TickingClocks/64-Bit/README.md

# 64-Bit
Nixie Tube Clock driven by an STM32F446. Drives 6 IN-12 Nixie Tubes
