TickingClocks/64-Bit/Electrical/PCB Outputs/BOM and Cost.xlsx

Item Number | PCB/Area | Qty | Part Number | Description | Designator | price /each | price total | purchase link | note
1 | Main Board | 13 | GCJ188R71H104KA12D | 0.1uF, 0603 |  | 0.1 | 1.3 | mouser (https://www.mouser.com/ProductDetail/Murata-Electronics/GCJ188R71H104KA12D?qs=zThidflJDvYKuGhiQaflUg%3D%3D)
2 | Main Board | 4 | GRM319R61E106MA12D | 10 uF, 1210 |  | 0.24 | 0.96 | mouser (https://www.mouser.com/ProductDetail/Murata-Electronics/GRM319R61E106MA12D?qs=eeBpzGFlv%252B85QLY8OZY4LA%3D%3D)
3 | Main Board | 4 | CL31A226KAHNNNE | 22 uF, 1210 |  | 0.11 | 0.44 | mouser (https://www.mouser.com/ProductDetail/Samsung-Electro-Mechanics/CL31A226KAHNNNE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)
4 | Main Board | 3 | GRM188R61C105KA12J | 1 uF, 0603 |  | 0.11 | 0.33 | mouser (https://www.mouser.com/ProductDetail/Murata-Electronics/GRM188R61C105KA12J?qs=giATsht9l5zorjRVstolWw%3D%3D)
5 | Main Board | 2 | GRM188R61E475KE11D | 4.7 uF, 0603 |  | 0.1 | 0.2 | mouser (https://www.mouser.com/ProductDetail/Murata-Electronics/GRM188R61E475KE11D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)
6 | Main Board | 2 | GCM1885C2A220JA16D | 22 pF, 0603 |  | 0.1 | 0.2 | mouser (https://www.mouser.com/ProductDetail/Murata-Electronics/GCM1885C2A220JA16D?qs=2YjXvJr3xviMVh6wGaZW%252Bw%3D%3D)
7 | Main Board | 2 | -- | DNP C0603 |  | 0 | 0
8 | Main Board | 2 | GCM188R72A103KA37D | 0.01 uF, 0603 |  | 0.1 | 0.2 | mouser (https://www.mouser.com/ProductDetail/Murata-Electronics/GCM188R72A103KA37D?qs=aEuGZpxfbxXMjTExujWHsg%3D%3D)
9 | Main board | 2 | 860010578017 | 1000uF, radial capacitor, TH |  | 0.9 | 1.8 | mouser (https://www.mouser.com/ProductDetail/Wurth-Elektronik/860010578017?qs=0KOYDY2FL2%252BZYPntKa7lMw%3D%3D)
10 | Main Board | 15 | CRCW060310K0FKECC | 10 kohm, 0603 |  | 0.02 | 0.3 | mouser (https://www.mouser.com/ProductDetail/Vishay/CRCW060310K0FKECC?qs=wd5RIQLrsJjYJGKL%252BLOtbQ%3D%3D)
11 | Main Board | 14 | CRCW0603300RFKEAC | 300 ohm, 0603 |  | 0.02 | 0.28 | mouser (https://www.mouser.com/ProductDetail/Vishay/CRCW0603300RFKEAC?qs=E3Y5ESvWgWMwvWEs%2FXNQHg%3D%3D)
12 | Main Board | 13 | CRCW06031K00FKEAC | 1 kohm, 0603 |  | 0.02 | 0.26 | mouser (https://www.mouser.com/ProductDetail/Vishay/CRCW06031K00FKEAC?qs=E3Y5ESvWgWOQ7ePIWbGVFg%3D%3D)
13 | Main board | 8 | CRCW060322R0FKEAC | 22 ohm, 0603 |  | 0.1 | 0.8 | mouser (https://www.mouser.com/ProductDetail/Vishay/CRCW060322R0FKEAC?qs=E3Y5ESvWgWOyct8zbXvrzA%3D%3D)
14 | Main Board | 6 | CRCW06034K70FKEAC | 4.7 kohm, 0603 |  | 0.1 | 0.6 | mouser (https://www.mouser.com/ProductDetail/Vishay/CRCW06034K70FKEAC?qs=E3Y5ESvWgWMdaA4%252BnoVN0A%3D%3D)
15 | Main Board | 5 | CRCW060336K0FKEA | 36 kohm, 0603 |  | 0.1 | 0.5 | mouser (https://www.mouser.com/ProductDetail/Vishay/CRCW060336K0FKEA?qs=0Yv%252B5xUGNSmcsWBuyiV%2FYQ%3D%3D)
16 | Main Board | 4 | CRCW0603240KFKEA | 240 kohm, 0603 |  | 0.1 | 0.4 | mouser (https://www.mouser.com/ProductDetail/Vishay/CRCW0603240KFKEA?qs=nz%2FDziUe1SwAG9wIRcPL7Q%3D%3D)
17 | Main Board | 4 | -- | NA, 0 ohm, 0603, NA |  | 0 | 0
18 | Main Board | 2 | CRCW2010470RJNEF | 470 ohm, 2010 |  | 0.23 | 0.46 | mouser (https://www.mouser.com/ProductDetail/Vishay/CRCW2010470RJNEF?qs=UHJ2bL150zjnG4YlOSrZlQ%3D%3D)
19 | Main Board | 2 | CRCW251230K0JNEG | 30 kohm, 2512 |  | 0.26 | 0.52 | mouser (https://www.mouser.com/ProductDetail/Vishay/CRCW251230K0JNEG?qs=ushTUU0Ny6kGXVH8pXxR0g%3D%3D)
20 | Main board | 2 | CRCW060315K0FKEA | 15 kohm, 0603 |  | 0.1 | 0.2 | mouser (https://www.mouser.com/ProductDetail/Vishay/CRCW060315K0FKEA?qs=HpYJtD%2F%252BJmIvXVn2C2zFXQ%3D%3D)
21 | Main Board | 2 | CRCW06035K10FKEA | 5.1 kohm, 0603 |  | 0.1 | 0.2 | mouser (https://www.mouser.com/ProductDetail/Vishay/CRCW06035K10FKEA?qs=pfqtYUWm1IVbeSxo5oKU9A%3D%3D)
22 | Main Board | 2 | -- | 0 ohm, 0603 |  | 0.1 | 0.2
23 | Main Board | 1 | CRCW0603200KFKEBC | 200 kohm, 0603 |  | 0.1 | 0.1 | mouser (https://www.mouser.com/ProductDetail/Vishay/CRCW0603200KFKEBC?qs=wd5RIQLrsJiakUnx5aO8PQ%3D%3D)
24 | Main Board | 1 | -- | TH, photoresistor |  | 0.5 | 0.5 | amazon (https://www.amazon.com/eBoot-Photoresistor-Sensitive-Resistor-Dependent/dp/B01N7V536K)
25 | Main Board | 40 | CG0603MLC-05LE | 0603, Bidirectional TVS Diode |  | 0.14 | 5.6 | mouser (https://www.mouser.com/ProductDetail/Bourns/CG0603MLC-05LE?qs=m8myXnDJXpVyWtNNhuqisQ%3D%3D)
26 | Main Board | 2 | SK54BLF-R1_00001 | diode |  | 0.69 | 1.38 | mouser (https://www.mouser.com/ProductDetail/Panjit/SK54BLF_R1_00001?qs=sPbYRqrBIVk6ny5Uu6rUPg%3D%3D)
27 | Main Board | 1 | APG1608SURKC/T | Red LED, 0603 |  | 0.23 | 0.23 | mouser (https://www.mouser.com/ProductDetail/Kingbright/APG1608SURKC-T?qs=uxmOeTEqoPxGH1cbvEL84g%3D%3D)
28 | Main Board | 1 | APG1608CGKC/T | Green LED, 0603 |  | 0.23 | 0.23 | mouser (https://www.mouser.com/ProductDetail/Kingbright/APG1608CGKC-T?qs=uxmOeTEqoPwOMdoDiWi4nA%3D%3D)
29 | Main Board | 1 | APG1608QBC/D | Blue LED, 0603 |  | 0.45 | 0.45 | mouser (https://www.mouser.com/ProductDetail/Kingbright/APG1608QBC-D?qs=uxmOeTEqoPzUQ%252B6SHl8a5A%3D%3D)
30 | Main Board | 3 | 74HC3G34DC,125 | Signal level shifter, 3 channel |  | 1.24 | 3.72 | mouser (https://www.mouser.com/ProductDetail/Nexperia/74HC3G34DC125?qs=P62ublwmbi%252B8B4VZQ89Dzw%3D%3D)
31 | Main board | 1 | STM32F446RETx | Main STM32 Microcontroller |  | 7.55 | 7.55 | mouser (https://www.mouser.com/ProductDetail/STMicroelectronics/STM32F446RET6?qs=Ok1pvOkw6%2FqpQsWf8F4wtQ%3D%3D)
32 | Main board | 1 | PCA9306DCUR | I2C Level Shifter |  | 0.67 | 0.67 | mouser (https://www.mouser.com/ProductDetail/Texas-Instruments/PCA9306DCUR?qs=wgAEGBTxy7nQr5PRxNBUNA%3D%3D)
33 | Main Board | 1 | DS1307 | I2C RTC |  | 4.65 | 4.65 | mouser (https://www.mouser.com/ProductDetail/Analog-Devices-Maxim-Integrated/DS1307Z%2bTR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)
34 | Main Board | 1 | EN12-VS20AF20 | Encoder w button, RA |  | 1.3 | 1.3 | mouser (https://www.mouser.com/ProductDetail/BI-Technologies-TT-Electronics/EN12-VS20AF20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)
35 | Main Board | 1 | 24LC64F-I/SN | I2C EEPROM |  | 0.5 | 0.5 | mouser (https://www.mouser.com/ProductDetail/Microchip-Technology/24LC64F-I-SN?qs=WqWCsLCZBkrFG%252B0OmVeJ8Q%3D%3D)
36 | Main Board | 1 | ESP32-C6-LCD-1.47 | ESP32-C6 1.47" LCD dev board |  | 20 | 20 | amazon (https://www.amazon.com/Waveshare-Development-Frequency-Single-Core-Processor/dp/B0DHTMYTCY)
37 | Main Board | 2 | -- | female headers for ESP board |  | 0 | 0 |  | use what I have at home
38 | Main Board | 1 | VEML7700-TR | I2C, high resolution ambient light sensor |  | 0.83 | 0.83 | mouser (https://www.mouser.com/ProductDetail/Vishay-Semiconductors/VEML7700-TR?qs=BcfjnG7NVaWcZHs8m27pyQ%3D%3D)
39 | Main Board | 2 | CM8V-T1A-32.768kHz-12.5pF-20PPM-TA-QC | 32.768kHz crystals |  | 0.38 | 0.76 | mouser (https://www.mouser.com/ProductDetail/Micro-Crystal/CM8V-T1A-32.768kHz-12.5pF-20PPM-TA-QC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)
40 | Main Board | 1 | ECS-160-20-33-TR3 | 16 mHz crystal |  | 0.37 | 0.37 | mouser (https://www.mouser.com/ProductDetail/ECS/ECS-160-20-33-TR3?qs=e8oIoAS2J1R7I5xgTslvVQ%3D%3D)
41 | Main Board | 1 | L102011MS02Q | Power source switch, TH |  | 3.54 | 3.54 | mouser (https://www.mouser.com/ProductDetail/CK/L102011MS02Q?qs=m%252BSHaab3AgrintD9BMqbYQ%3D%3D)
42 | Main Board | 8 | 1985195 | spring wire connector |  | 0.37 | 2.96 | mouser (https://www.mouser.com/ProductDetail/Phoenix-Contact/1985195?qs=nq%2FEIFkB2fEpUV%252BqAaKYzQ%3D%3D)
43 | Main Board | 7 | 2N7002 | 2N7002 |  | 0.52 | 3.64 | mouser (https://www.mouser.com/ProductDetail/onsemi-Fairchild/2N7002?qs=0dwsXDNhqlz66WJJhrTFjQ%3D%3D)
44 | Main Board | 4 | XP231P0201TR-G | P Channel Mosfet |  | 0.26 | 1.04 | mouser (https://www.mouser.com/ProductDetail/Torex-Semiconductor/XP231P0201TR-G?qs=BJlw7L4Cy798pkoM8NVD2Q%3D%3D)
45 | Main Board | 3 | JS-12N-K | high voltage relays |  | 2.93 | 8.79 | mouser (https://www.mouser.com/ProductDetail/FCL-Components/JS-12N-K?qs=%2FFYF3x1u%252Buf98G1in7NiWA%3D%3D)
46 | Main Board | 2 | AZ1117CH2-5.0TRG1 | 5V LDO |  | 0.22 | 0.44 | mouser (https://www.mouser.com/ProductDetail/Diodes-Incorporated/AZ1117CH2-5.0TRG1?qs=5V6w%252Be2aIqb578qtLdqPjw%3D%3D)
47 | Main Board | 2 | AZ1117CH2-3.3TRG1 | 3.3V LDO |  | 0.22 | 0.44 | mouser (https://www.mouser.com/ProductDetail/Diodes-Incorporated/AZ1117CH2-3.3TRG1?qs=lQAVKuKFhkLc7jCxso2G3w%3D%3D)
48 | Main Board | 1 | BAT-HLD-001 | CR2032 Battery Holder |  | 0.38 | 0.38 | mouser (https://www.mouser.com/ProductDetail/TE-Connectivity-Linx-Technologies/BAT-HLD-001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)
49 | Main Board | 2 | -- | pin header jumper |  | 0 | 0 |  | use what I already have
50 | Main Board | 1 | PR30-5V-450-1A-E | relay, 5V coil |  | 1.11 | 1.11 | mouser (https://www.mouser.com/ProductDetail/Same-Sky/PR30-5V-450-1A-E?qs=ZcfC38r4Potim%2FTJWnEvrQ%3D%3D)
51 | Main Board | 1 | PR30-12V-450-1A-E | relay, 12V coil |  | 1.37 | 1.37 | mouser (https://www.mouser.com/ProductDetail/Same-Sky/PR30-12V-450-1A-E?qs=ZcfC38r4Pot83EsX0vii6w%3D%3D)
52 | Main Board | 1 | XL6009 Module | boost converter module |  | 2 | 2 | amazon (https://www.amazon.com/dp/B0C81RQ4CN?ref_=ppx_hzsearch_conn_dt_b_fed_asin_title_2)
53 | Main Board | 1 | -- | high voltage power supply module |  | 11 | 11 | amazon (https://www.amazon.com/dp/B09D93QNYK?ref_=ppx_hzsearch_conn_dt_b_fed_asin_title_1&th=1)
54 | Main Board | 10 | M20-7920242R | female, SMT, 4 pin dupont connector |  | 0.81 | 8.1 | mouser (https://www.mouser.com/ProductDetail/Harwin/M20-7920242R?qs=k41KVqW3ymqXpU6ZyqY%252B2g%3D%3D)
55 | Main Board | 3 | 61301021821 | female board to board connectors |  | 1.58 | 4.74 | mouser (https://www.mouser.com/ProductDetail/Wurth-Elektronik/61301021021?qs=ZtY9WdtwX56X%2F8LrwHRgHg%3D%3D)
56 | Main Board | 1 | USB4216-03-A | USB C Connector |  | 0.62 | 0.62 | mouser (https://www.mouser.com/ProductDetail/GCT/USB4216-03-A?qs=Tc%252BHE9vUsnv1G2UWLFIexA%3D%3D)
57 | Main Board | 1 | PJ-102A | Power Connector |  | 0.58 | 0.58 | mouser (https://www.mouser.com/ProductDetail/Same-Sky/PJ-102A?qs=WyjlAZoYn50UKjtnxOz%252Bqg%3D%3D)
58 | Main Board | 1 | 97384645 | Coin cell |  | 0.34 | 0.34 | mouser (https://www.mouser.com/Tools/Project/Details?projectGUID=67f004be-61d0-41fa-bba2-e4882123ddfc)
59 | Display Board | 8 | GCJ188R71H104KA12D | 0.1 uF, 0603 |  | 0.1 | 0.8 | mouser (https://www.mouser.com/ProductDetail/Murata-Electronics/GCJ188R71H104KA12D?qs=zThidflJDvYKuGhiQaflUg%3D%3D)
60 | Display Board | 6 | CRCW1210249KFKEA | 249 kohm, 1210 |  | 0.19 | 1.14 | mouser (https://www.mouser.com/ProductDetail/Vishay/CRCW1210249KFKEA?qs=u0pLYIWDdLeW%252BEKXIu9Hbg%3D%3D)
61 | Display Board | 6 | CRCW121015K0FKEA | 15 kohm, 1210 |  | 0.12 | 0.72 | mouser (https://www.mouser.com/ProductDetail/Vishay/CRCW121015K0FKEA?qs=bw5uWrxixdSFp1cY0NcfxA%3D%3D)
62 | Display board | 6 | CG0603MLC-05LE | 0603, bidirectional TVS Diodes |  | 0.14 | 0.84 | mouser (https://www.mouser.com/ProductDetail/Bourns/CG0603MLC-05LE?qs=m8myXnDJXpVyWtNNhuqisQ%3D%3D)
63 | Display Board | 8 | TPIC6B595 | HV shift registers |  | 1.47 | 11.76 | mouser (https://www.mouser.com/ProductDetail/Texas-Instruments/TPIC6B595DWR?qs=w32V8uFkMxk11fsXFu3cTA%3D%3D)
64 | Display Board | 6 | IN-12A | Nixie Tubes |  |  | 50 | ebay (https://www.ebay.com/itm/141833775275?_skw=in12+nixie&itmmeta=01KBBYV0734VEJCEHVSZM2ANAR)
65 | Display Board | 72 | -- | 1mm nixie tube pin socket |  |  | 10 | amazon (https://www.amazon.com/dp/B09D2VQR3Q?ref_=ppx_hzsearch_conn_dt_b_fed_asin_title_7&th=1)
66 | Display Board | 6 | INS-1 | Neon Bulb |  |  | 20 | ebay (https://www.ebay.com/itm/227032759689?_skw=ins-1&itmmeta=01KBBYYDXXQJ9ZTY8F34NHPWKH)
67 | Display Board | 6 | 3D print | INS-1 3D Printed bases |  | 0 | 0 |  | negligible price in plastic
68 | Display Board | 3 | -- | 3 pin, pin socket connector |  | 0 | 0 |  | use what I already have
69 | Display Board | 3 | 610110249121 | smt board to board connectors |  | 2.16 | 6.48 | mouser (https://www.mouser.com/ProductDetail/Wurth-Elektronik/610110249121?qs=a9WhcLg8qCzIr%252B0m4JFDmA%3D%3D)
70 | LED Board | 6 | GCJ188R71H104KA12D | 0.1 uF, 0603 |  | 0.1 | 0.6 | mouser (https://www.mouser.com/ProductDetail/Murata-Electronics/GCJ188R71H104KA12D?qs=zThidflJDvYKuGhiQaflUg%3D%3D)
71 | LED Board | 1 | CRCW0603300RFKEAC | 300 ohm, 0603 |  | 0.1 | 0.1 | mouser (https://www.mouser.com/ProductDetail/Vishay/CRCW0603300RFKEAC?qs=E3Y5ESvWgWMwvWEs%2FXNQHg%3D%3D)
72 | LED Board | 6 | WS2812B | Addressable RGB LEDs |  | 0 | 0 |  | use what I already have
73 | LED Board | 2 |  | 3 pin, pin header connector |  | 0 | 0 |  | use what I already have
74 | Case/Frame | 1 |  | 3D printed base |  |  | 3 |  | assuming plastic cost here
75 | Case/Frame |  |  | Picture pane glass |  |  | 19 | amazon (https://www.amazon.com/dp/B0BWDWKTB6?ref_=ppx_hzsearch_conn_dt_b_fed_asin_title_1&th=1)
76 | Case/Frame |  |  | brass m3 standoffs |  |  | 15 | amazon (http://amazon.com/Csdtylh-Male-Female-Standoff-Stainless-Assortment/dp/B06Y5TJXY1)
77 | Case/Frame |  |  | brass m3 acorn nuts
78 | Case/Frame |  |  | copper conductive tape |  |  | 6 | amazon (https://www.amazon.com/dp/B09WGYP2VR?ref_=ppx_hzsearch_conn_dt_b_fed_asin_title_3)
79 | Case/Frame |  |  | spring pogo pins |  |  | 7 | amazon (https://www.amazon.com/dp/B0F48W46WZ?ref_=ppx_hzsearch_conn_dt_b_fed_asin_title_6)
80 | Case/Frame |  |  | wires |  |  | 0 |  | use what I already have
81 | Case/Frame |  |  | Connectors |  |  | 0
82 | Case/Frame |  |  | capacitive buttons |  |  | 6 | amazon (https://www.amazon.com/dp/B0BFZXP1D8?ref_=ppx_hzsearch_conn_dt_b_fed_asin_title_2)
83 | Case/Frame |  |  | lead weights |  |  | 21 | amazon (https://www.amazon.com/dp/B06XDG1JJH?ref_=ppx_hzsearch_conn_dt_b_fed_asin_title_1&th=1)
84 | Case/Frame |  |  | usbA male -> usbC female adapter |  |  | 5.5 | amazon (http://amazon.com/Adapter-Transfer-Connector-Bi-Directional-Extension/dp/B0DT4FMHF2?nsdOptOutParam=true)
85 | Case/Frame |  |  | stm32 programmer |  |  | 6 | amazon (https://www.amazon.com/AITRIP-Emulator-Downloader-Programmer-STM32F103C8T6/dp/B0D22S8WVX)
86 | Case/Frame |  |  | m3 screws |  |  | 0 |  | use what I already have
87 | PCB | 5 | Main Board PCB | Main Board PCB, black solder mask, ENIG |  | 0 | 75.53 |  | min x5 order required
88 | PCB | 5 | Display Board PCB | Display Board PCB, black solder mask, ENIG |  | 0 | 72.63 |  | min x5 order required
89 | PCB | 5 | LED Board PCB | LED Board PCB, black solder mask, ENIG |  | 0 | 22.2 |  | min x5 order required
90 | Stencil | 2 | solder stencils for Main board | solder stencils for SMT assembly |  | 7 | 14
91 | Stencil | 2 | solder stencils for display board | solder stencils for SMT assembly |  | 7 | 14
92 | Stencil | 1 | LED Board Solder Stencil | Solder stencils for SMT assembly |  | 7 | 7
93 | Shipping | 1 | PCB and stencils shipping | shipping for the PCBs |  | 0 | 140
94 | shipping | 1 | shipping for Mouser parts | Mouser shipping |  | 8.99 | 8.99
95 | Tariff | 1 | Mouser Parts estimated tariff |  |  | 0 | 0
96 | Tariff | 1 | JLC PCB Parts estimated tariff |  |  | 0 | 160
 |  |  | total (pcbs and customs) | total (parts not pcbs) | Total (min to build 1)
 |  |  | 514.35 | 301.02 | 815.37
 |  |  | Cost of 1 clock assuming 2 are made | Cost of 1 clock assuming 3 are made
 |  |  | 558.195 | 472.47
