TickingClocks/64-Bit/Electrical/PCB Outputs/64 Bit - Display Board/3D prints/ins-1 standoff/INS-1 standdoff.SLDPRT

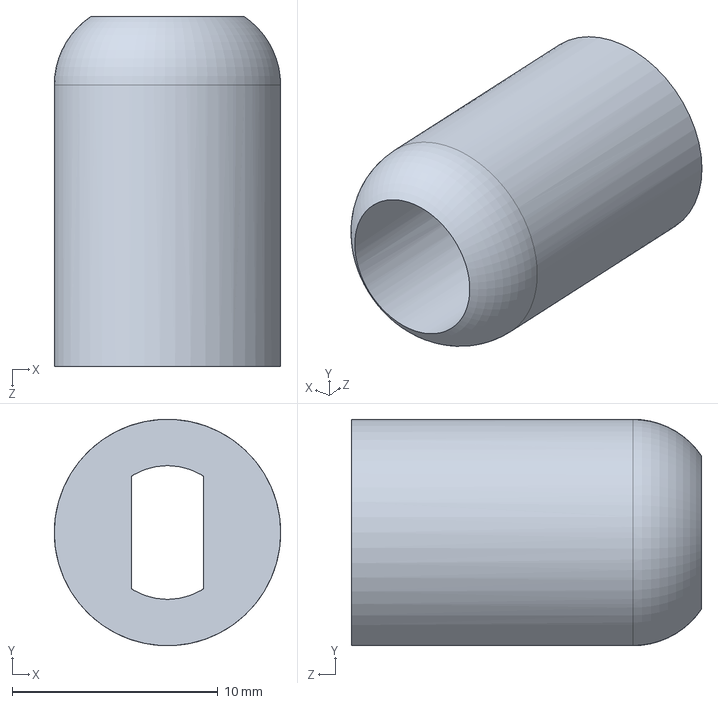
[picture p1: CAD file, 2025-12-22]
Electrical/PCB Outputs/64 Bit - Display Board/3D prints/ins-1 standoff/INS-1 standdoff.SLDPRT
11.0 x 11.0 x 17.0 mm
