TickingClocks/64-Bit/(list of files, cad)

Other CAD files:
Electrical/PCB Outputs/64 Bit - Display Board/3D prints/Paste and Assembly Jig/64Bit - Display Board - Paste and assembly jig_V1.STEP
Electrical/PCB Outputs/64 Bit - Main Board/3D Prints/Paste and assembly jig/64Bit - Main Board - Paste and assembly jig_V1.STEP
Electrical/PCB Outputs/64 Bit - Main Board/step/64 Bit - main board V1 (basic)_barePCB.step
Electrical/PCB Outputs/64 Bit - Main Board/step/64 Bit - main board V1_barePCB.step
Electrical/PCB Outputs/64 Bit - Display Board/step/64 Bit Display Board.step
Electrical/PCB Outputs/64 Bit - LED Board/step/64 Bit LED Board_V1.step
Electrical/PCB Outputs/64 Bit - Display Board/step/64 Bit Display Board_BlankPCB.step
Electrical/PCB Outputs/64 Bit - Display Board/3D prints/ins-1 standoff/INS-1 standdoff_v4.STEP
Electrical/PCB Outputs/64 Bit - Display Board/3D prints/ins-1 standoff/INS-1 standdoff_v2.STEP
Electrical/PCB Outputs/64 Bit - Display Board/3D prints/ins-1 standoff/INS-1 standdoff_v3.STEP
Electrical/PCB Outputs/64 Bit - Display Board/3D prints/Paste and Assembly Jig/64Bit - Display Board - Paste and assembly jig_V1.SLDPRT
Electrical/PCB Outputs/64 Bit - Main Board/3D Prints/Paste and assembly jig/64Bit - Main Board - Paste and assembly jig_V1.SLDPRT
