TickingClocks/64-Bit/Electrical/PCB Outputs/64 Bit - Main Board/Schematics/64 Bit - Main Board.pdf

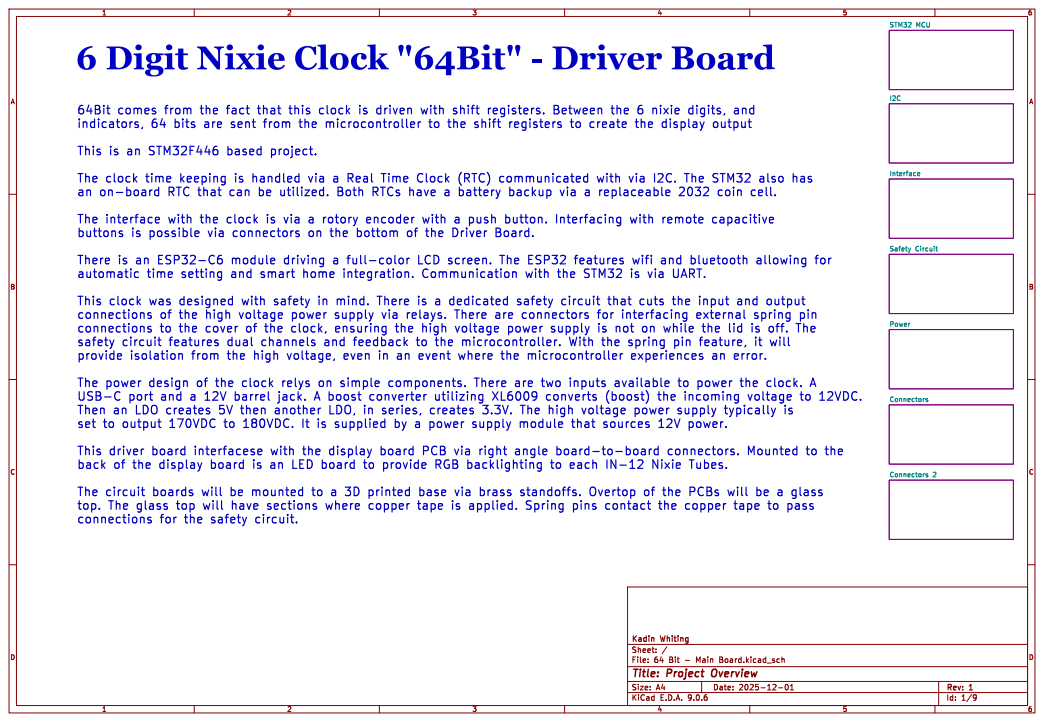
[picture p2: page 1]

6 Digit Nixie Clock "64Bit" - Driver Board

Id: 1/9 Title: Project Overview

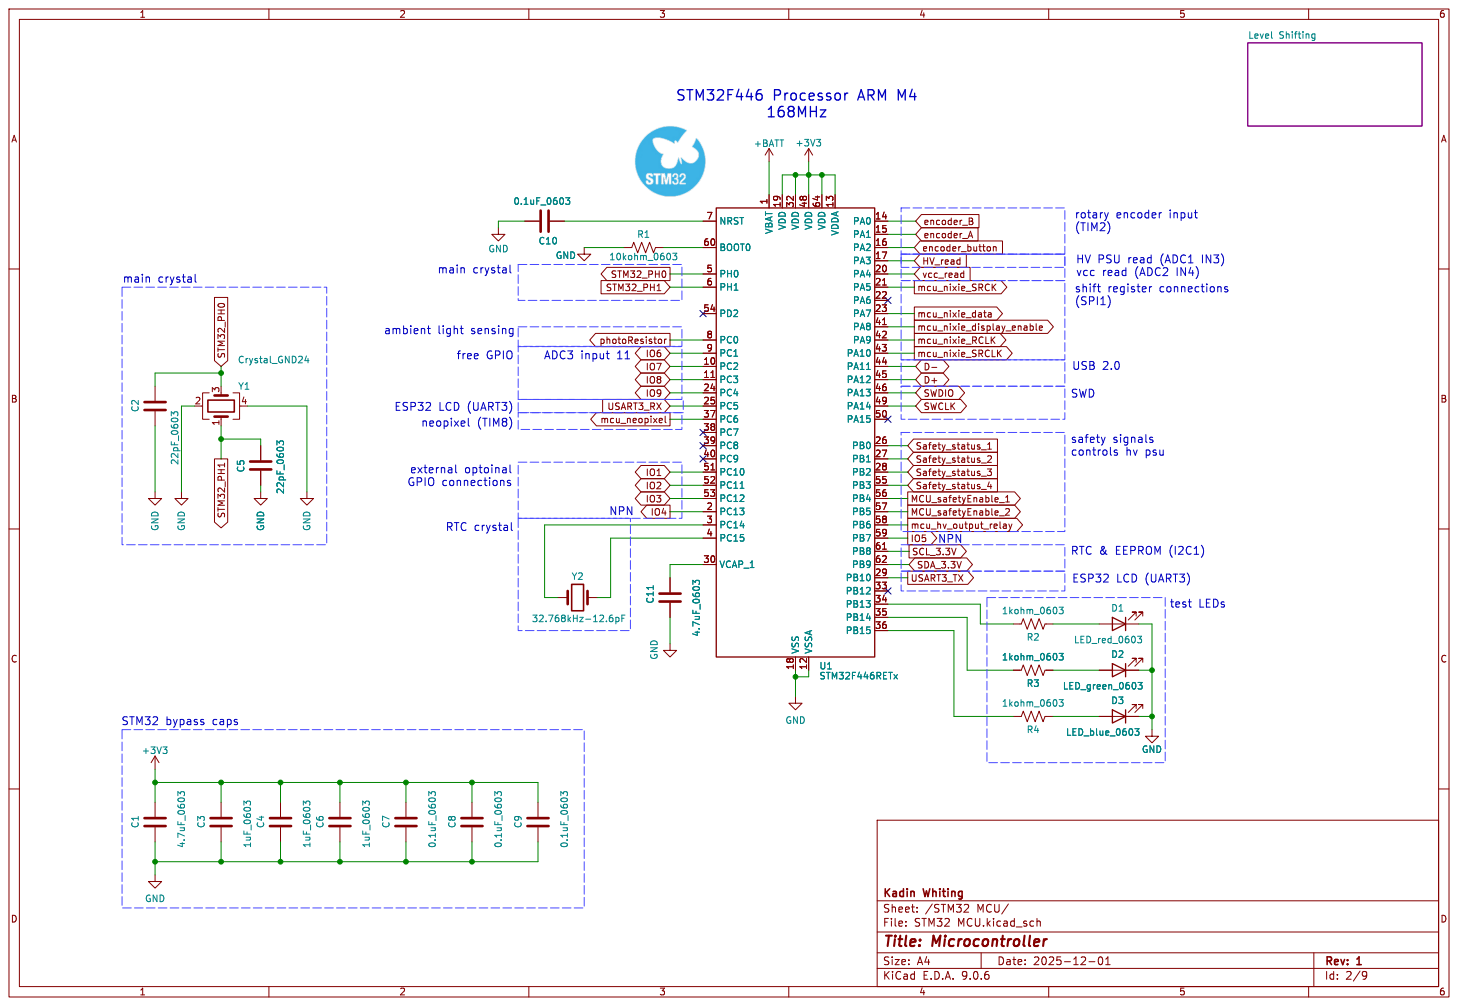
[picture p3: page 2]

1 VDD 19 VDD 32 VSS 18 VDD 48 VSSA 12 VDD 64 VDDA 13 PA0 14 PA1 15 PA2 16 PA3 17 PA4 20 PA5 21 PA6 22 PA7 23 PA8 41 PA9 42 PA10 43 PA11 44 PA12 45 PA13 46 PA14 49 PA15 50 PB0 26 PB1 27 PB2 28 PB3 55 PB4 56 PB5 57 PB6 58 PB7 59 PB8 61 PB9 62 PB10 29 PB12 33 PB13 34 PB14 35 PB15 36 U1STM32F446RETx 1

1 VDD 19 VDD 32 VSS 18 VDD 48 VSSA 12 VDD 64 VDDA 13 PA0 14 PA1 15 PA2 16 PA3 17 PA4 20 PA5 21 PA6 22 PA7 23 PA8 41 PA9 42 PA10 43 PA11 44 PA12 45 PA13 46 PA14 49 PA15 50 PB0 26 PB1 27 PB2 28 PB3 55 PB4 56 PB5 57 PB6 58 PB7 59 PB8 61 PB9 62 PB10 29 PB12 33 PB13 34 PB14 35 PB15 36 GND

HV PSU read (ADC1 IN3) vcc read (ADC2 IN4)

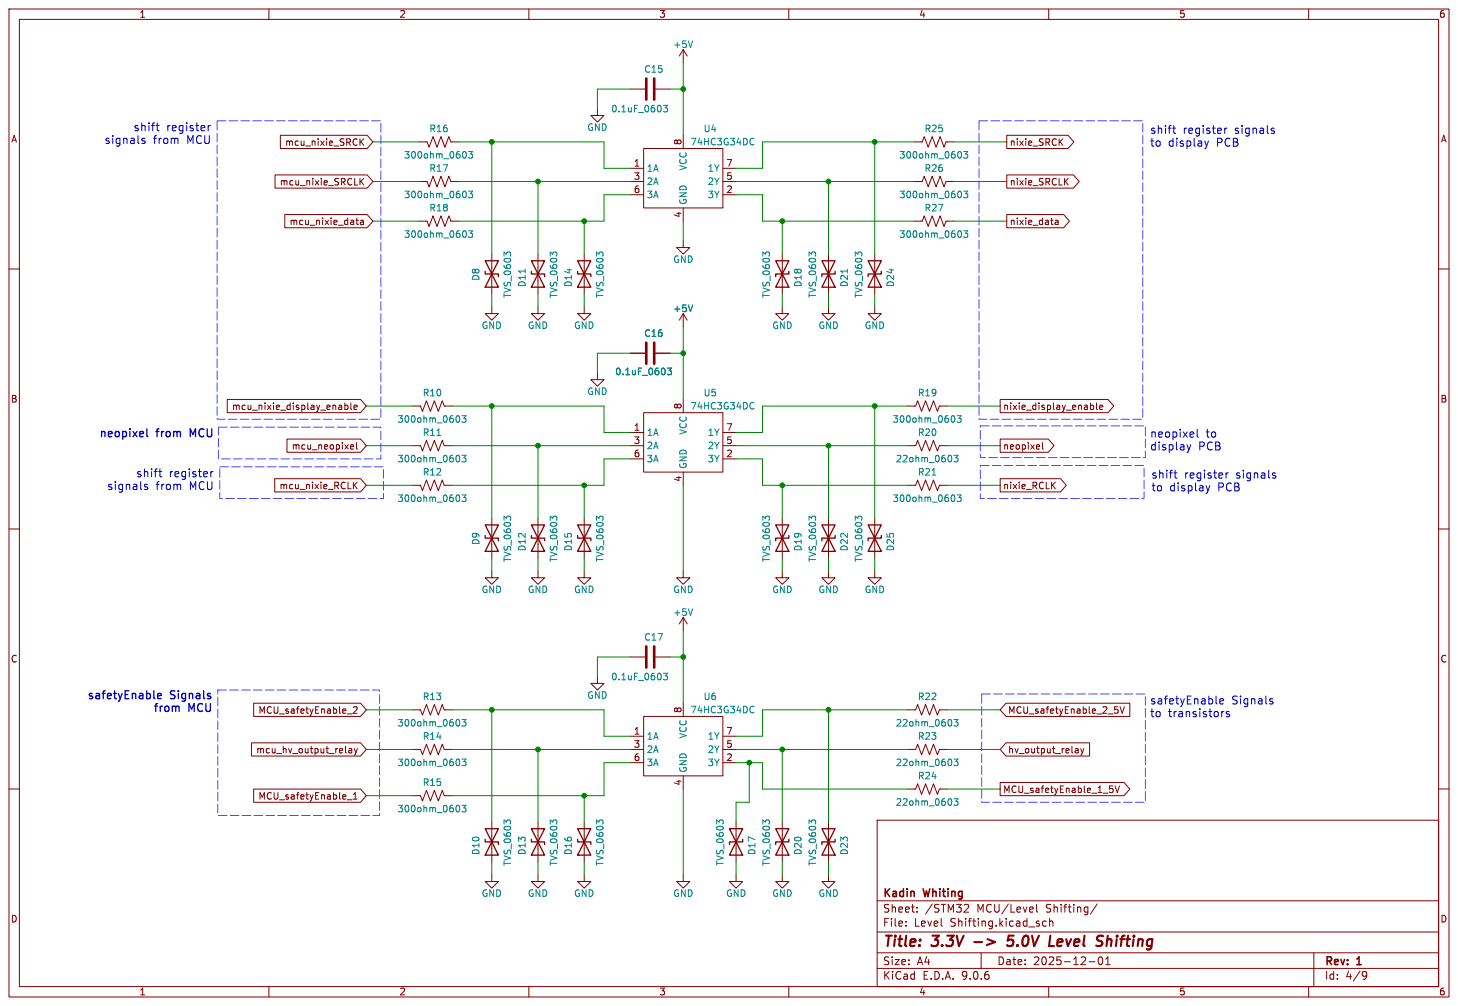
[picture p4: page 3]

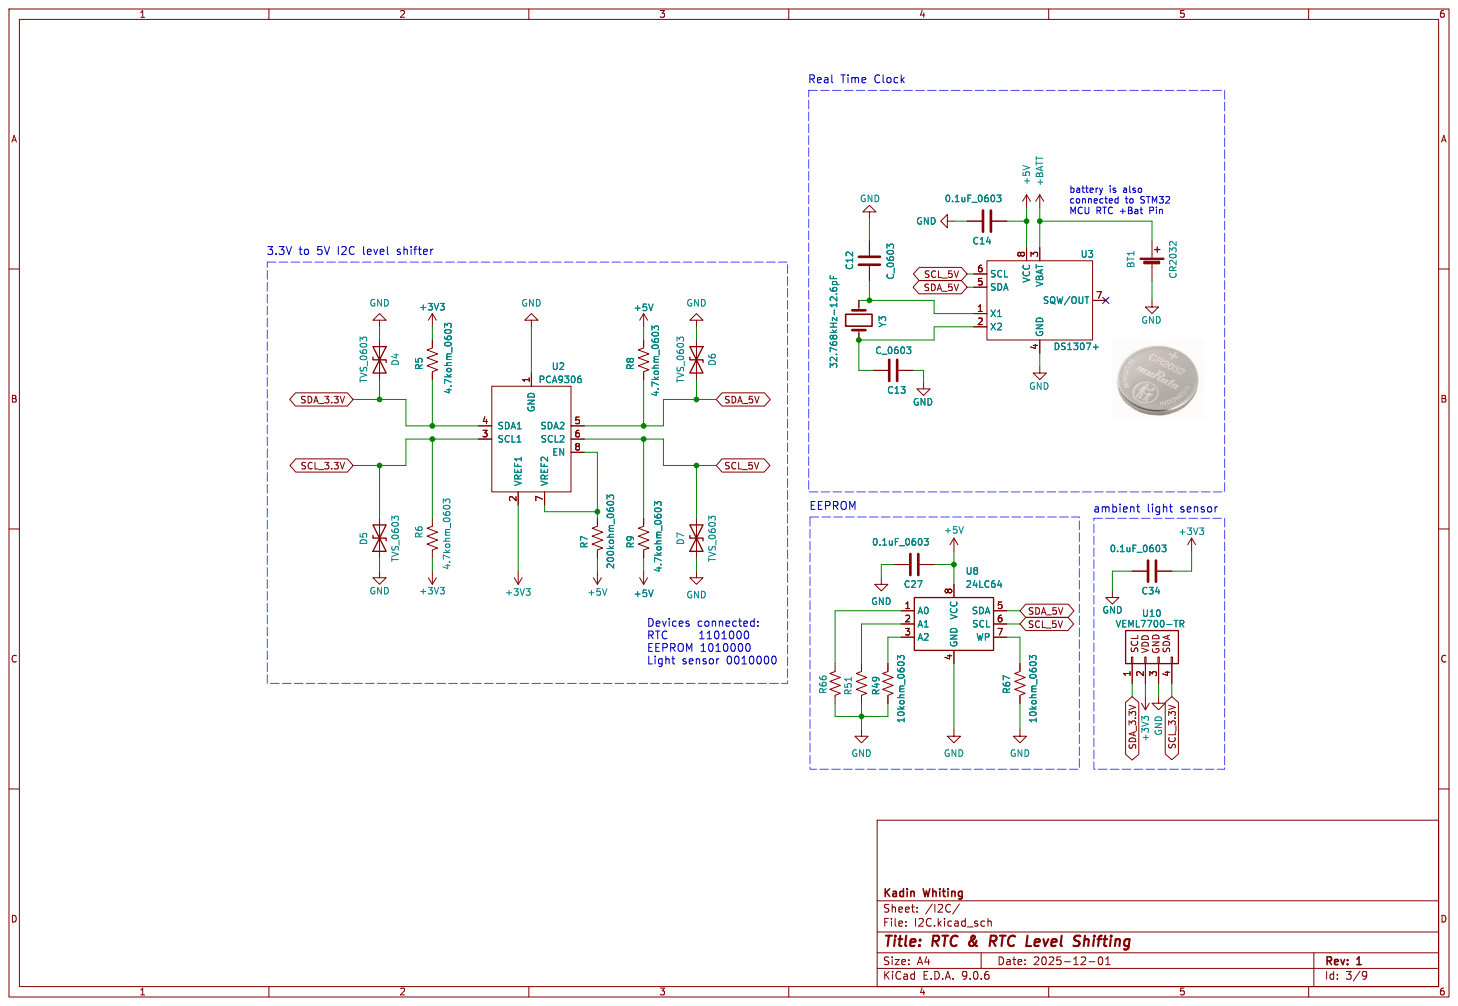
[picture p5: page 4]

File: I2C.kicad_sch Sheet: /I2C/ Kadin Whiting

Id: 3/9 Title: RTC & RTC Level Shifting

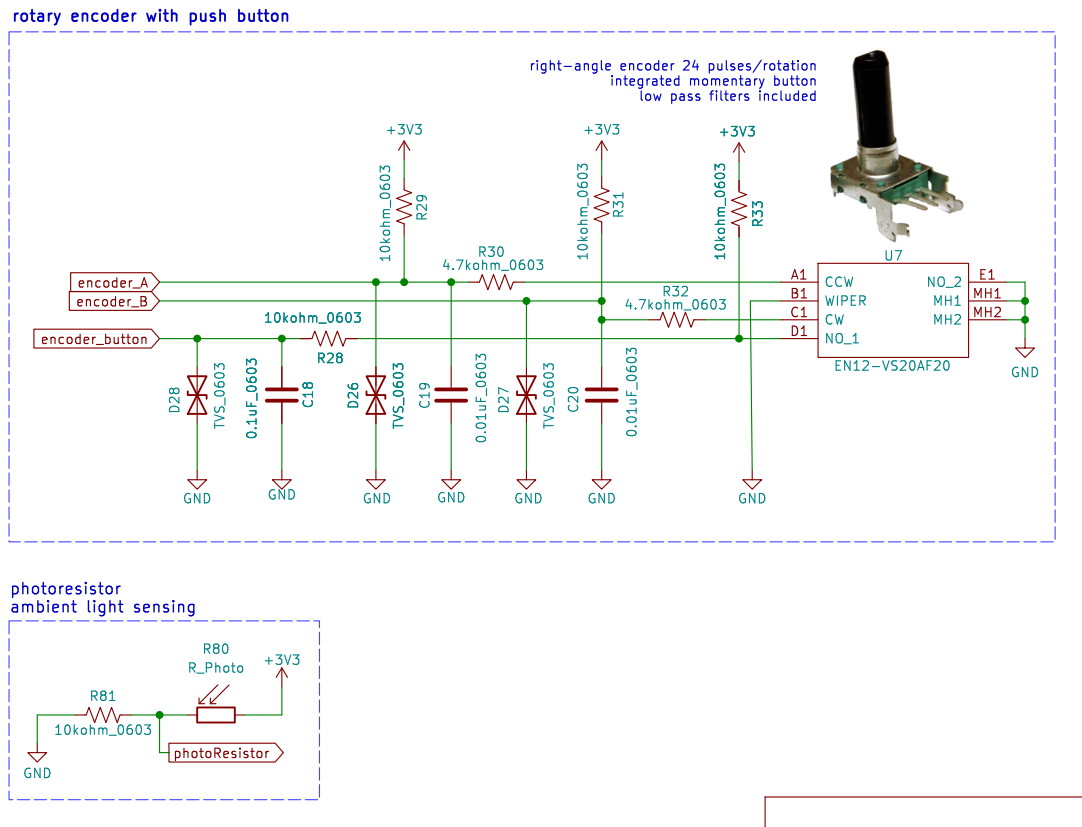
[picture p6: page 5]

encoder_B photoresistor ambient light sensing

Id: 5/9 Title: Interface - Rotary Encoder File: Interface.kicad_sch Sheet: /Interface/ Kadin Whiting R81

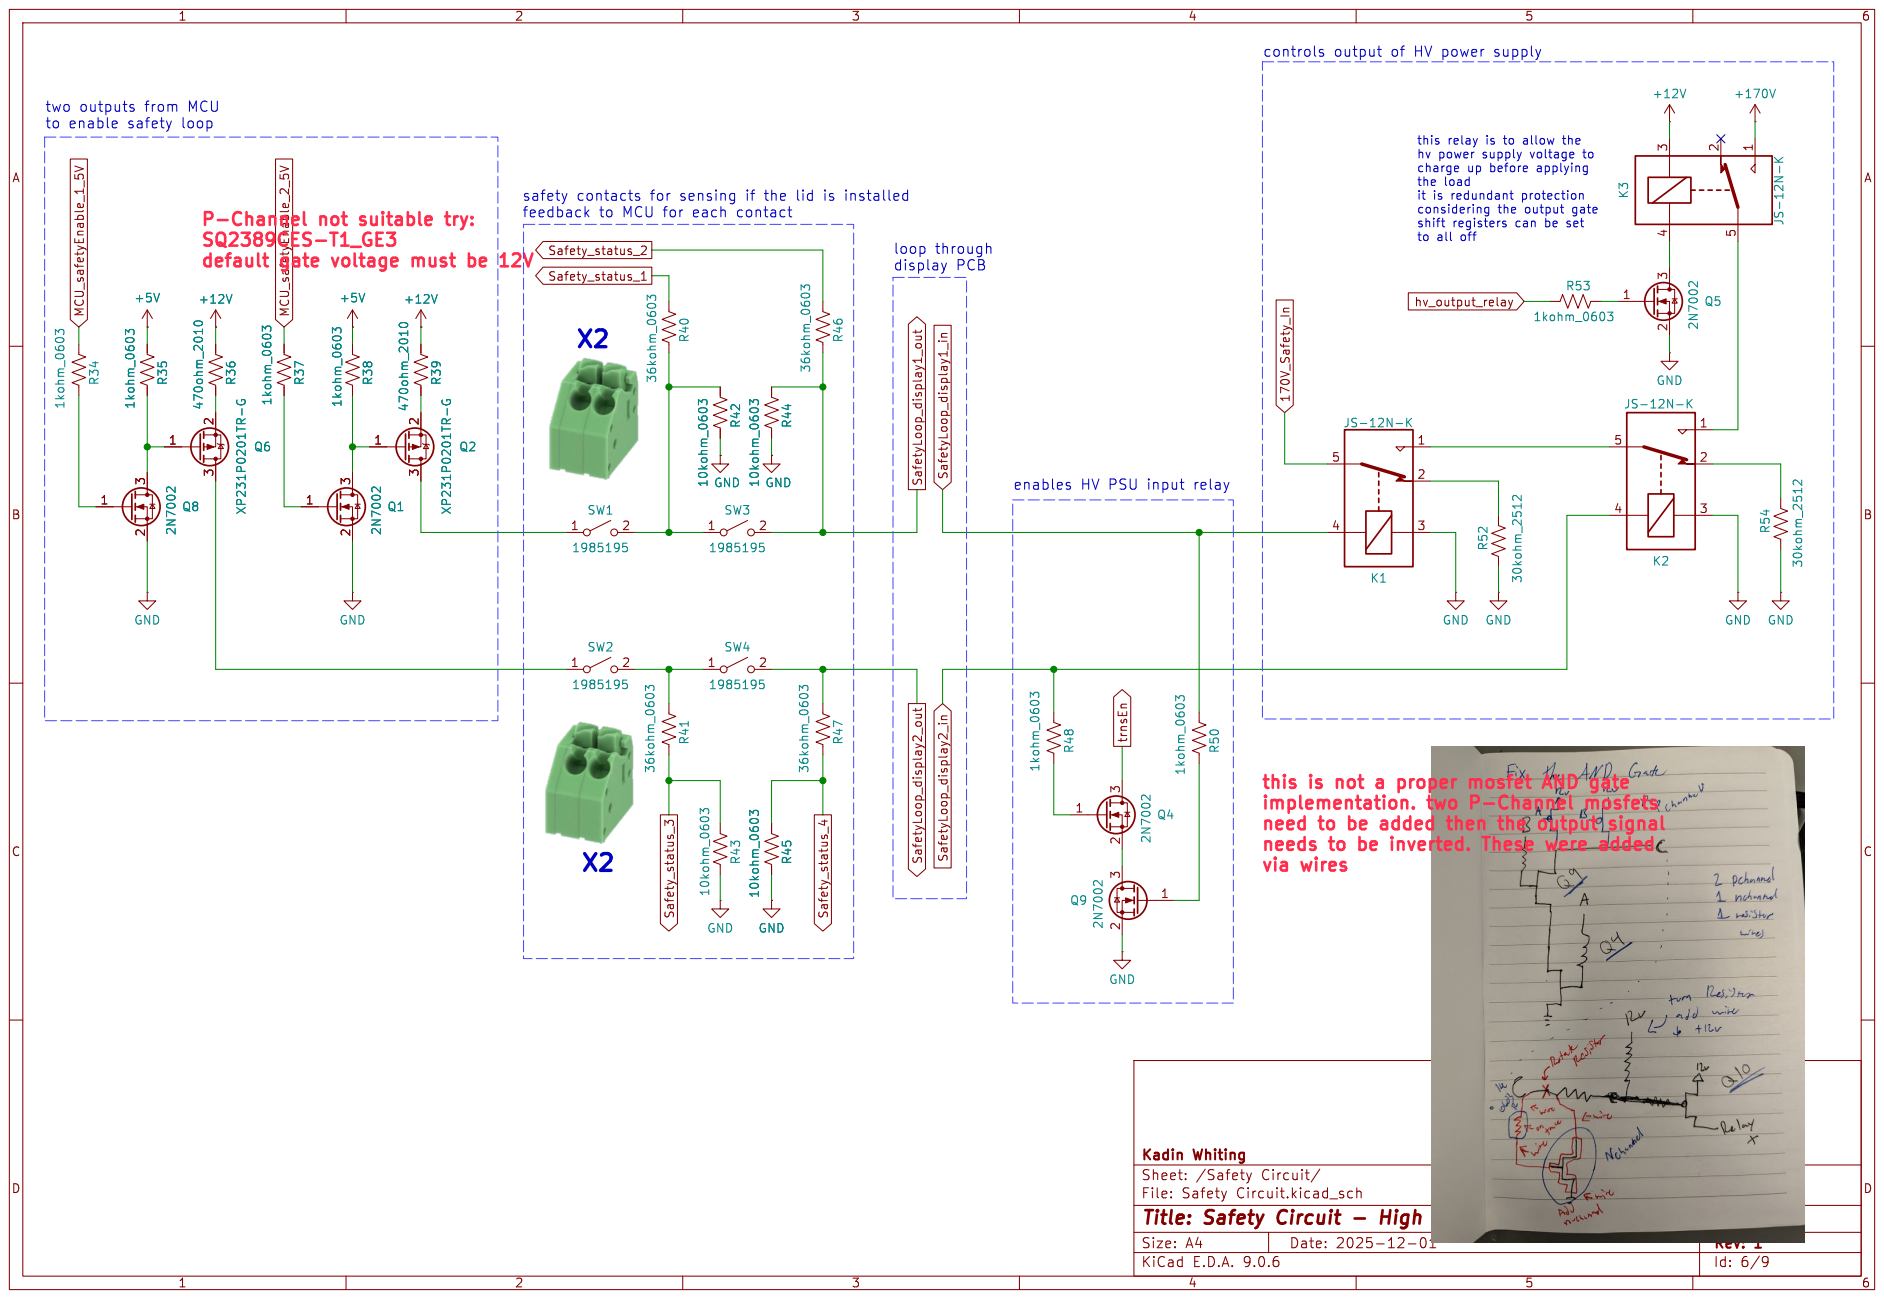
[picture p7: page 6]

+170V R34 1kohm_0603
two outputs from MCU
to enable safety loop

this relay is to allow the
hv power supply voltage to
charge up before applying
the load

SQ2389CES-T1_GE3
default gate voltage must be 12V

this is not a proper mosfet AND gate
need to be added then the output signal
needs to be inverted. These were added
via wires

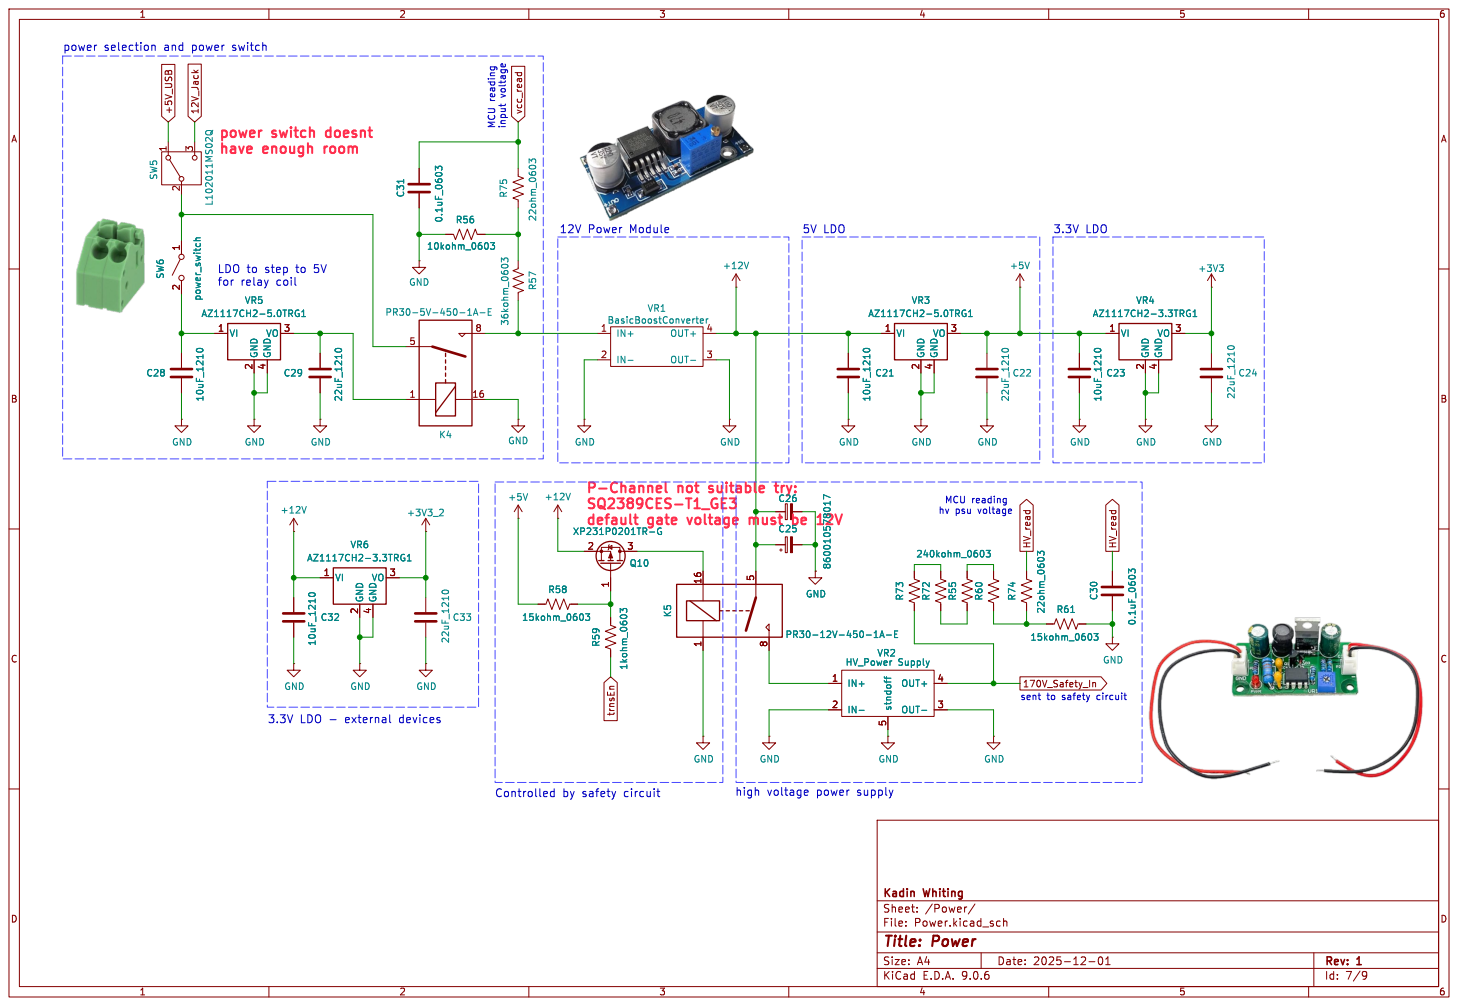
[picture p8: page 7]

high voltage power supply MCU reading input voltage

sent to safety circuit power switch doesnt
have enough room

LDO to step to 5V

SQ2389CES-T1_GE3
default gate voltage must be 12V

Id: 7/9 Title: Power File: Power.kicad_sch Sheet: /Power/ Kadin Whiting

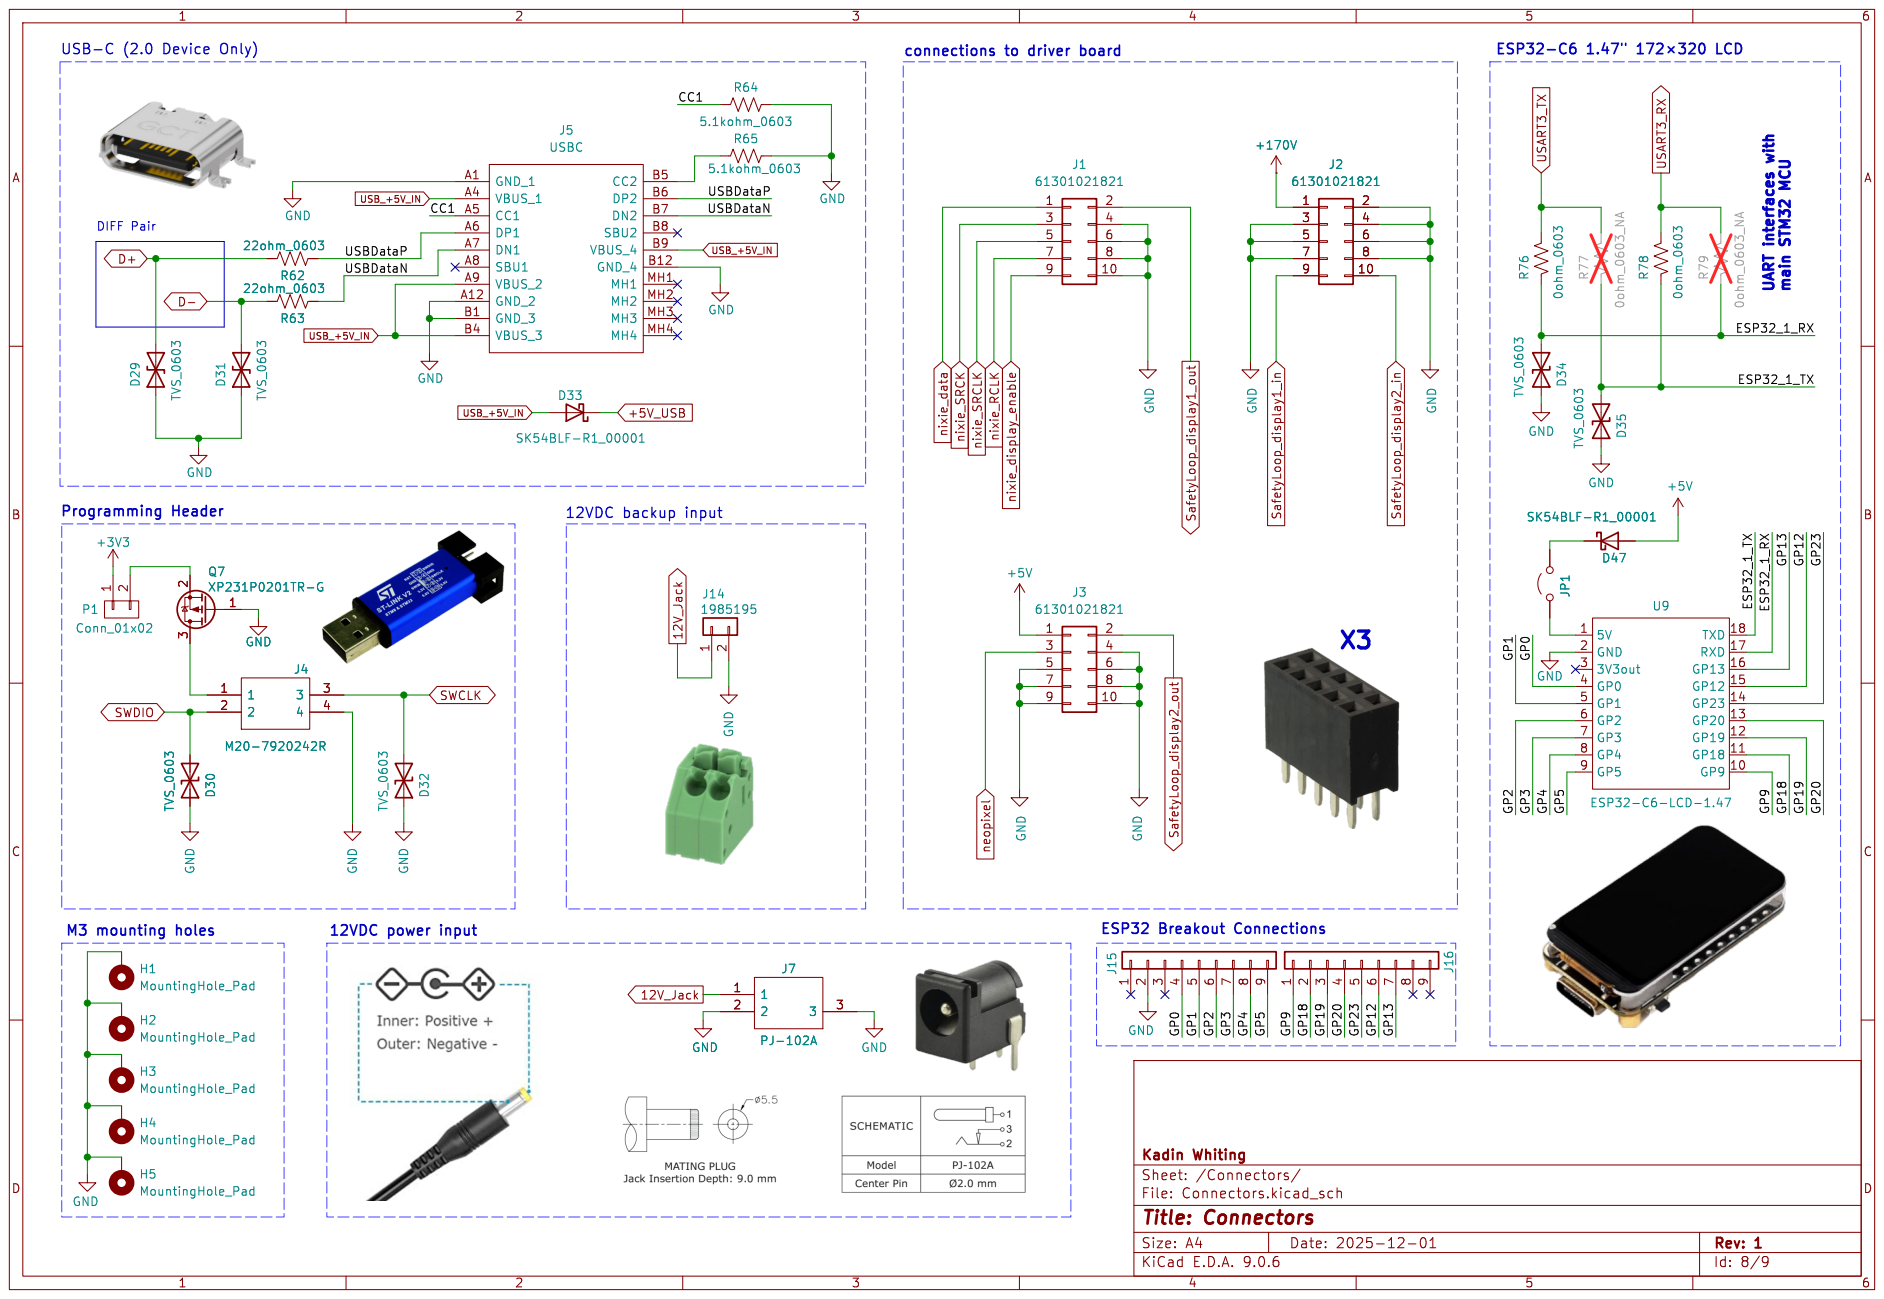
[picture p9: page 8]

9 J15 GND GND D29 TVS_0603 D31 GND TVS_0603 GND GND GND
USB_+5V_IN D- D+

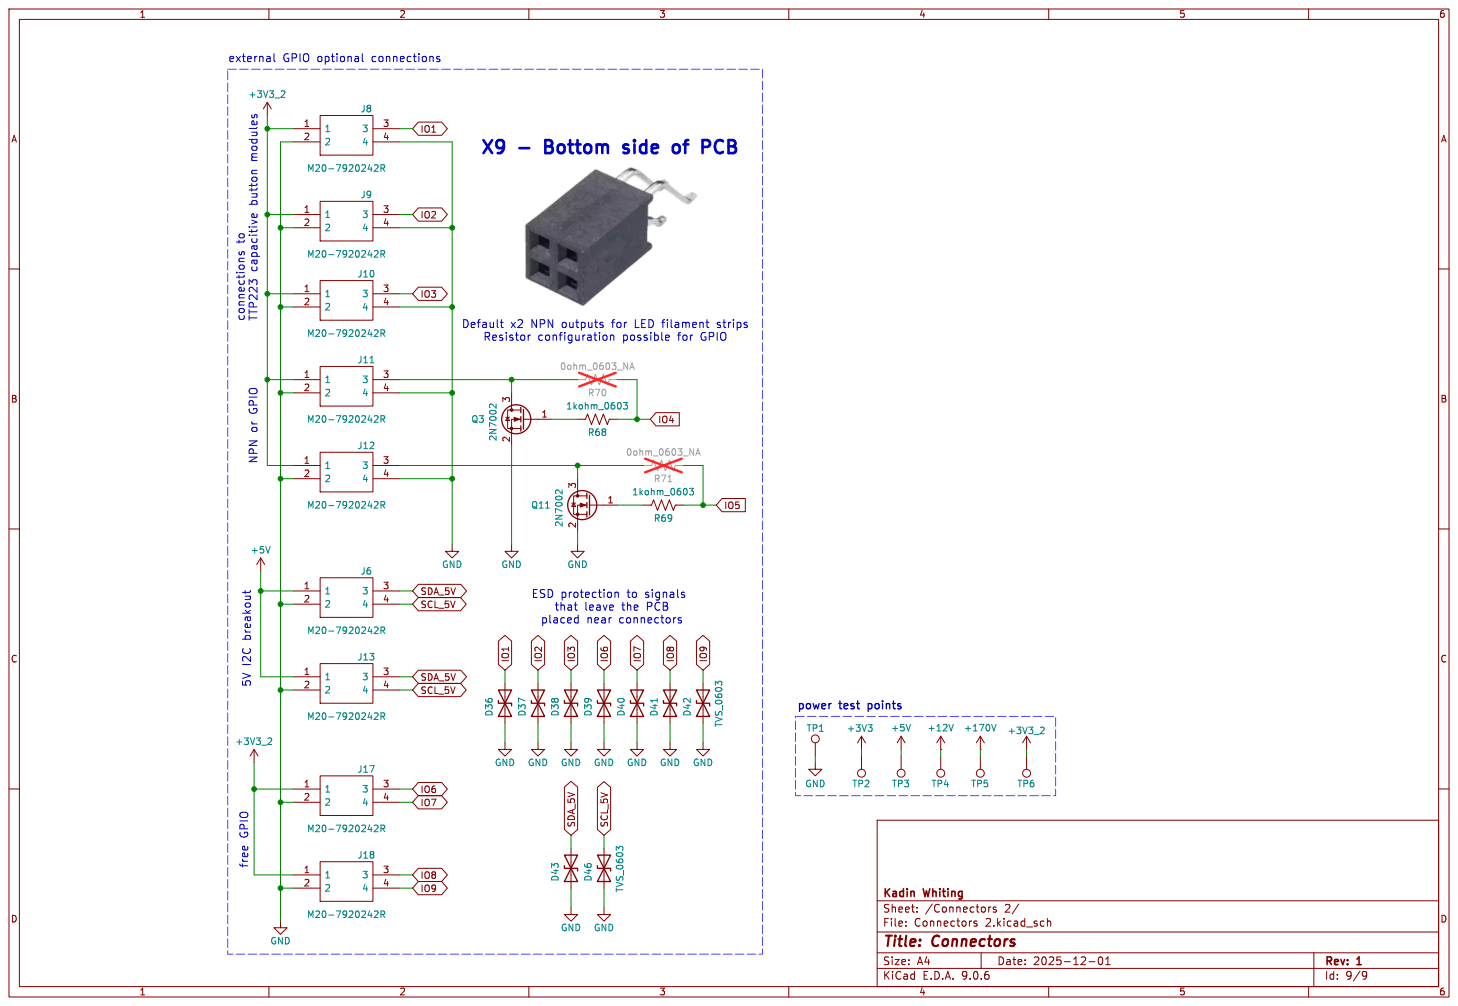
[picture p10: page 9]

X9 - Bottom side of PCB

that leave the PCB
