TickingClocks/64-Bit/Electrical/PCB Outputs/64 Bit - Display Board/Schematics/64 Bit - Display Board.pdf

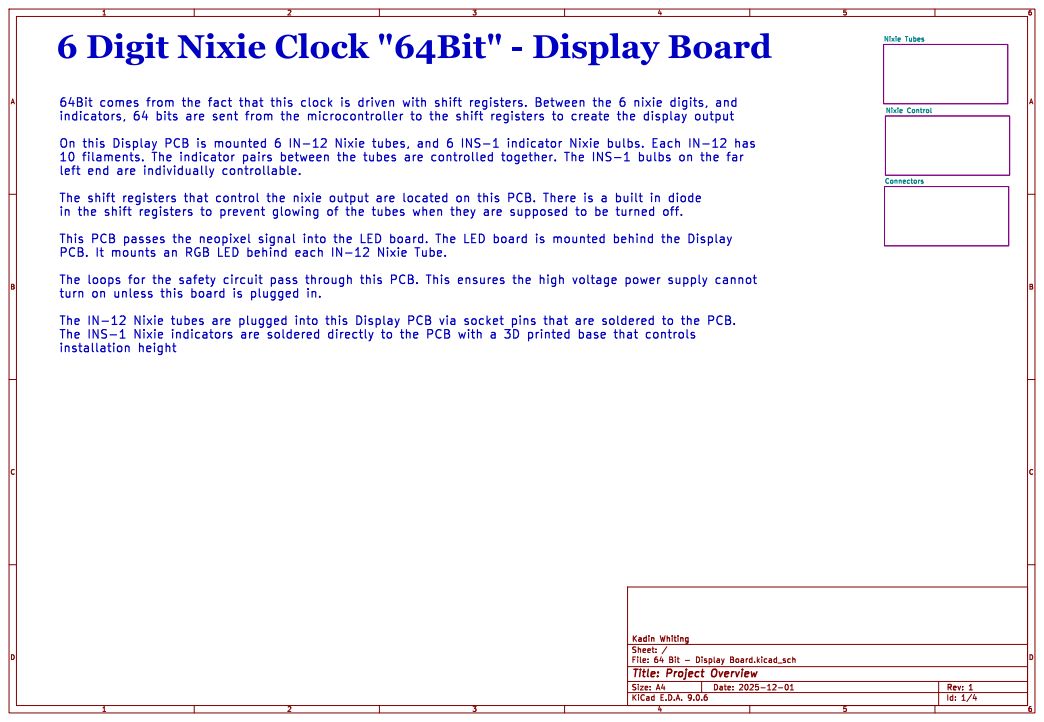
[picture p11: page 1]

6 Digit Nixie Clock "64Bit" - Display Board

turn on unless this board is plugged in.

Id: 1/4 Title: Project Overview

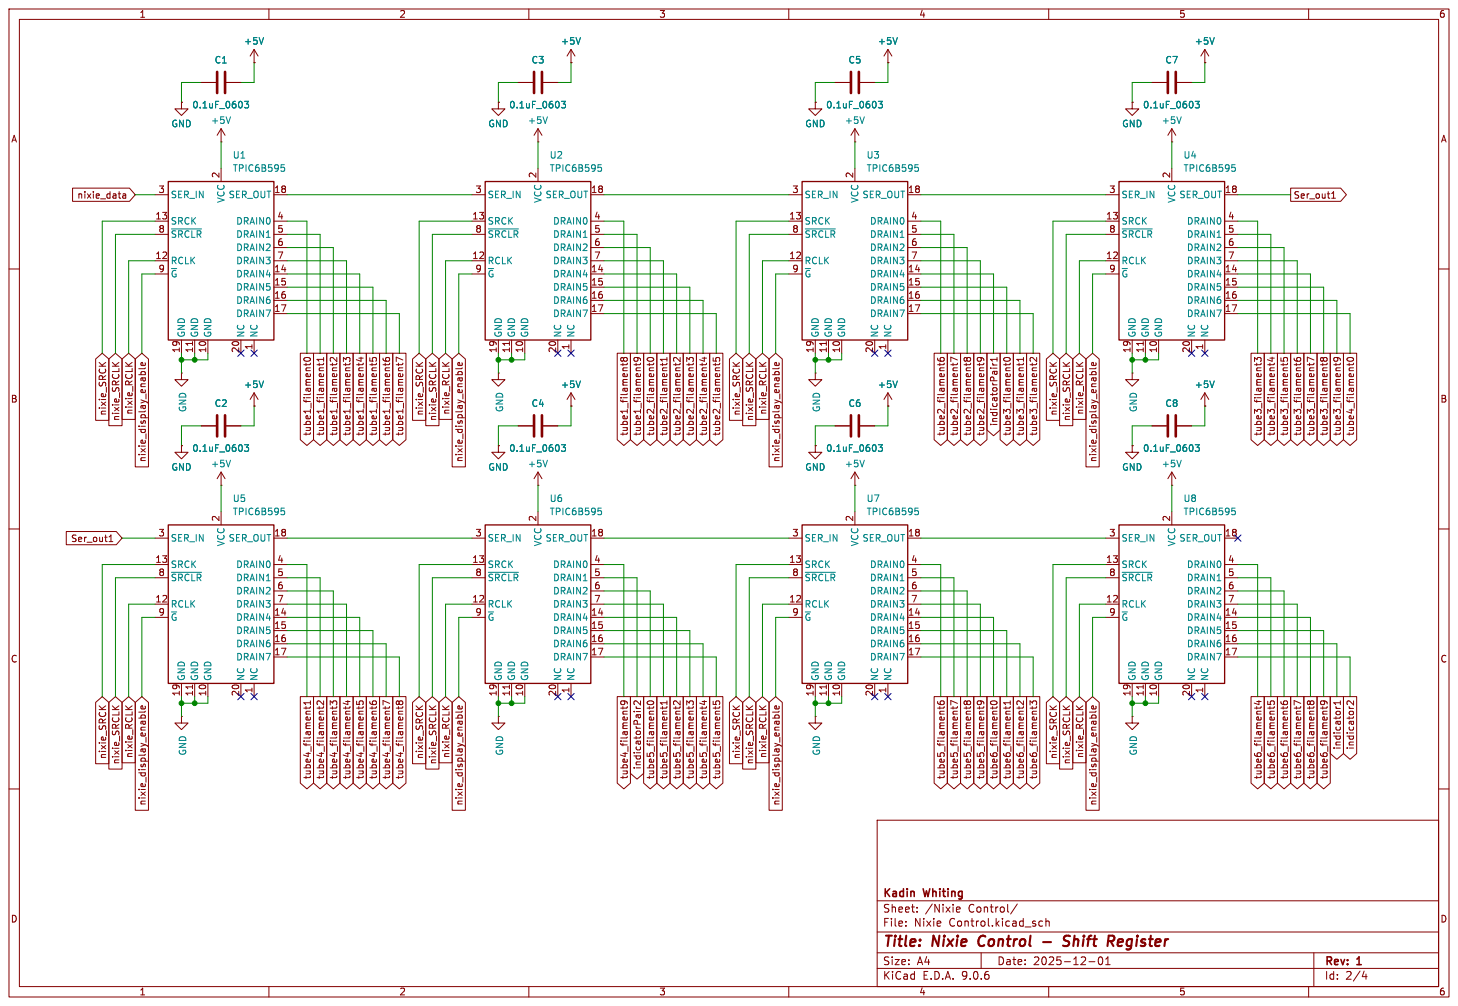
[picture p12: page 2]

1 SER_OUT 18 DRAIN0 4 DRAIN1 5 DRAIN2 6 DRAIN3 7 DRAIN4 14 DRAIN5 15 DRAIN6 16 DRAIN7 17 U1 TPIC6B595 SER_IN 3 SRCK 13 ~{SRCLR} 8 RCLK 12 ~{G} 9 GND 19 GND 11 GND 10 VCC

1 SER_OUT 18 DRAIN0 4 DRAIN1 5 DRAIN2 6 DRAIN3 7 DRAIN4 14 DRAIN5 15 DRAIN6 16 DRAIN7 17 U3 TPIC6B595 SER_IN 3 SRCK 13 ~{SRCLR} 8 RCLK 12 ~{G} 9 GND 19 GND 11 GND 10 VCC

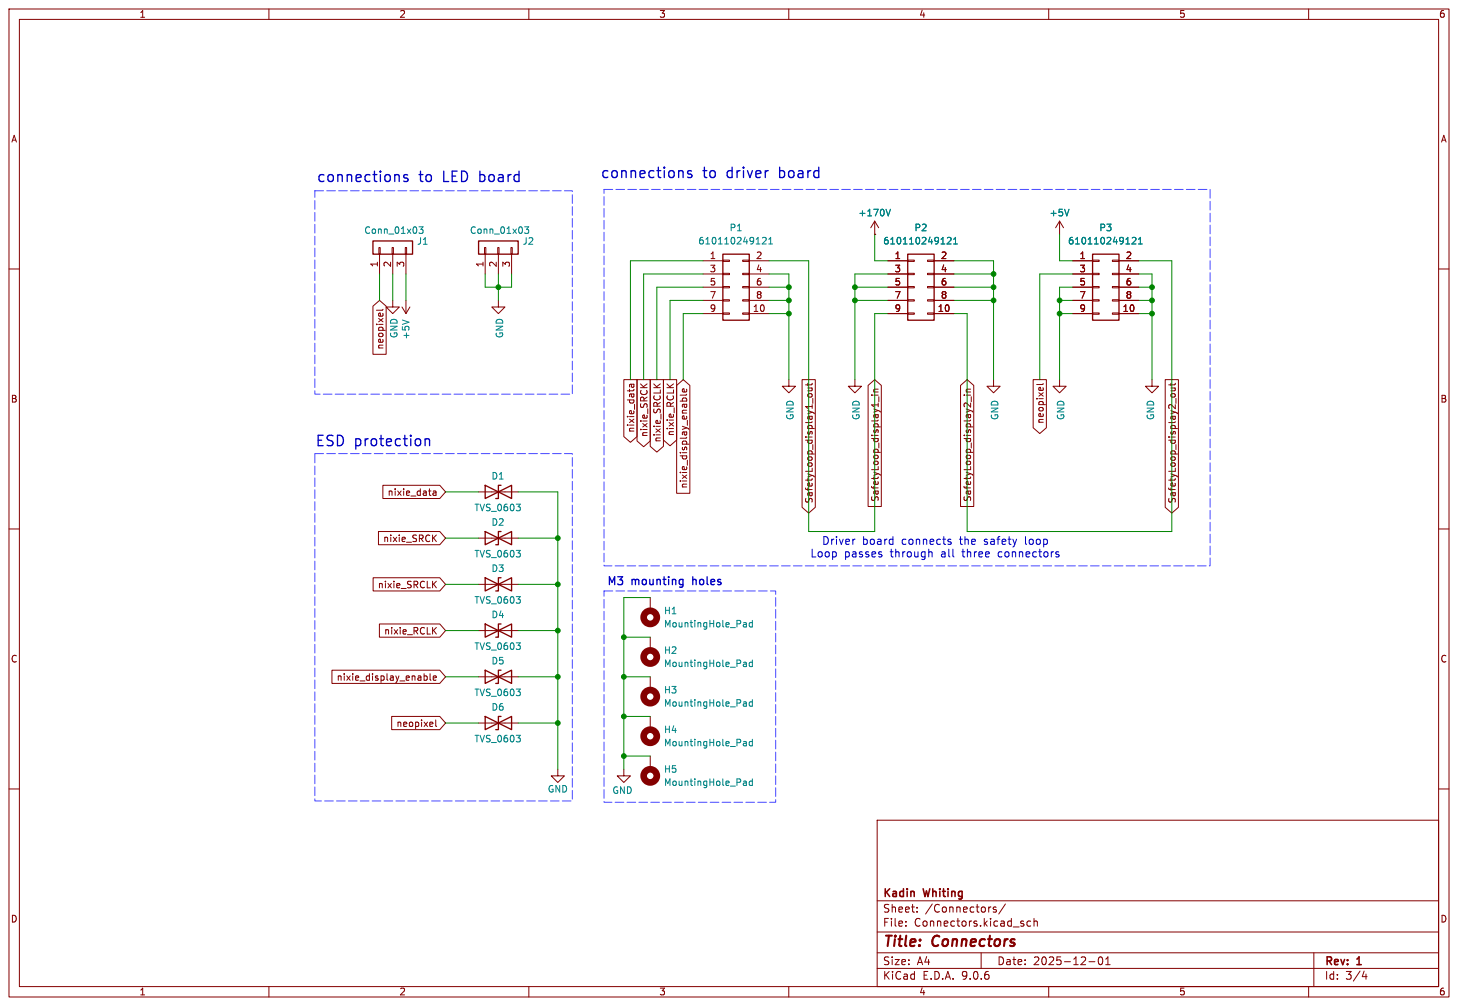
[picture p13: page 3]

Loop passes through all three connectors ESD protection

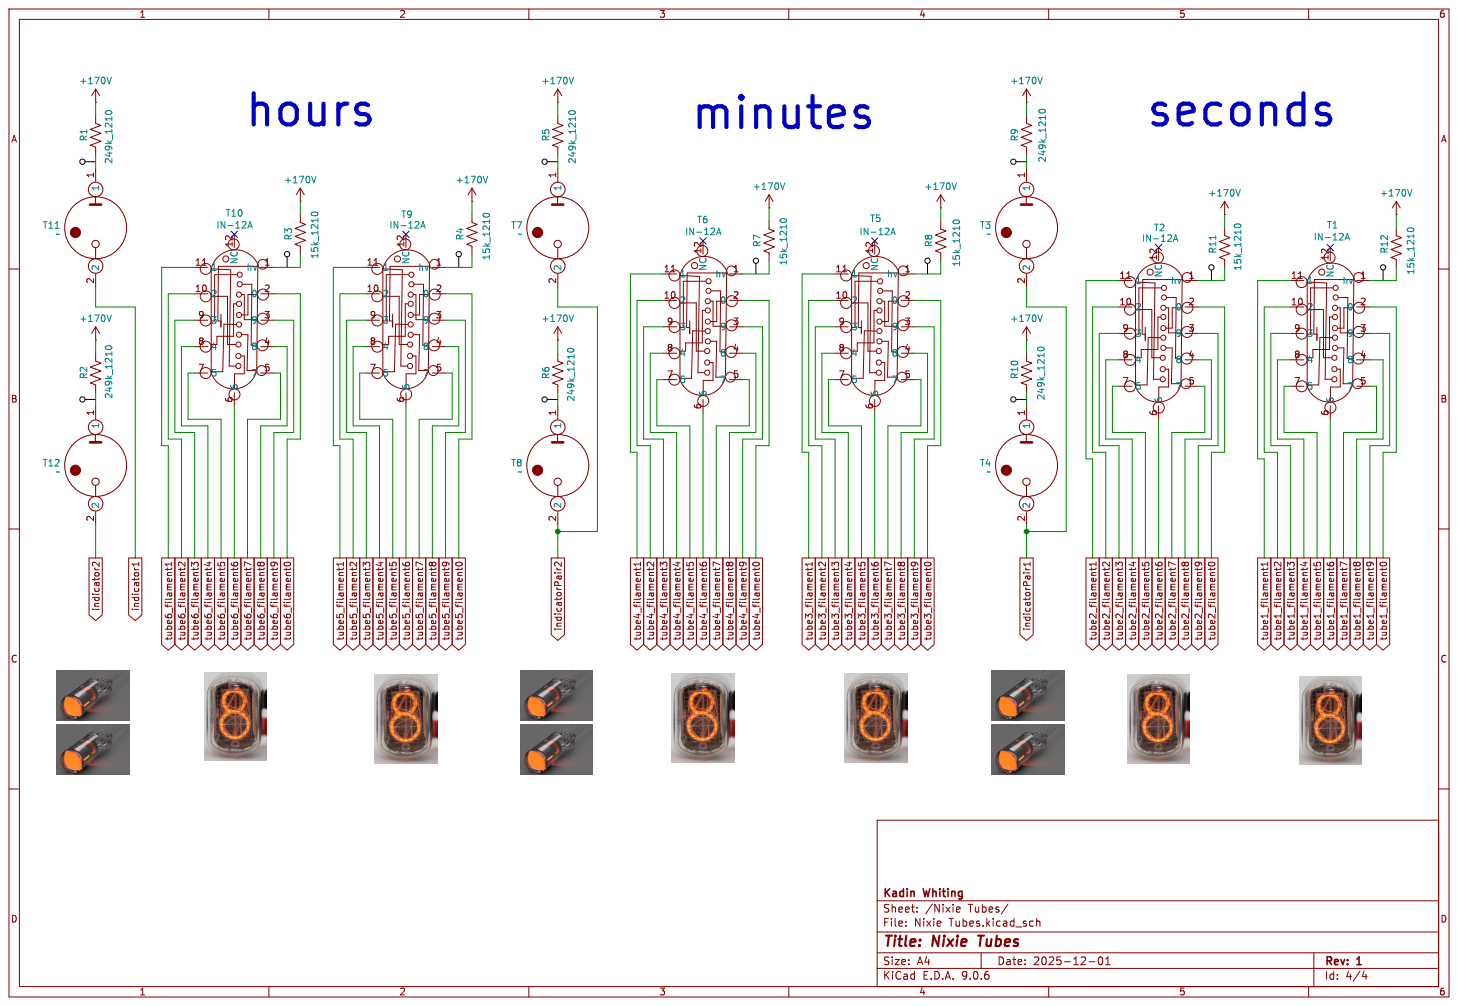
[picture p14: page 4]

Id: 4/4 Title: Nixie Tubes
