TickingClocks/64-Bit/Electrical/PCB Outputs/64 Bit - LED Board/Schematics/64 Bit - LED Board.pdf

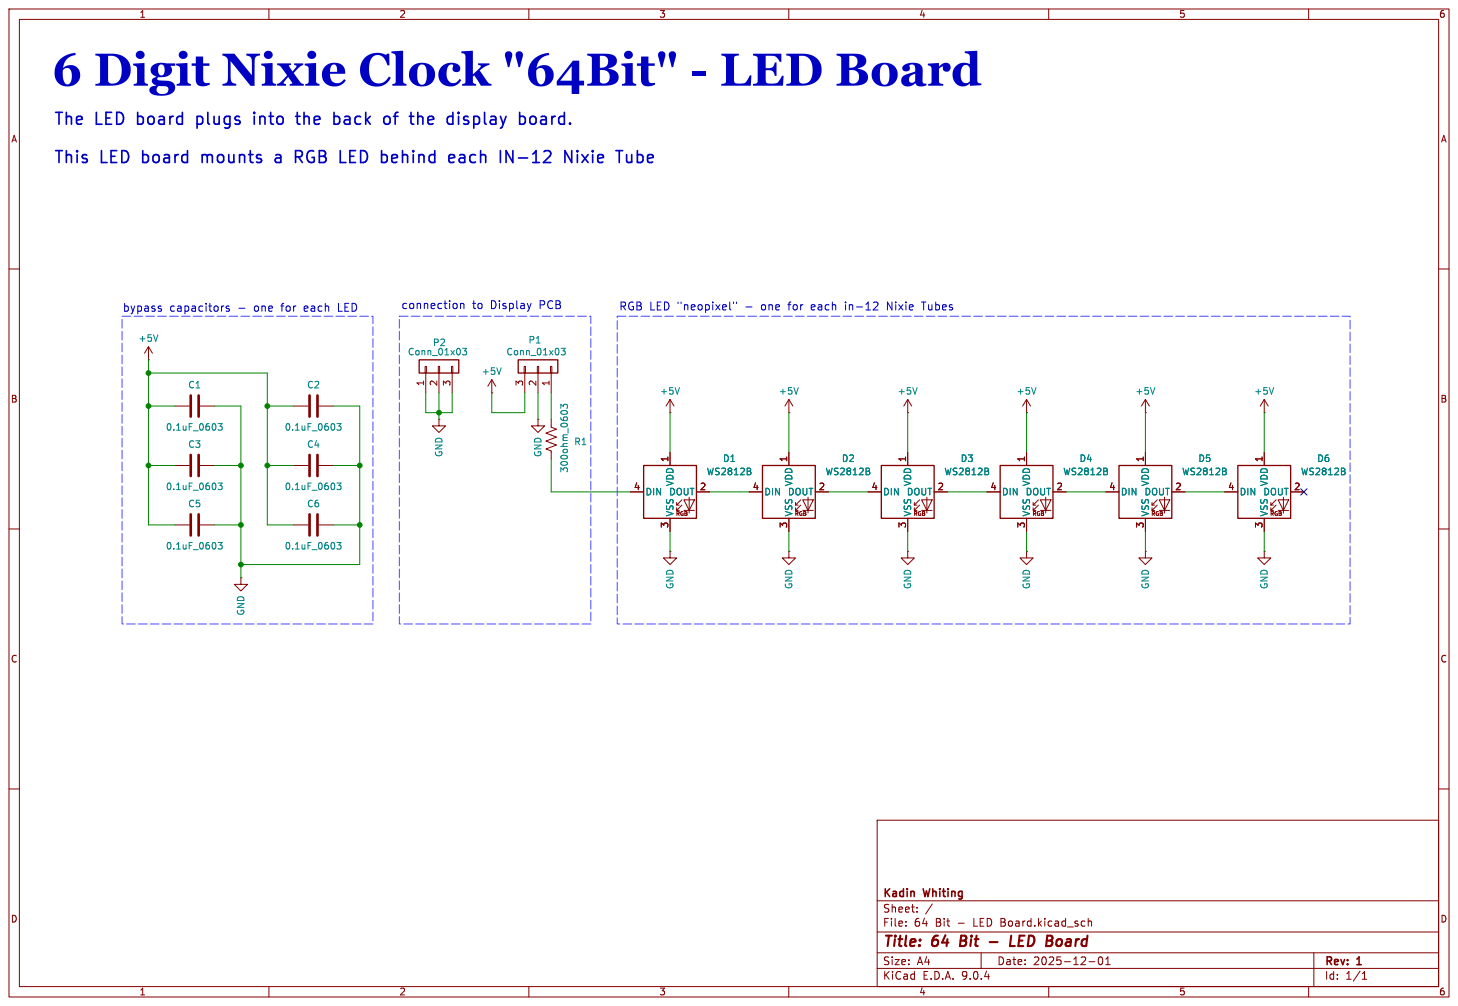
[picture p15: page 1]

3 DOUT 2 D2 WS2812B GND RGB DIN 4 VDD

Id: 1/1 Title: 64 Bit - LED Board
