TickingClocks/64-Bit/(list of files, drawings)

Other design files:
Electrical/PCB Projects/64 Bit - Display Board/freerouting.dsn
