TickingClocks/64-Bit/Electrical/PCB Projects/64 Bit - LED Board/64 Bit - LED Board.kicad_pcb

## KiCad design Electrical/PCB Projects/64 Bit - LED Board/64 Bit - LED Board.kicad_pcb (2025-12-22)

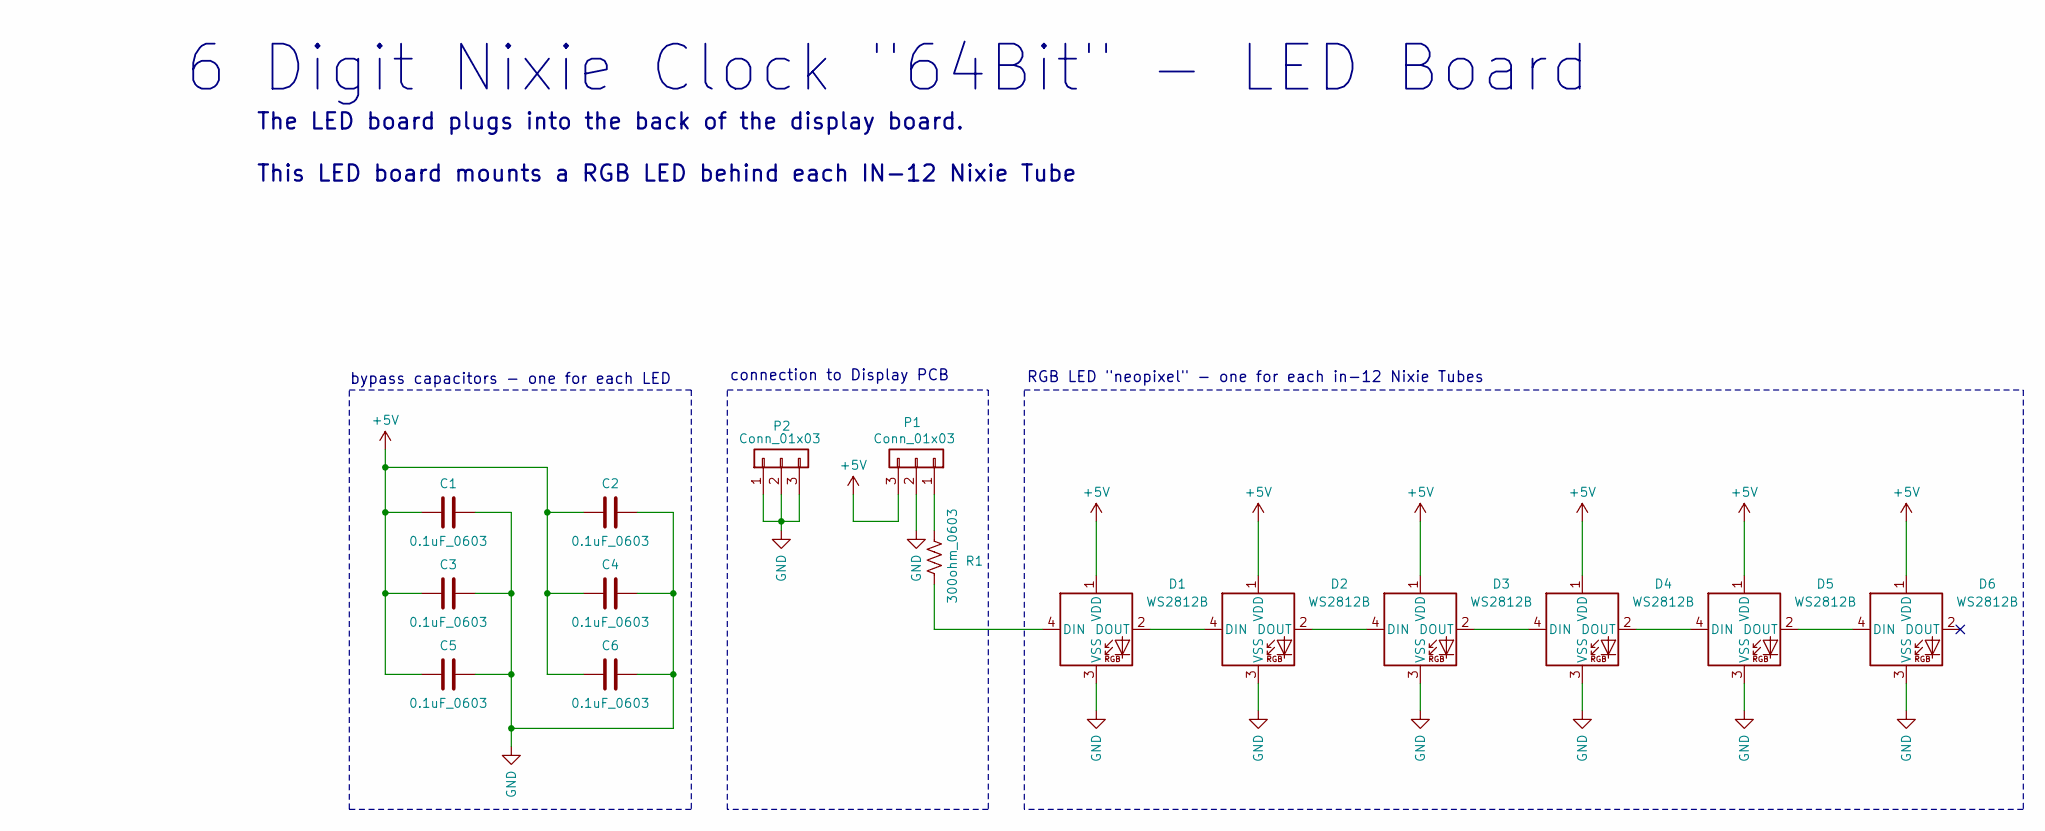
[picture p16: schematic 64 Bit - LED Board.kicad_sch]

Parts:
C1, C2, C3, C4, C5, C6: 0.1uF_0603; C_0603_1608Metric
D1, D2, D3, D4, D5, D6: WS2812B; LED_WS2812B_PLCC4_5.0x5.0mm_P3.2mm
P1, P2: Conn_01x03; PinHeader_1x03_P2.54mm_Vertical
R1: 300ohm_0603; R_0603_1608Metric

Connections:
+5V: C1.2, C2.2, C3.2, C4.2, C5.2, C6.2, D1.1 (VDD), D2.1 (VDD), D3.1 (VDD), D4.1 (VDD), D5.1 (VDD), D6.1 (VDD), P1.3
GND: C1.1, C2.1, C3.1, C4.1, C5.1, C6.1, D1.3 (VSS), D2.3 (VSS), D3.3 (VSS), D4.3 (VSS), D5.3 (VSS), D6.3 (VSS), P1.2, P2.1, P2.2, P2.3
unnamed: D1.4 (DIN), R1.2
unnamed: D1.2 (DOUT), D2.4 (DIN)
unnamed: D2.2 (DOUT), D3.4 (DIN)
unnamed: D3.2 (DOUT), D4.4 (DIN)
unnamed: D4.2 (DOUT), D5.4 (DIN)
unnamed: D5.2 (DOUT), D6.4 (DIN)
unnamed: P1.1, R1.1

Notes on the sheet:
connection to Display PCB
bypass capacitors - one for each LED
The LED board plugs into the back of the display board. This LED board mounts a RGB LED behind each IN-12 Nixie Tube
RGB LED "neopixel" - one for each in-12 Nixie Tubes
6 Digit Nixie Clock "64Bit" - LED Board

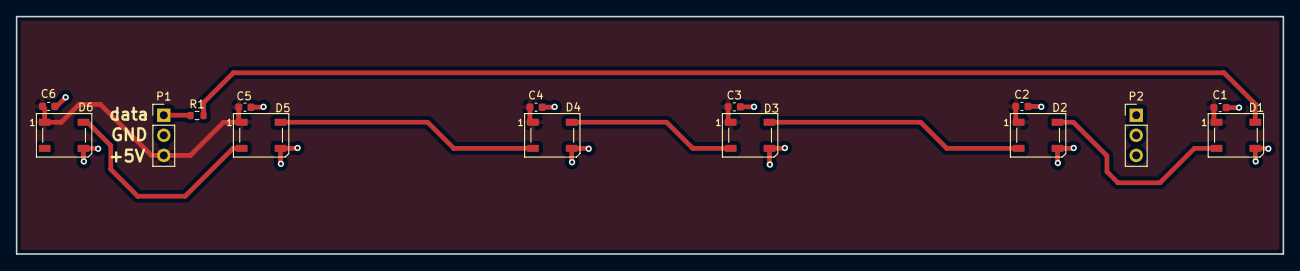
[picture p17: board 64 Bit - LED Board.kicad_pcb from above]

Board: 2 copper layers, 160.1 x 30.0 mm, 15 parts (0 on the bottom side), 9 nets.
