TickingClocks/64-Bit/Electrical/PCB Projects/64 Bit - Main Board/64 Bit - Main Board.kicad_pcb

## KiCad design Electrical/PCB Projects/64 Bit - Main Board/64 Bit - Main Board.kicad_pcb (2025-12-15)

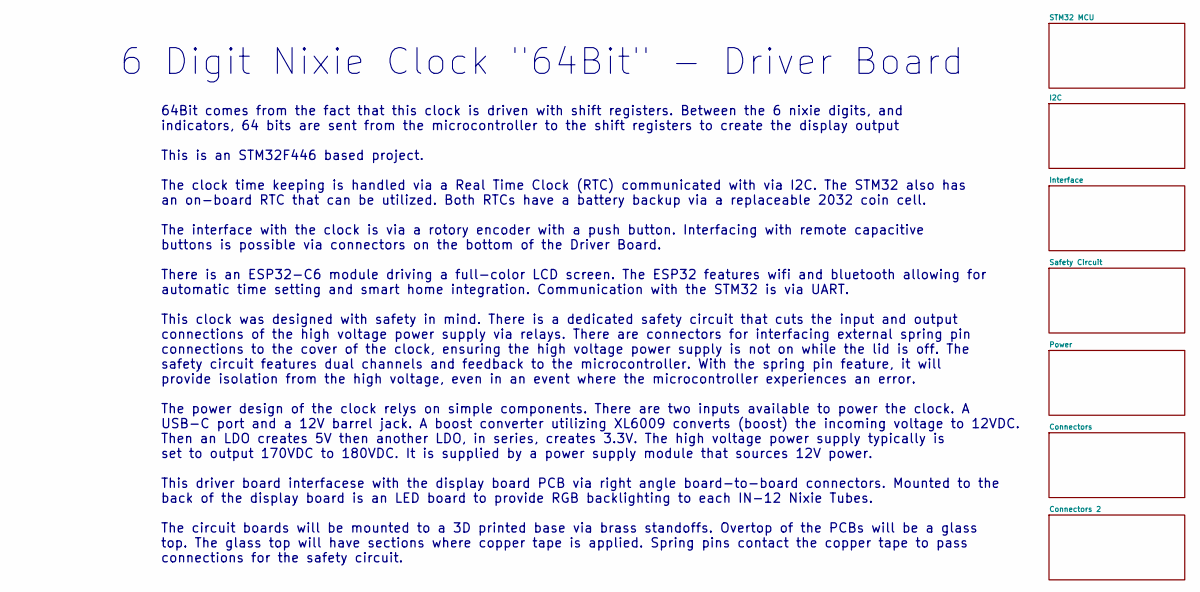
[picture p18: schematic 64 Bit - Main Board.kicad_sch, Project Overview]

Notes on the sheet:
64Bit comes from the fact that this clock is driven with shift registers. Between the 6 nixie digits, and indicators, 64 bits are sent from the microcontroller to the shift registers to create the display output This is an STM32F446 based project. The clock time keeping is handled via a Real Time C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
6 Digit Nixie Clock "64Bit" - Driver Board

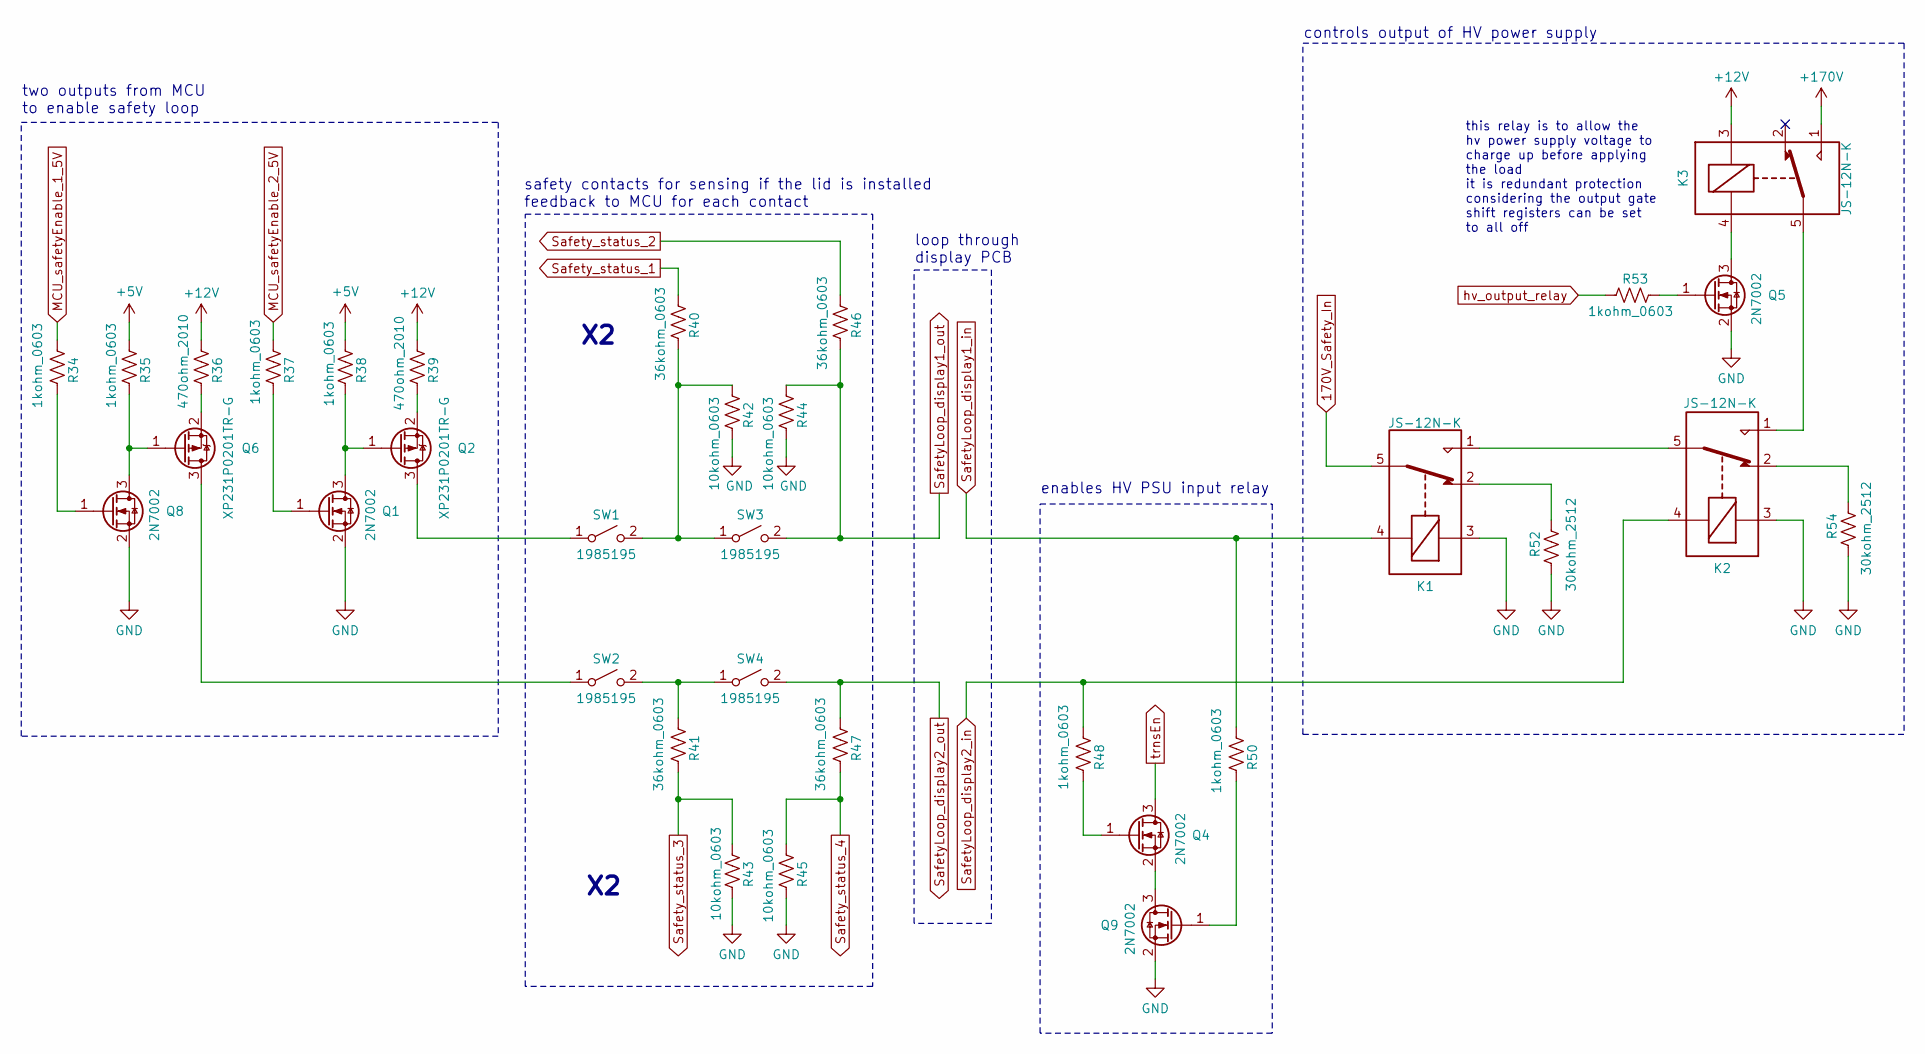
[picture p19: schematic Safety Circuit.kicad_sch, Safety Circuit - High Voltage PSU Control]

Parts:
K1, K2, K3: JS-12N-K
Q1, Q4, Q5, Q8, Q9: 2N7002; SOT-23
Q2, Q6: XP231P0201TR-G
R34, R35, R37, R38, R48, R50, R53: 1kohm_0603; R_0603_1608Metric
R36, R39: 470ohm_2010; R_2010_5025Metric
R40, R41, R46, R47: 36kohm_0603; R_0603_1608Metric
R42, R43, R44, R45: 10kohm_0603; R_0603_1608Metric
R52, R54: 30kohm_2512; R_2512_6332Metric
SW1, SW2, SW3, SW4: 1985195

Connections:
170V_Safety_In: K1.5; also elsewhere on the board
+5V: R35.2, R38.2; also elsewhere on the board
+12V: K3.3, R36.2, R39.2; also elsewhere on the board
+170V: K3.1; also elsewhere on the board
GND: K1.3, K2.3, Q1.2 (S), Q5.2 (S), Q8.2 (S), Q9.2 (S), R42.1, R43.1, R44.1, R45.1, R52.2, R54.2; also elsewhere on the board
MCU_safetyEnable_1_5V: R34.2; also elsewhere on the board
MCU_safetyEnable_2_5V: R37.2; also elsewhere on the board
unnamed: K1.1, K2.5
unnamed: K1.2, R52.1
unnamed: K2.1, K3.5
unnamed: K2.2, R54.1
unnamed: Q1.3 (D), Q2.1 (G), R38.1
unnamed: Q1.1 (G), R37.1
unnamed: Q2.3 (D), SW1.1 (A)
unnamed: Q2.2 (S), R39.1
unnamed: Q4.1 (G), R48.1
unnamed: Q4.2 (S), Q9.3 (D)
unnamed: K3.4, Q5.3 (D)
unnamed: Q5.1 (G), R53.1
unnamed: Q6.3 (D), SW2.1 (A)
unnamed: Q6.1 (G), Q8.3 (D), R35.1
unnamed: Q6.2 (S), R36.1
unnamed: Q8.1 (G), R34.1
unnamed: Q9.1 (G), R50.1
unnamed: R40.1, R42.2, SW1.2 (B), SW3.1 (A)
unnamed: R41.2, SW2.2 (B), SW4.1 (A)
SafetyLoop_display1_in: K1.4, R50.2; also elsewhere on the board
SafetyLoop_display1_out: R44.2, R46.1, SW3.2 (B); also elsewhere on the board
SafetyLoop_display2_in: K2.4, R48.2; also elsewhere on the board
SafetyLoop_display2_out: R47.2, SW4.2 (B); also elsewhere on the board
Safety_status_1: R40.2; also elsewhere on the board
Safety_status_2: R46.2; also elsewhere on the board
Safety_status_3: R41.1, R43.2; also elsewhere on the board
Safety_status_4: R45.2, R47.1; also elsewhere on the board
hv_output_relay: R53.2; also elsewhere on the board
trnsEn: Q4.3 (D); also elsewhere on the board

Notes on the sheet:
controls output of HV power supply
enables HV PSU input relay
loop through display PCB
this relay is to allow the hv power supply voltage to charge up before applying the load it is redundant protection considering the output gate shift registers can be set to all off
safety contacts for sensing if the lid is installed feedback to MCU for each contact
two outputs from MCU to enable safety loop

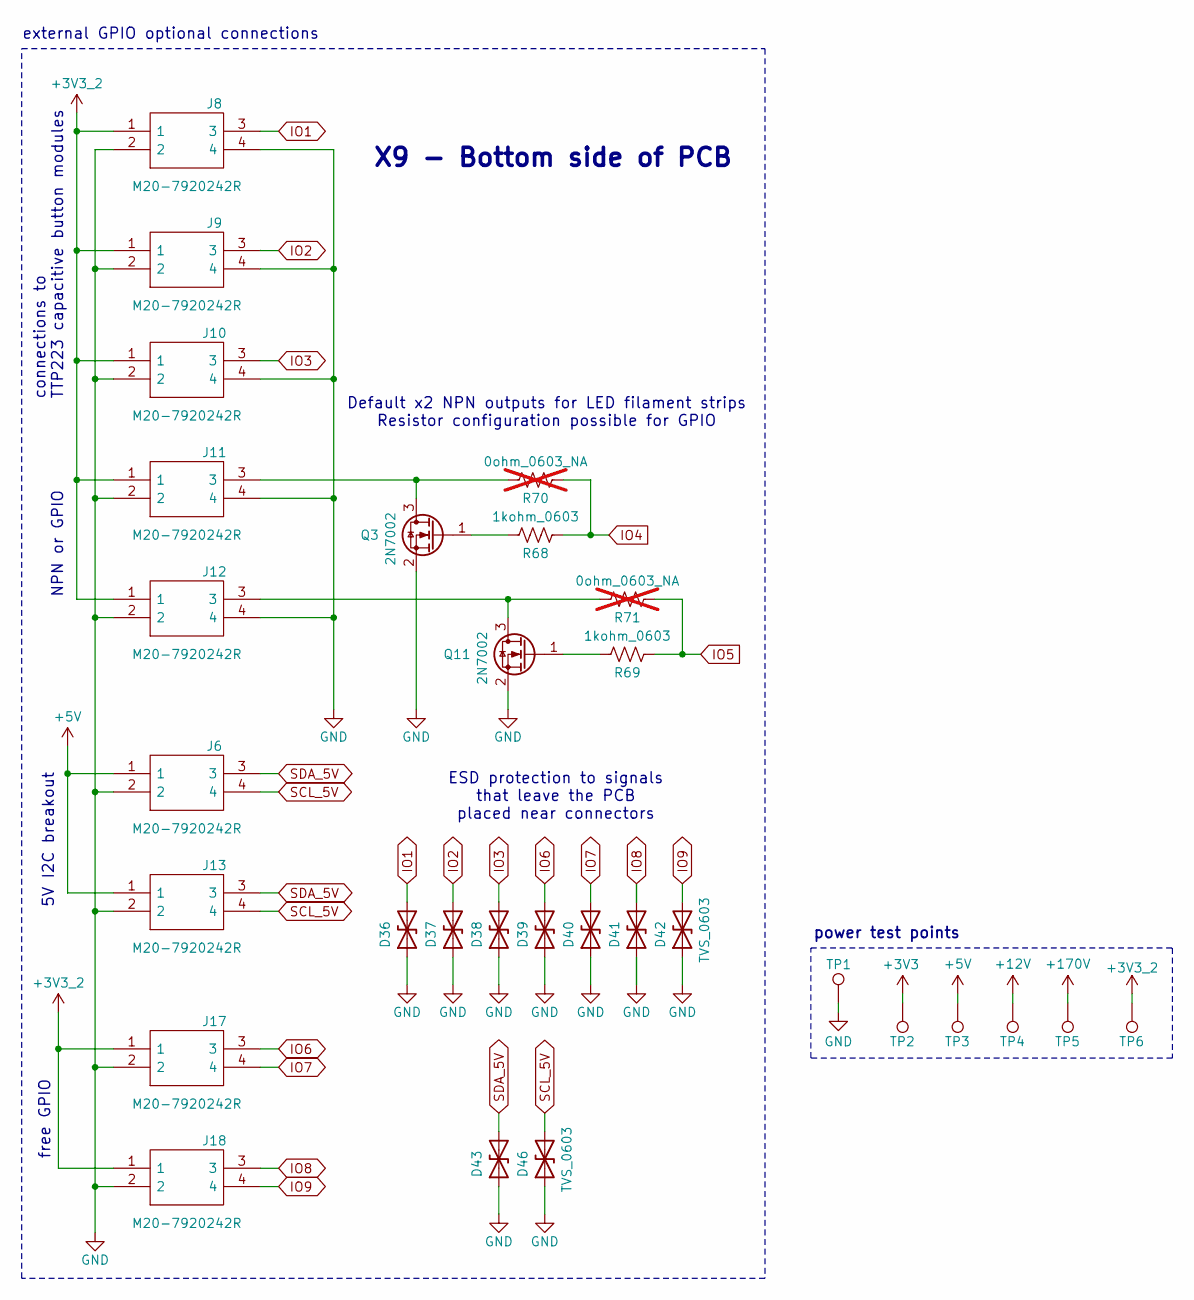
[picture p20: schematic Connectors 2.kicad_sch, Connectors]

Parts:
D36, D37, D38, D39, D40, D41, D42, D43, D46: TVS_0603; R_0603_1608Metric
J6, J8, J9, J10, J11, J12, J13, J17, J18: M20-7920242R; M207920242R; Mouser Part Number 855-M20-7920242R
Q3, Q11: 2N7002; SOT-23
R68, R69: 1kohm_0603; R_0603_1608Metric
R70, R71: 0ohm_0603_NA; R_0603_1608Metric; not fitted
TP1, TP2, TP3, TP4, TP5, TP6: TestPoint; TestPoint_THTPad_D1.5mm_Drill0.7mm

Connections:
+3V3: TP2.1; also elsewhere on the board
+3V3_2: J8.1, J9.1, J10.1, J11.1, J12.1, J17.1, J18.1, TP6.1; also elsewhere on the board
+5V: J6.1, J13.1, TP3.1; also elsewhere on the board
+12V: TP4.1; also elsewhere on the board
+170V: TP5.1; also elsewhere on the board
GND: D36.1 (A1), D37.1 (A1), D38.1 (A1), D39.1 (A1), D40.1 (A1), D41.1 (A1), D42.1 (A1), D43.1 (A1), D46.1 (A1), J6.2, J8.2, J8.4, J9.2, J9.4, J10.2, J10.4, J11.2, J11.4, J12.2, J12.4, J13.2, J17.2, J18.2, Q3.2 (S), Q11.2 (S), TP1.1; also elsewhere on the board
IO1: D36.2 (A2), J8.3; also elsewhere on the board
IO2: D37.2 (A2), J9.3; also elsewhere on the board
IO3: D38.2 (A2), J10.3; also elsewhere on the board
IO4: R68.1, R70.1; also elsewhere on the board
IO5: R69.1, R71.1; also elsewhere on the board
IO6: D39.2 (A2), J17.3; also elsewhere on the board
IO7: D40.2 (A2), J17.4; also elsewhere on the board
IO8: D41.2 (A2), J18.3; also elsewhere on the board
IO9: D42.2 (A2), J18.4; also elsewhere on the board
unnamed: J11.3, Q3.3 (D), R70.2
unnamed: Q3.1 (G), R68.2
unnamed: J12.3, Q11.3 (D), R71.2
unnamed: Q11.1 (G), R69.2
SCL_5V: D46.2 (A2), J6.4, J13.4; also elsewhere on the board
SDA_5V: D43.2 (A2), J6.3, J13.3; also elsewhere on the board

Notes on the sheet:
external GPIO optional connections
5V I2C breakout
ESD protection to signals that leave the PCB placed near connectors
NPN or GPIO
X9 - Bottom side of PCB
power test points
free GPIO
Default x2 NPN outputs for LED filament strips Resistor configuration possible for GPIO
connections to TTP223 capacitive button modules

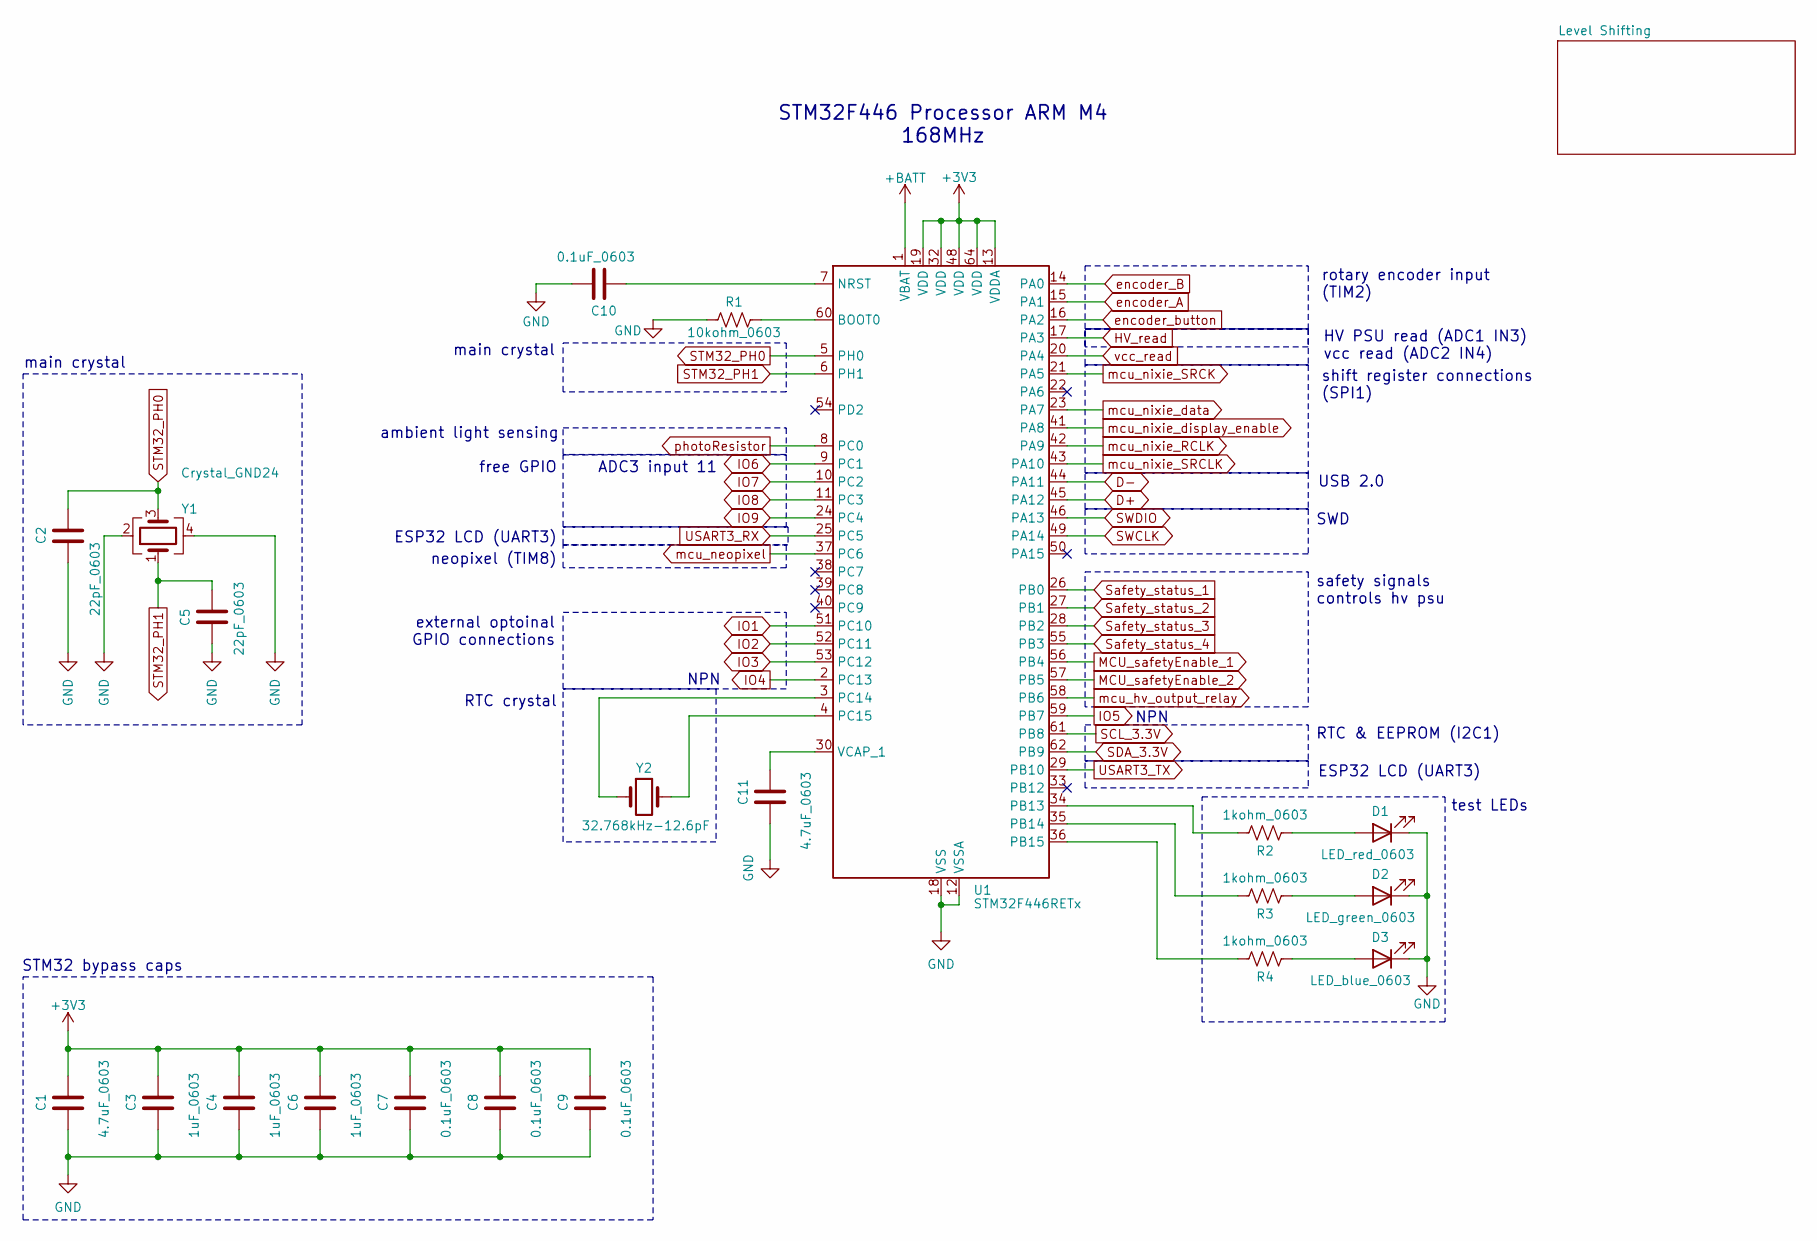
[picture p21: schematic STM32 MCU.kicad_sch, Microcontroller]

Parts:
C1, C11: 4.7uF_0603; C_0603_1608Metric
C2, C5: 22pF_0603; C_0603_1608Metric
C3, C4, C6: 1uF_0603; C_0603_1608Metric
C7, C8, C9, C10: 0.1uF_0603; C_0603_1608Metric
D1: LED_red_0603; LED_0603_1608Metric
D2: LED_green_0603; LED_0603_1608Metric
D3: LED_blue_0603; LED_0603_1608Metric
R1: 10kohm_0603; R_0603_1608Metric
R2, R3, R4: 1kohm_0603; R_0603_1608Metric
U1: STM32F446RETx; LQFP-64_10x10mm_P0.5mm
Y1: Crystal_GND24; ECS1602033TR3
Y2: 32.768kHz-12.6pF; 37.768kHz

Connections:
+3V3: C1.1, C3.1, C4.1, C6.1, C7.1, C8.1, C9.1, U1.13 (VDDA), U1.19 (VDD), U1.32 (VDD), U1.48 (VDD), U1.64 (VDD); also elsewhere on the board
+BATT: U1.1 (VBAT); also elsewhere on the board
D+: U1.45 (PA12); also elsewhere on the board
D-: U1.44 (PA11); also elsewhere on the board
GND: C1.2, C2.2, C3.2, C4.2, C5.1, C6.2, C7.2, C8.2, C9.2, C10.2, C11.2, D1.1 (K), D2.1 (K), D3.1 (K), R1.1, U1.12 (VSSA), U1.18 (VSS), U1.31 (VSS), U1.47 (VSS), U1.63 (VSS), Y1.2, Y1.4; also elsewhere on the board
HV_read: U1.17 (PA3); also elsewhere on the board
IO1: U1.51 (PC10); also elsewhere on the board
IO2: U1.52 (PC11); also elsewhere on the board
IO3: U1.53 (PC12); also elsewhere on the board
IO4: U1.2 (PC13); also elsewhere on the board
IO5: U1.59 (PB7); also elsewhere on the board
IO6: U1.9 (PC1); also elsewhere on the board
IO7: U1.10 (PC2); also elsewhere on the board
IO8: U1.11 (PC3); also elsewhere on the board
IO9: U1.24 (PC4); also elsewhere on the board
MCU_safetyEnable_1: U1.56 (PB4); also elsewhere on the board
MCU_safetyEnable_2: U1.57 (PB5); also elsewhere on the board
unnamed: D1.2 (A), R2.1
unnamed: D2.2 (A), R3.1
unnamed: D3.2 (A), R4.1
unnamed: R1.2, U1.60 (BOOT0)
unnamed: C10.1, U1.7 (NRST)
unnamed: R2.2, U1.34 (PB13)
unnamed: R3.2, U1.35 (PB14)
unnamed: R4.2, U1.36 (PB15)
unnamed: U1.3 (PC14), Y2.1
unnamed: U1.4 (PC15), Y2.2
unnamed: C11.1, U1.30 (VCAP_1)
SCL_3.3V: U1.61 (PB8); also elsewhere on the board
SDA_3.3V: U1.62 (PB9); also elsewhere on the board
STM32_PH0: C2.1, U1.5 (PH0), Y1.3
STM32_PH1: C5.2, U1.6 (PH1), Y1.1
SWCLK: U1.49 (PA14); also elsewhere on the board
SWDIO: U1.46 (PA13); also elsewhere on the board
Safety_status_1: U1.26 (PB0); also elsewhere on the board
Safety_status_2: U1.27 (PB1); also elsewhere on the board
Safety_status_3: U1.28 (PB2); also elsewhere on the board
Safety_status_4: U1.55 (PB3); also elsewhere on the board
USART3_RX: U1.25 (PC5); also elsewhere on the board
USART3_TX: U1.29 (PB10); also elsewhere on the board
encoder_A: U1.15 (PA1); also elsewhere on the board
encoder_B: U1.14 (PA0); also elsewhere on the board
encoder_button: U1.16 (PA2); also elsewhere on the board
mcu_hv_output_relay: U1.58 (PB6); also elsewhere on the board
mcu_neopixel: U1.37 (PC6); also elsewhere on the board
mcu_nixie_RCLK: U1.42 (PA9); also elsewhere on the board
mcu_nixie_SRCK: U1.21 (PA5); also elsewhere on the board
mcu_nixie_SRCLK: U1.43 (PA10); also elsewhere on the board
mcu_nixie_data: U1.23 (PA7); also elsewhere on the board
mcu_nixie_display_enable: U1.41 (PA8); also elsewhere on the board
photoResistor: U1.8 (PC0); also elsewhere on the board
vcc_read: U1.20 (PA4); also elsewhere on the board

Notes on the sheet:
HV PSU read (ADC1 IN3) vcc read (ADC2 IN4)
free GPIO
ESP32 LCD (UART3)
SWD
STM32 bypass caps
rotary encoder input (TIM2)
RTC & EEPROM (I2C1)
NPN
USB 2.0
external optoinal GPIO connections
test LEDs
ADC3 input 11
neopixel (TIM8)
safety signals controls hv psu
STM32F446 Processor ARM M4 168MHz
RTC crystal
shift register connections (SPI1)
ambient light sensing
main crystal

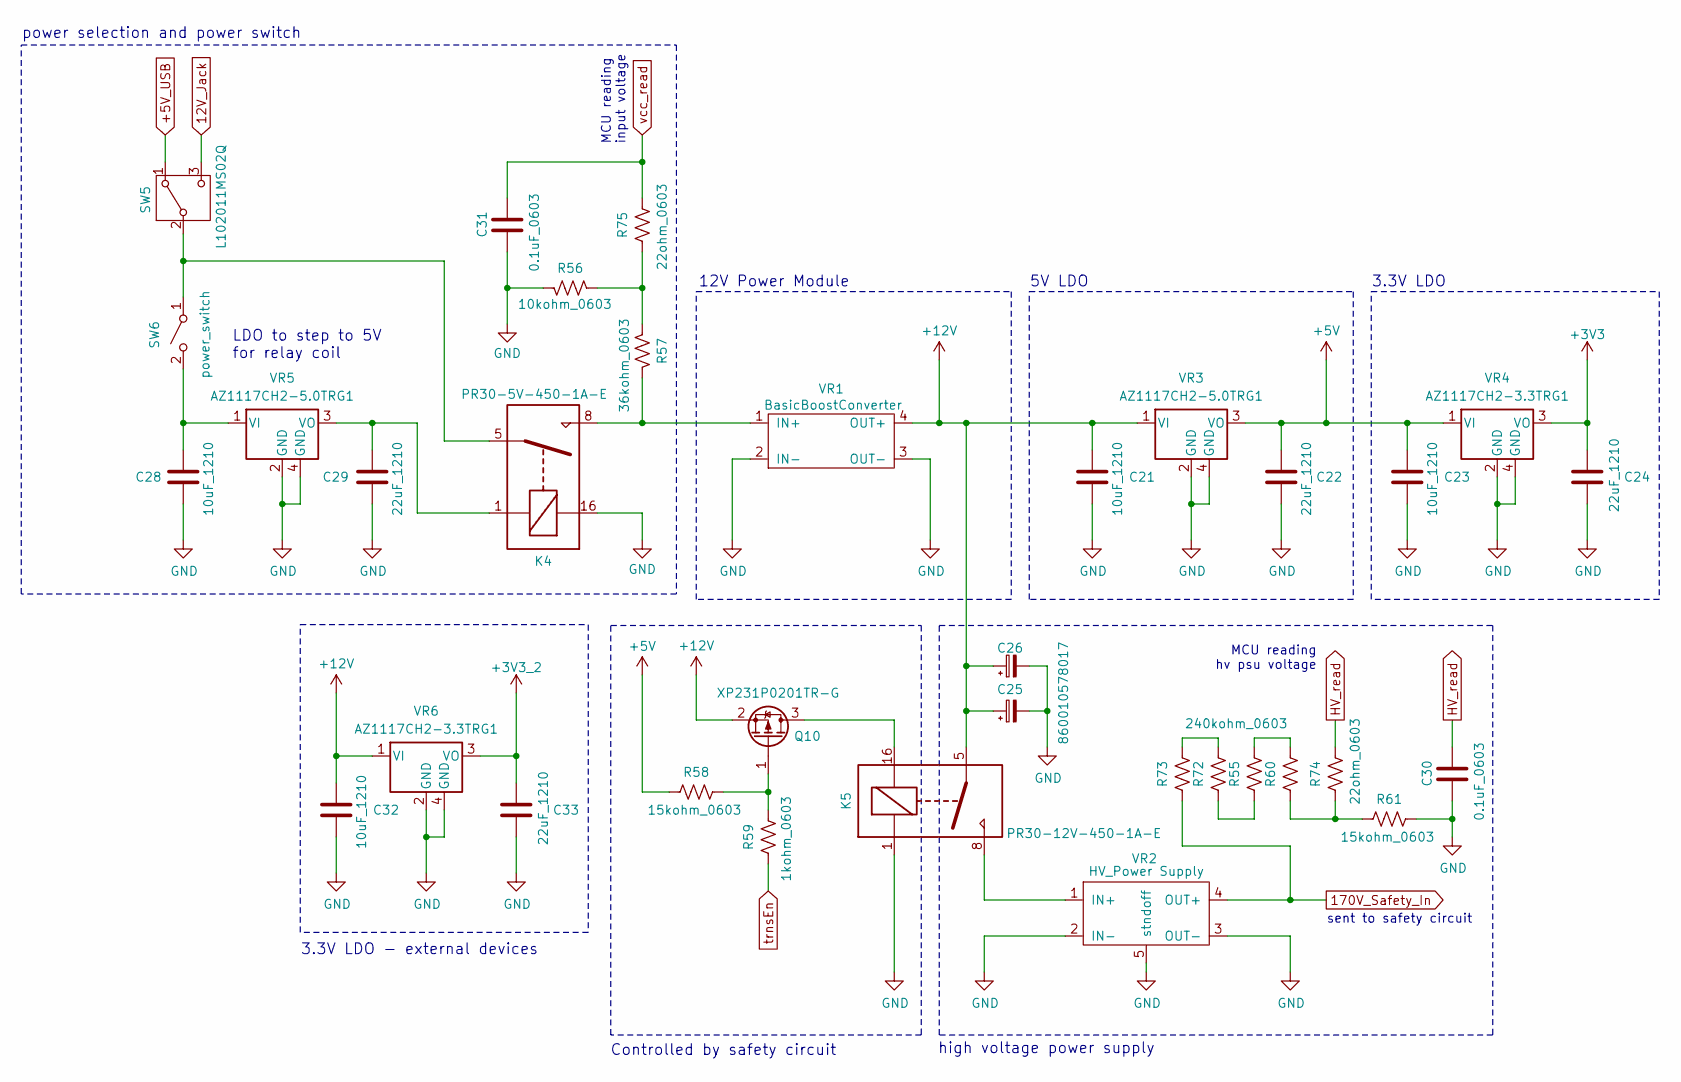
[picture p22: schematic Power.kicad_sch]

Parts:
C21, C23, C28, C32: 10uF_1210; C_1210_3225Metric
C22, C24, C29, C33: 22uF_1210; C_1210_3225Metric
C25, C26: 860010578017; CP_Radial_D13.0mm_P5.00mm
C30, C31: 0.1uF_0603; C_0603_1608Metric
K4: PR30-5V-450-1A-E; PR30-12V-450-1A-E
K5: PR30-12V-450-1A-E
Q10: XP231P0201TR-G
R55, R60, R72, R73: 240kohm_0603; R_0603_1608Metric
R56: 10kohm_0603; R_0603_1608Metric
R57: 36kohm_0603; R_0603_1608Metric
R58, R61: 15kohm_0603; R_0603_1608Metric
R59: 1kohm_0603; R_0603_1608Metric
R74, R75: 22ohm_0603; R_0603_1608Metric
SW5: L102011MS02Q
SW6: power_switch; 1985195
VR1: BasicBoostConverter; XL6009_Module(43mmx21mm)
VR2: HV_Power Supply; hv_psu
VR3, VR5: AZ1117CH2-5.0TRG1
VR4, VR6: AZ1117CH2-3.3TRG1

Connections:
12V_Jack: SW5.3 (C); also elsewhere on the board
170V_Safety_In: R73.1, VR2.4 (OUT+); also elsewhere on the board
+3V3: C24.1, VR4.3 (VO); also elsewhere on the board
+3V3_2: C33.1, VR6.3 (VO); also elsewhere on the board
+5V: C22.1, C23.1, R58.1, VR3.3 (VO), VR4.1 (VI); also elsewhere on the board
+5V_USB: SW5.1 (A); also elsewhere on the board
+12V: C21.1, C25.1, C26.1, C32.1, K5.5, Q10.2 (S), VR1.4 (OUT+), VR3.1 (VI), VR6.1 (VI); also elsewhere on the board
GND: C21.2, C22.2, C23.2, C24.2, C25.2, C26.2, C28.2, C29.2, C30.1, C31.1, C32.2, C33.2, K4.16, K5.1, R56.2, R61.2, VR1.2 (IN-), VR1.3 (OUT-), VR2.2 (IN-), VR2.3 (OUT-), VR2.5 (stndoff), VR3.2 (GND), VR3.4 (GND), VR4.2 (GND), VR4.4 (GND), VR5.2 (GND), VR5.4 (GND), VR6.2 (GND), VR6.4 (GND); also elsewhere on the board
HV_read: C30.2, R74.2; also elsewhere on the board
unnamed: K5.16, Q10.3 (D)
unnamed: Q10.1 (G), R58.2, R59.2
unnamed: R55.1, R72.1
unnamed: R55.2, R60.2
unnamed: R56.1, R57.2, R75.1
unnamed: R60.1, R61.1, R74.1
unnamed: R72.2, R73.2
unnamed: K4.5, SW5.2 (B), SW6.1 (A)
unnamed: C28.1, SW6.2 (B), VR5.1 (VI)
unnamed: K4.8, R57.1, VR1.1 (IN+)
unnamed: K5.8, VR2.1 (IN+)
unnamed: C29.1, K4.1, VR5.3 (VO)
trnsEn: R59.1; also elsewhere on the board
vcc_read: C31.2, R75.2; also elsewhere on the board

Notes on the sheet:
MCU reading input voltage
high voltage power supply
Controlled by safety circuit
5V LDO
sent to safety circuit
LDO to step to 5V for relay coil
3.3V LDO - external devices
12V Power Module
MCU reading hv psu voltage
power selection and power switch
3.3V LDO

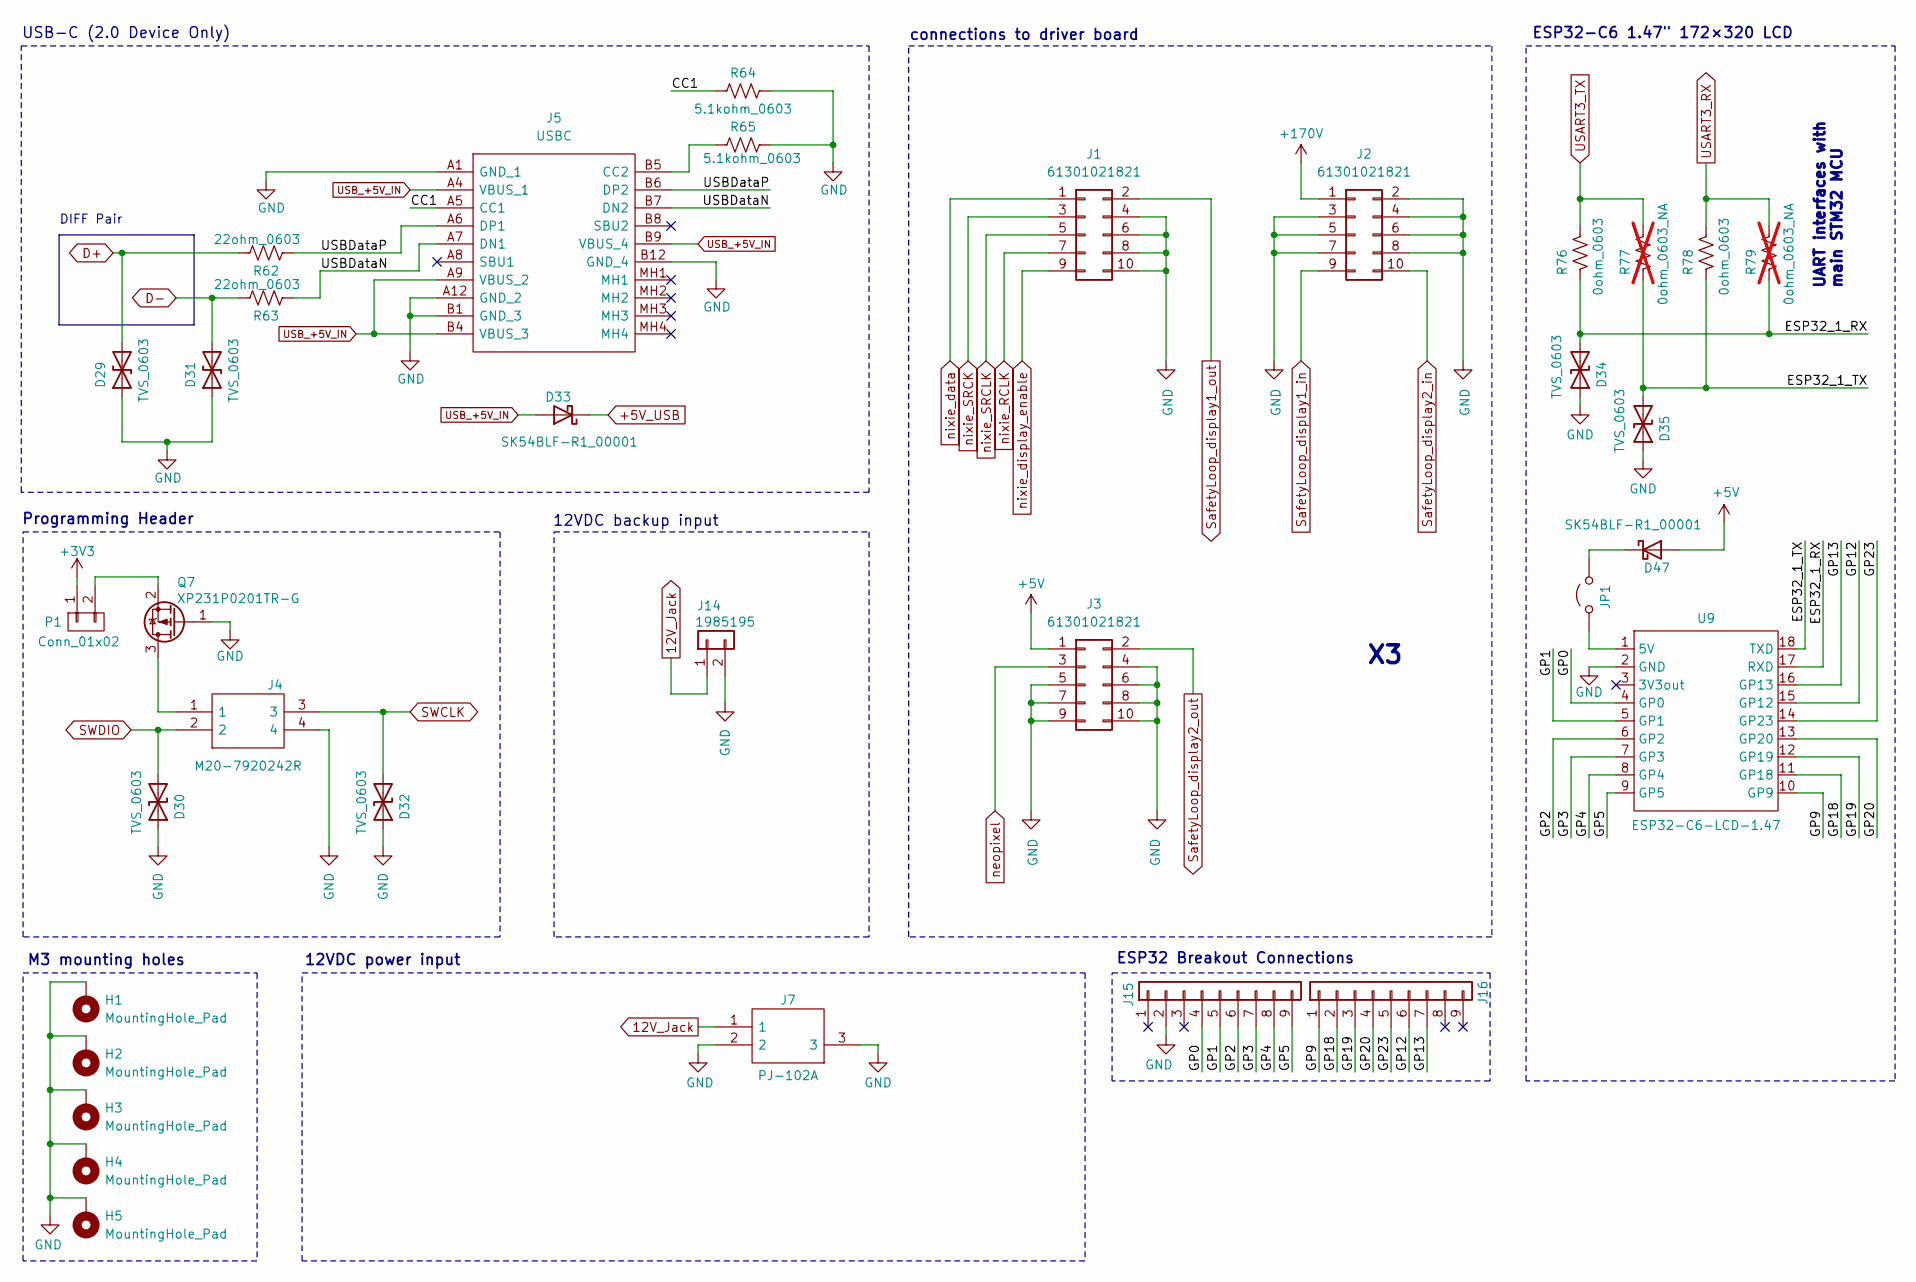
[picture p23: schematic Connectors.kicad_sch]

Parts:
D29, D30, D31, D32, D34, D35: TVS_0603; R_0603_1608Metric
D33, D47: SK54BLF-R1_00001
H1, H2, H3, H4, H5: MountingHole_Pad; M3 Standoff Footprint
J1, J2, J3: 61301021821
J4: M20-7920242R; M207920242R; Mouser Part Number 855-M20-7920242R
J5: USBC; USB421603A
J7: PJ-102A; PJ-102AH; Mouser Part Number 490-PJ-102A
J14: 1985195
J15, J16: Conn_01x09; PinSocket_1x09_P2.54mm_Vertical
JP1: Jumper_2_Open; PinHeader_1x02_P2.54mm_Vertical
P1: Conn_01x02; PinHeader_1x02_P2.54mm_Vertical
Q7: XP231P0201TR-G
R62, R63: 22ohm_0603; R_0603_1608Metric
R64, R65: 5.1kohm_0603; R_0603_1608Metric
R76, R78: 0ohm_0603; R_0603_1608Metric
R77, R79: 0ohm_0603_NA; R_0603_1608Metric; not fitted
U9: ESP32-C6-LCD-1.47

Connections:
12V_Jack: J7.1, J14.1; also elsewhere on the board
+3V3: P1.1; also elsewhere on the board
+5V: D47.2 (A), J3.1; also elsewhere on the board
+5V_USB: D33.1 (K); also elsewhere on the board
+170V: J2.1; also elsewhere on the board
/Connectors/CC1: J5.A5 (CC1), R64.2
/Connectors/ESP32_1_RX: D34.2 (A2), R76.1, R79.1, U9.17 (RXD)
/Connectors/ESP32_1_TX: D35.2 (A2), R77.1, R78.1, U9.18 (TXD)
/Connectors/GP0: J15.4, U9.4 (GP0)
/Connectors/GP1: J15.5, U9.5 (GP1)
/Connectors/GP2: J15.6, U9.6 (GP2)
/Connectors/GP3: J15.7, U9.7 (GP3)
/Connectors/GP4: J15.8, U9.8 (GP4)
/Connectors/GP5: J15.9, U9.9 (GP5)
/Connectors/GP9: J16.1, U9.10 (GP9)
/Connectors/GP12: J16.6, U9.15 (GP12)
/Connectors/GP13: J16.7, U9.16 (GP13)
/Connectors/GP18: J16.2, U9.11 (GP18)
/Connectors/GP19: J16.3, U9.12 (GP19)
/Connectors/GP20: J16.4, U9.13 (GP20)
/Connectors/GP23: J16.5, U9.14 (GP23)
/Connectors/USBDataN: J5.A7 (DN1), J5.B7 (DN2), R63.1
/Connectors/USBDataP: J5.A6 (DP1), J5.B6 (DP2), R62.1
D+: D29.2 (A2), R62.2; also elsewhere on the board
D-: D31.2 (A2), R63.2; also elsewhere on the board
GND: D29.1 (A1), D30.1 (A1), D31.1 (A1), D32.1 (A1), D34.1 (A1), D35.1 (A1), H1.1, H2.1, H3.1, H4.1, H5.1, J1.4, J1.6, J1.8, J1.10, J2.2, J2.3, J2.4, J2.5, J2.6, J2.7, J2.8, J3.4, J3.5, J3.6, J3.7, J3.8, J3.9, J3.10, J4.4, J5.A1 (GND_1), J5.A12 (GND_2), J5.B1 (GND_3), J5.B12 (GND_4), J7.2, J7.3, J14.2, J15.2, Q7.1 (G), R64.1, R65.2, U9.2 (GND); also elsewhere on the board
unnamed: D47.1 (K), JP1.2 (B)
unnamed: J5.B5 (CC2), R65.1
unnamed: JP1.1 (A), U9.1 (5V)
unnamed: P1.2, Q7.2 (S)
unnamed: J4.1, Q7.3 (D)
SWCLK: D32.2 (A2), J4.3; also elsewhere on the board
SWDIO: D30.2 (A2), J4.2; also elsewhere on the board
SafetyLoop_display1_in: J2.9; also elsewhere on the board
SafetyLoop_display1_out: J1.2; also elsewhere on the board
SafetyLoop_display2_in: J2.10; also elsewhere on the board
SafetyLoop_display2_out: J3.2; also elsewhere on the board
USART3_RX: R78.2, R79.2; also elsewhere on the board
USART3_TX: R76.2, R77.2; also elsewhere on the board
USB_+5V_IN: D33.2 (A), J5.A4 (VBUS_1), J5.A9 (VBUS_2), J5.B4 (VBUS_3), J5.B9 (VBUS_4)
neopixel: J3.3; also elsewhere on the board
nixie_RCLK: J1.7; also elsewhere on the board
nixie_SRCK: J1.3; also elsewhere on the board
nixie_SRCLK: J1.5; also elsewhere on the board
nixie_data: J1.1; also elsewhere on the board
nixie_display_enable: J1.9; also elsewhere on the board

Notes on the sheet:
Programming Header
ESP32-C6 1.47" 172×320 LCD
M3 mounting holes
DIFF Pair
connections to driver board
ESP32 Breakout Connections
UART interfaces with main STM32 MCU
12VDC power input
12VDC backup input
USB-C (2.0 Device Only)
