TickingClocks/64-Bit/Electrical/PCB Projects/64 Bit - Main Board/64 Bit - Main Board.kicad_pcb

## KiCad design Electrical/PCB Projects/64 Bit - Main Board/64 Bit - Main Board.kicad_pcb (continued)

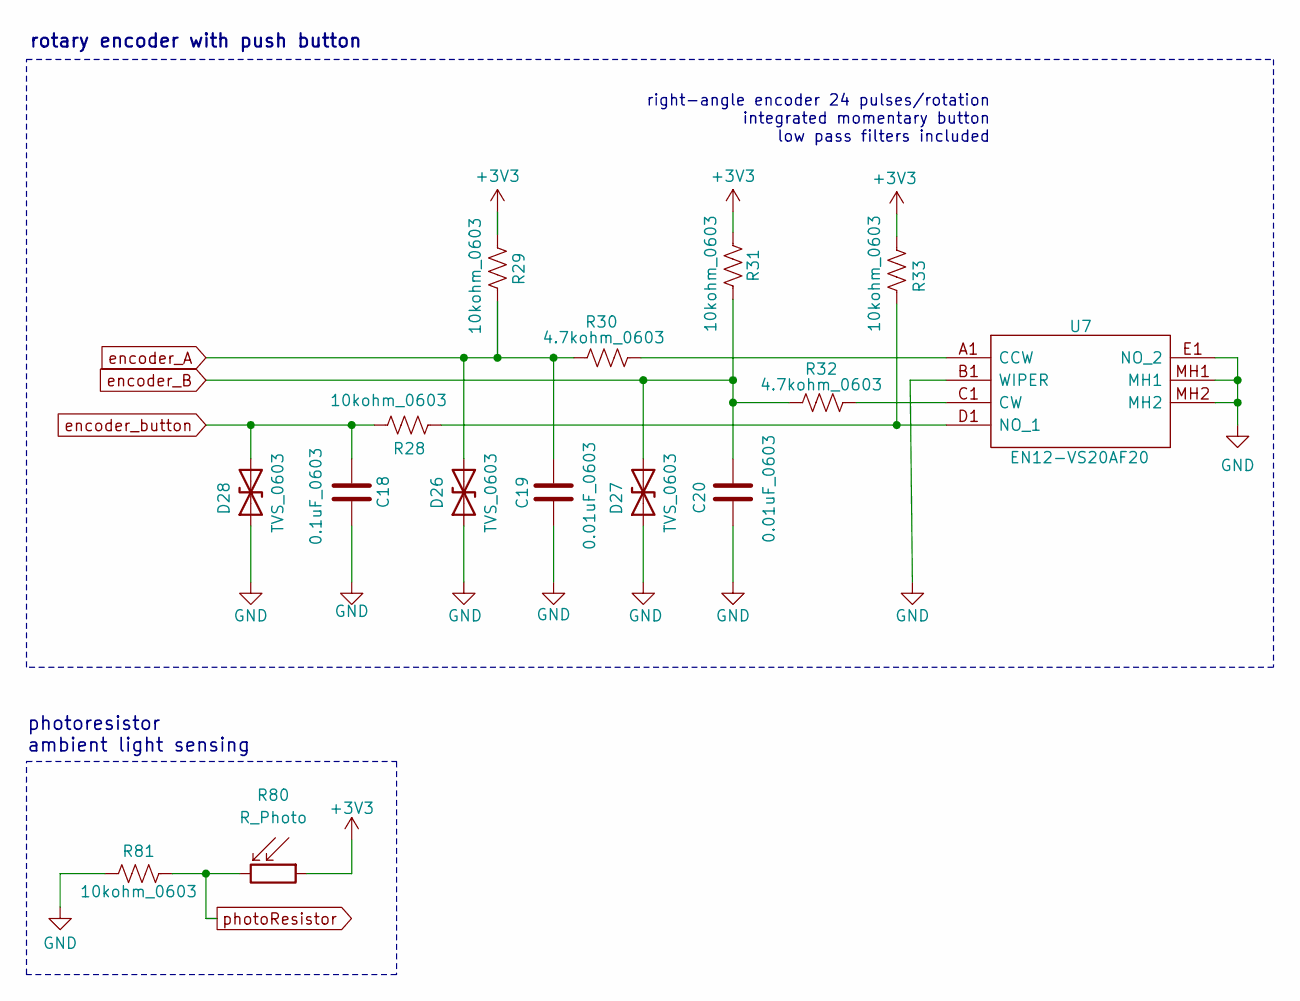
[picture p24: schematic Interface.kicad_sch, Interface - Rotary Encoder]

Parts:
C18: 0.1uF_0603; C_0603_1608Metric
C19, C20: 0.01uF_0603; C_0603_1608Metric
D26, D27, D28: TVS_0603; R_0603_1608Metric
R28, R29, R31, R33, R81: 10kohm_0603; R_0603_1608Metric
R30, R32: 4.7kohm_0603; R_0603_1608Metric
R80: R_Photo; R_LDR_5.1x4.3mm_P3.4mm_Vertical
U7: EN12-VS20AF20; Mouser Part Number 858-EN12VS20AF20

Connections:
+3V3: R29.1, R31.1, R33.2, R80.1; also elsewhere on the board
GND: C18.2, C19.1, C20.2, D26.1 (A1), D27.1 (A1), D28.1 (A1), R81.1, U7.B1 (WIPER), U7.E1 (NO_2), U7.MH1, U7.MH2; also elsewhere on the board
unnamed: R30.2, U7.A1 (CCW)
unnamed: R32.2, U7.C1 (CW)
unnamed: R28.1, R33.1, U7.D1 (NO_1)
encoder_A: C19.2, D26.2 (A2), R29.2, R30.1; also elsewhere on the board
encoder_B: C20.1, D27.2 (A2), R31.2, R32.1; also elsewhere on the board
encoder_button: C18.1, D28.2 (A2), R28.2; also elsewhere on the board
photoResistor: R80.2, R81.2; also elsewhere on the board

Notes on the sheet:
right-angle encoder 24 pulses/rotation integrated momentary button low pass filters included
photoresistor ambient light sensing
rotary encoder with push button

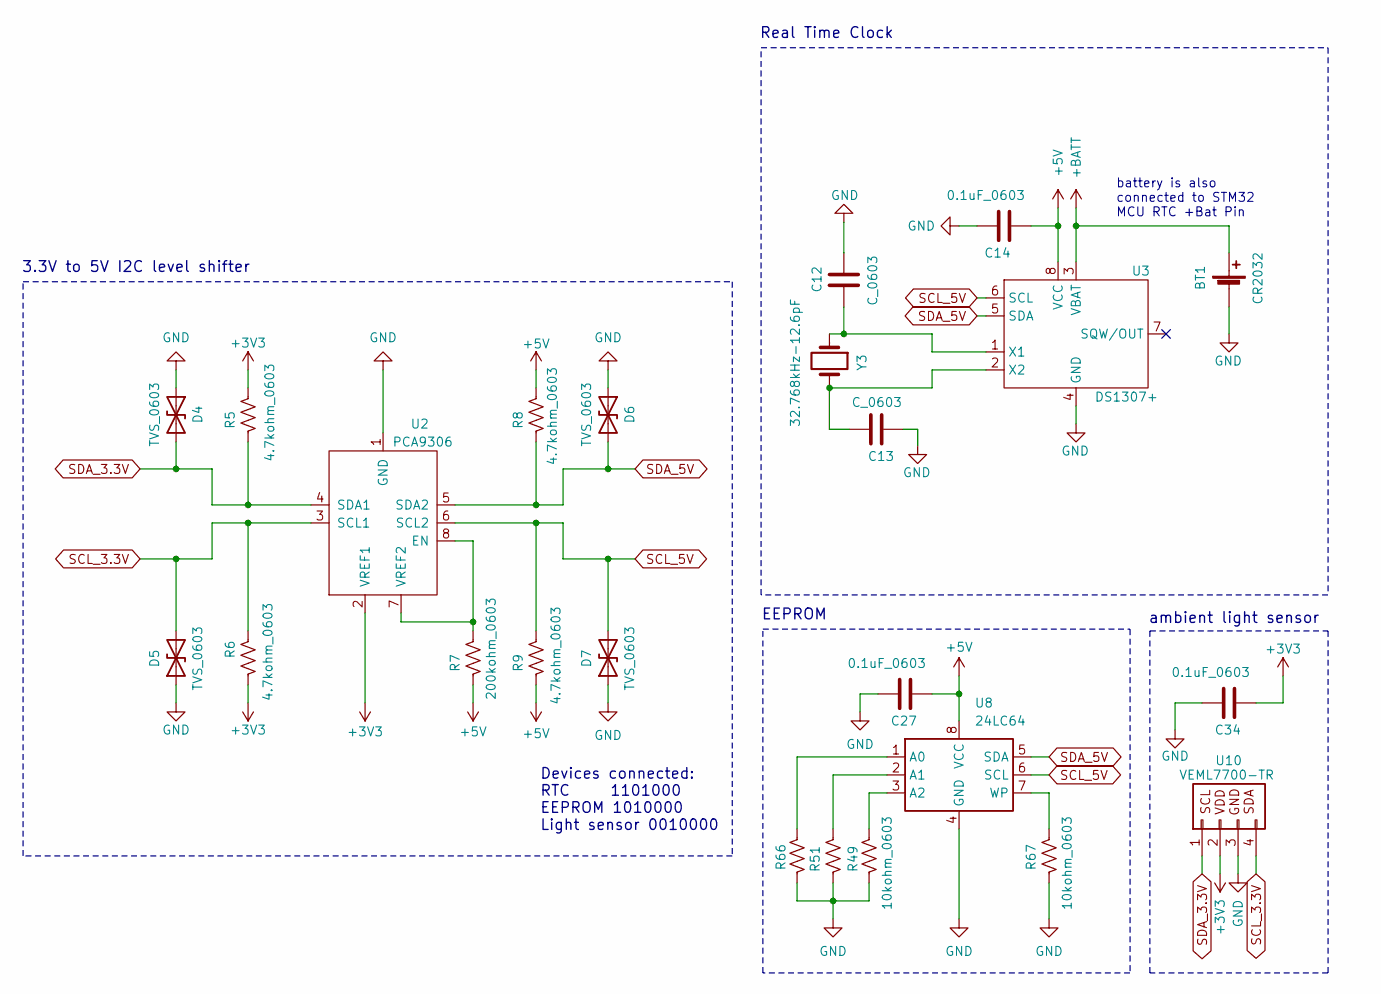
[picture p25: schematic I2C.kicad_sch, RTC & RTC Level Shifting]

Parts:
BT1: CR2032; CR2030_HLDR
C12, C13: C_0603; C_0603_1608Metric
C14, C27, C34: 0.1uF_0603; C_0603_1608Metric
D4, D5, D6, D7: TVS_0603; R_0603_1608Metric
R5, R6, R8, R9: 4.7kohm_0603; R_0603_1608Metric
R7: 200kohm_0603; R_0603_1608Metric
R49, R51, R66, R67: 10kohm_0603; R_0603_1608Metric
U2: PCA9306
U3: DS1307+; DS1307
U8: 24LC64; 24LC64F-ISN
U10: VEML7700-TR; VEML7700
Y3: 32.768kHz-12.6pF; 37.768kHz

Connections:
+3V3: C34.2, R5.2, R6.1, U2.2 (VREF1), U10.2 (VDD); also elsewhere on the board
+5V: C14.2, C27.2, R7.1, R8.2, R9.1, U3.8 (VCC), U8.8 (VCC); also elsewhere on the board
+BATT: BT1.1 (+), U3.3 (VBAT); also elsewhere on the board
GND: BT1.2 (-), C12.2, C13.1, C14.1, C27.1, C34.1, D4.1 (A1), D5.1 (A1), D6.1 (A1), D7.1 (A1), R49.1, R51.1, R66.1, R67.1, U2.1 (GND), U3.4 (GND), U8.4 (GND), U10.3 (GND); also elsewhere on the board
unnamed: R7.2, U2.7 (VREF2), U2.8 (EN)
unnamed: C12.1, U3.1 (X1), Y3.1
unnamed: C13.2, U3.2 (X2), Y3.2
unnamed: R66.2, U8.1 (A0)
unnamed: R51.2, U8.2 (A1)
unnamed: R49.2, U8.3 (A2)
unnamed: R67.2, U8.7 (WP)
SCL_3.3V: D5.2 (A2), R6.2, U2.3 (SCL1), U10.4 (SDA); also elsewhere on the board
SCL_5V: D7.2 (A2), R9.2, U2.6 (SCL2), U3.6 (SCL), U8.6 (SCL); also elsewhere on the board
SDA_3.3V: D4.2 (A2), R5.1, U2.4 (SDA1), U10.1 (SCL); also elsewhere on the board
SDA_5V: D6.2 (A2), R8.1, U2.5 (SDA2), U3.5 (SDA), U8.5 (SDA); also elsewhere on the board

Notes on the sheet:
battery is also connected to STM32 MCU RTC +Bat Pin
Devices connected: RTC 1101000 EEPROM 1010000 Light sensor 0010000
Real Time Clock
ambient light sensor
EEPROM
3.3V to 5V I2C level shifter

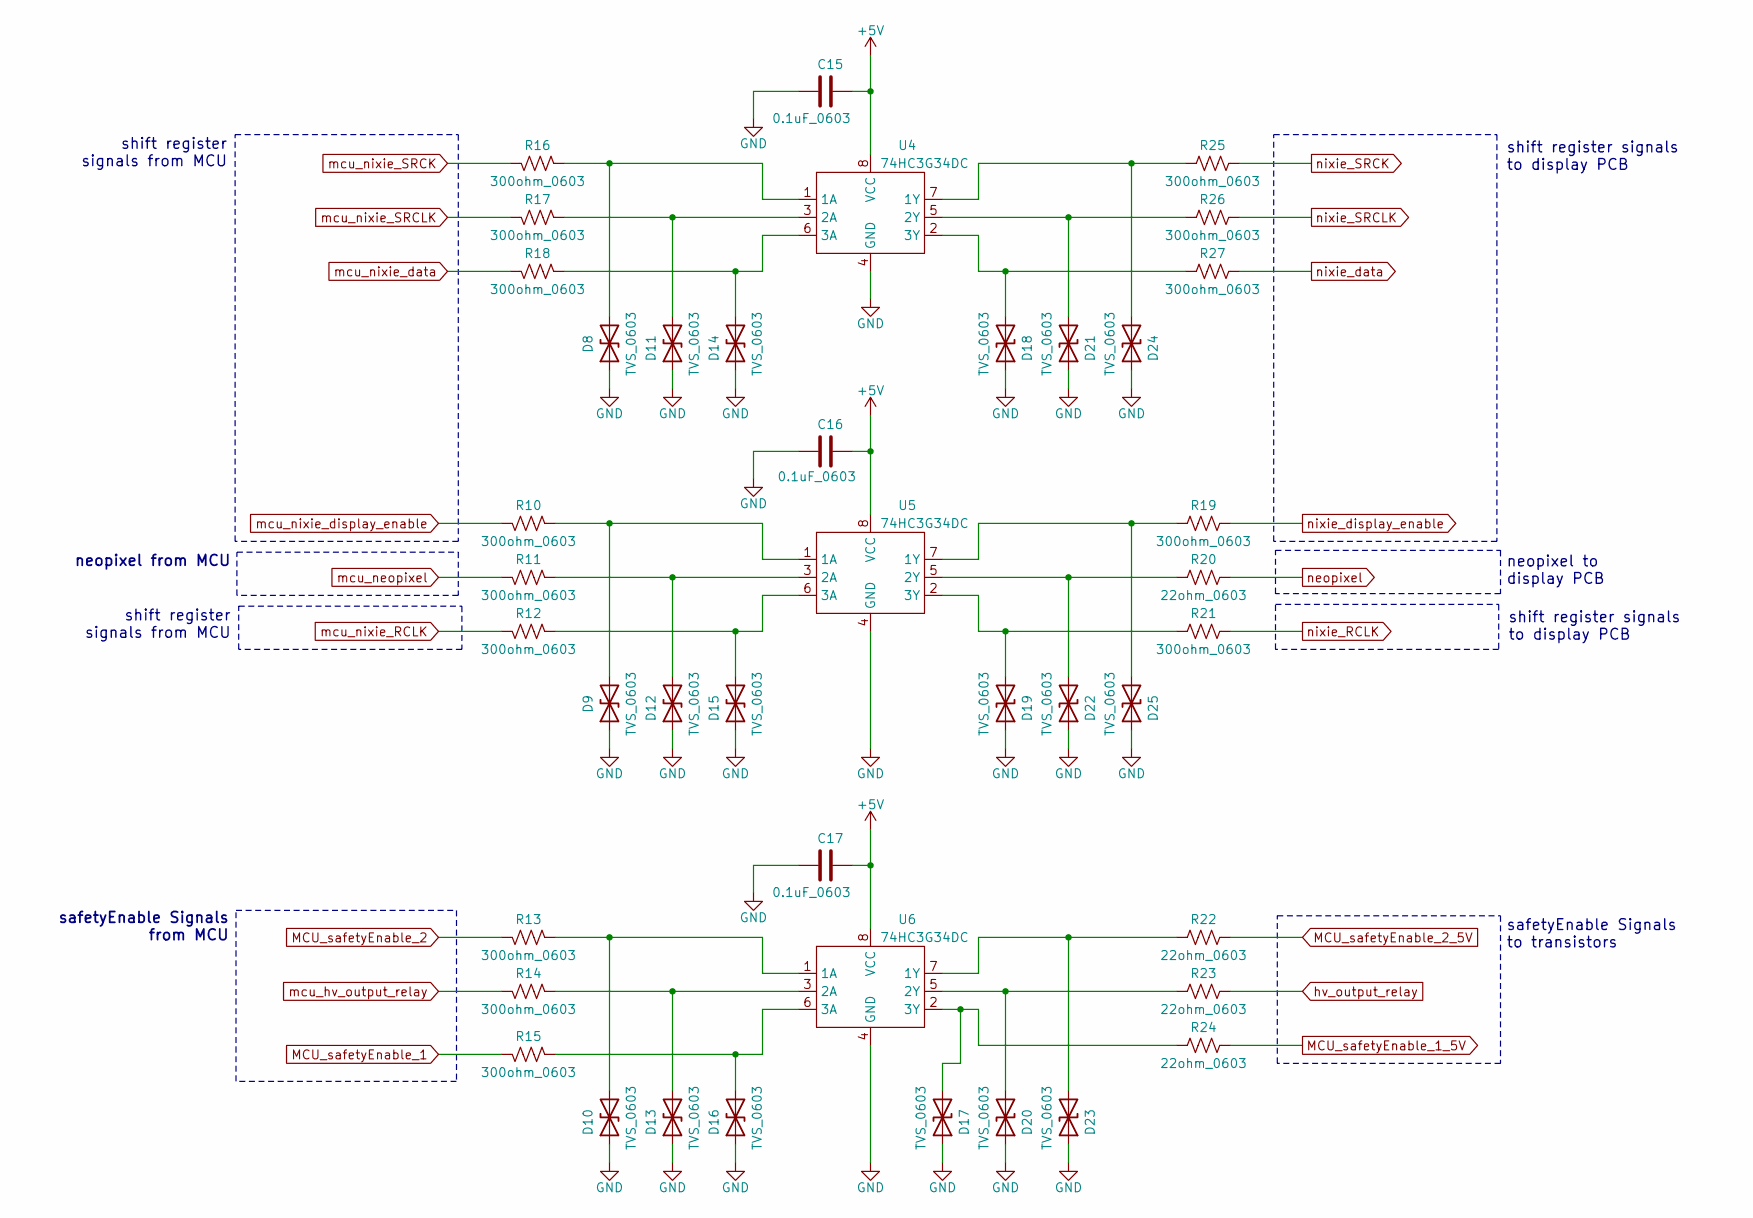
[picture p26: schematic Level Shifting.kicad_sch, 3.3V -> 5.0V Level Shifting]

Parts:
C15, C16, C17: 0.1uF_0603; C_0603_1608Metric
D8, D9, D10, D11, D12, D13, D14, D15, D16, D17, D18, D19, D20, D21, D22, D23, D24, D25: TVS_0603; R_0603_1608Metric
R10, R11, R12, R13, R14, R15, R16, R17, R18, R19, R21, R25, R26, R27: 300ohm_0603; R_0603_1608Metric
R20, R22, R23, R24: 22ohm_0603; R_0603_1608Metric
U4, U5, U6: 74HC3G34DC

Connections:
+5V: C15.1, C16.1, C17.1, U4.8 (VCC), U5.8 (VCC), U6.8 (VCC); also elsewhere on the board
GND: C15.2, C16.2, C17.2, D8.1 (A1), D9.1 (A1), D10.1 (A1), D11.1 (A1), D12.1 (A1), D13.1 (A1), D14.1 (A1), D15.1 (A1), D16.1 (A1), D17.1 (A1), D18.1 (A1), D19.1 (A1), D20.1 (A1), D21.1 (A1), D22.1 (A1), D23.1 (A1), D24.1 (A1), D25.1 (A1), U4.4 (GND), U5.4 (GND), U6.4 (GND); also elsewhere on the board
MCU_safetyEnable_1: R15.2; also elsewhere on the board
MCU_safetyEnable_1_5V: R24.1; also elsewhere on the board
MCU_safetyEnable_2: R13.2; also elsewhere on the board
MCU_safetyEnable_2_5V: R22.1; also elsewhere on the board
unnamed: D8.2 (A2), R16.1, U4.1 (1A)
unnamed: D9.2 (A2), R10.1, U5.1 (1A)
unnamed: D10.2 (A2), R13.1, U6.1 (1A)
unnamed: D11.2 (A2), R17.1, U4.3 (2A)
unnamed: D12.2 (A2), R11.1, U5.3 (2A)
unnamed: D13.2 (A2), R14.1, U6.3 (2A)
unnamed: D14.2 (A2), R18.1, U4.6 (3A)
unnamed: D15.2 (A2), R12.2, U5.6 (3A)
unnamed: D16.2 (A2), R15.1, U6.6 (3A)
unnamed: D17.2 (A2), R24.2, U6.2 (3Y)
unnamed: D18.2 (A2), R27.1, U4.2 (3Y)
unnamed: D19.2 (A2), R21.1, U5.2 (3Y)
unnamed: D20.2 (A2), R23.2, U6.5 (2Y)
unnamed: D21.2 (A2), R26.2, U4.5 (2Y)
unnamed: D22.2 (A2), R20.2, U5.5 (2Y)
unnamed: D23.2 (A2), R22.2, U6.7 (1Y)
unnamed: D24.2 (A2), R25.2, U4.7 (1Y)
unnamed: D25.2 (A2), R19.2, U5.7 (1Y)
hv_output_relay: R23.1; also elsewhere on the board
mcu_hv_output_relay: R14.2; also elsewhere on the board
mcu_neopixel: R11.2; also elsewhere on the board
mcu_nixie_RCLK: R12.1; also elsewhere on the board
mcu_nixie_SRCK: R16.2; also elsewhere on the board
mcu_nixie_SRCLK: R17.2; also elsewhere on the board
mcu_nixie_data: R18.2; also elsewhere on the board
mcu_nixie_display_enable: R10.2; also elsewhere on the board
neopixel: R20.1; also elsewhere on the board
nixie_RCLK: R21.2; also elsewhere on the board
nixie_SRCK: R25.1; also elsewhere on the board
nixie_SRCLK: R26.1; also elsewhere on the board
nixie_data: R27.2; also elsewhere on the board
nixie_display_enable: R19.1; also elsewhere on the board

Notes on the sheet:
safetyEnable Signals from MCU
shift register signals from MCU
shift register signals to display PCB
neopixel to display PCB
neopixel from MCU
safetyEnable Signals to transistors

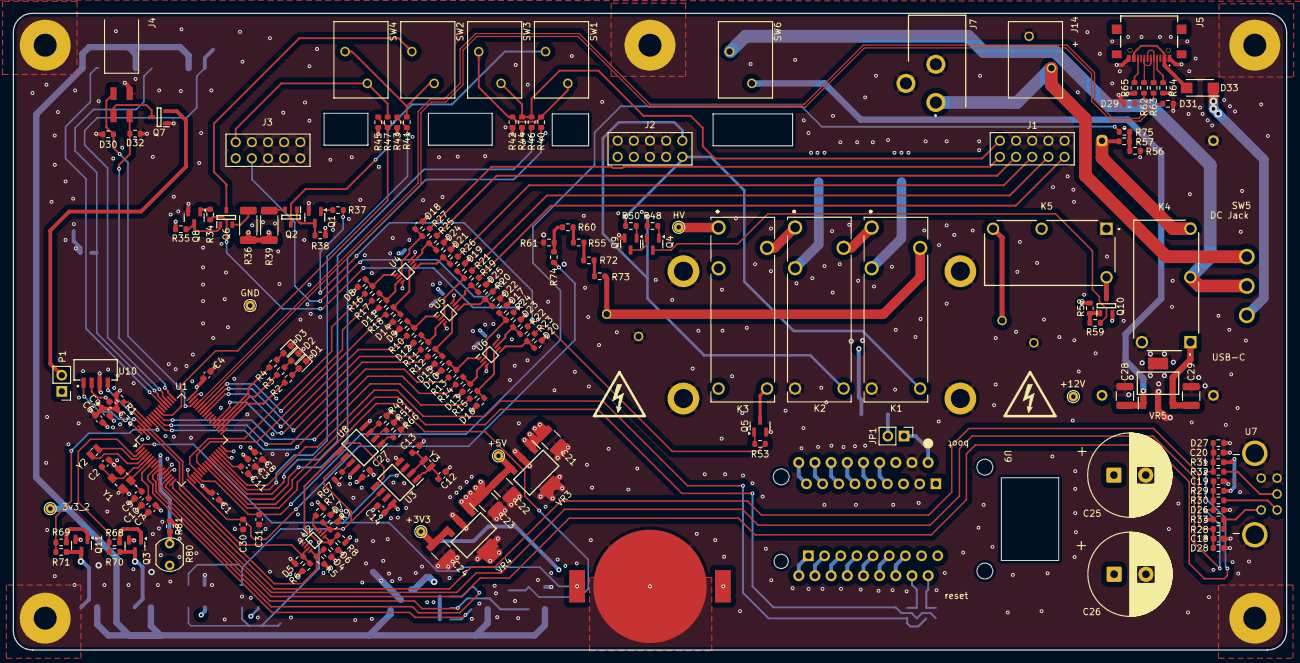
[picture p27: board 64 Bit - Main Board.kicad_pcb from above]

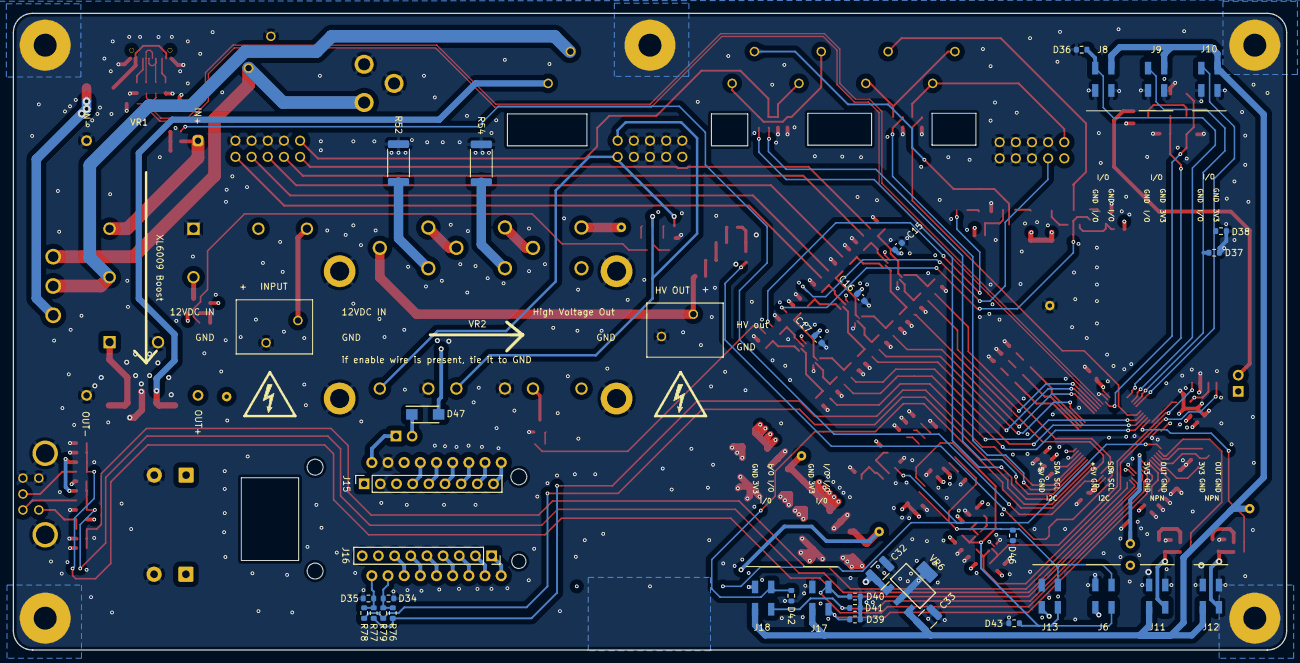
[picture p28: board 64 Bit - Main Board.kicad_pcb from below]

Board: 4 copper layers, 200.0 x 100.0 mm, 233 parts (37 on the bottom side), 162 nets.
