TickingClocks/64-Bit/Electrical/PCB Projects/64 Bit - Display Board/64 Bit - Display Board.kicad_pcb

## KiCad design Electrical/PCB Projects/64 Bit - Display Board/64 Bit - Display Board.kicad_pcb (2025-12-15)

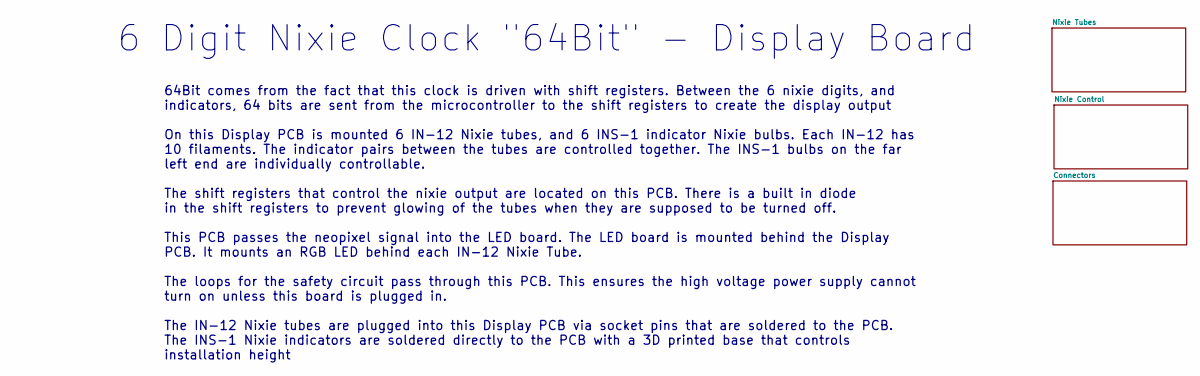
[picture p29: schematic 64 Bit - Display Board.kicad_sch, Project Overview]

Notes on the sheet:
6 Digit Nixie Clock "64Bit" - Display Board
64Bit comes from the fact that this clock is driven with shift registers. Between the 6 nixie digits, and indicators, 64 bits are sent from the microcontroller to the shift registers to create the display output On this Display PCB is mounted 6 IN-12 Nixie tubes, and 6 INS-1 indicator Nixie bulbs. 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

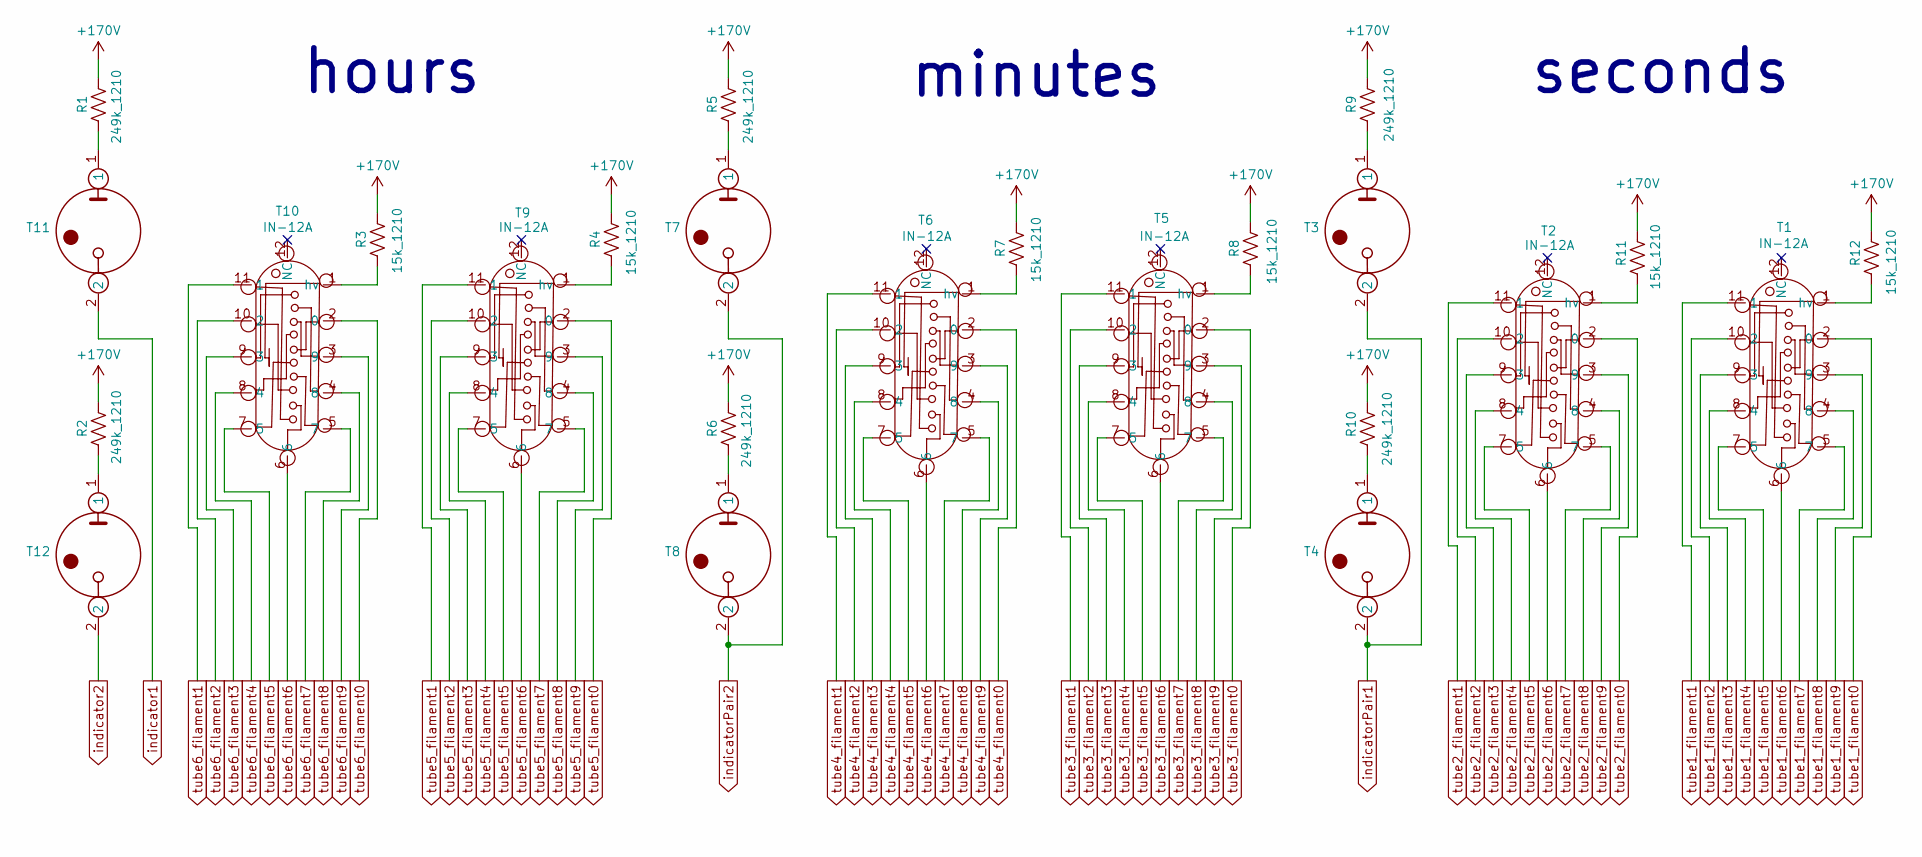
[picture p30: schematic Nixie Tubes.kicad_sch]

Parts:
R1, R2, R5, R6, R9, R10: 249k_1210; C_1210_3225Metric
R3, R4, R7, R8, R11, R12: 15k_1210; C_1210_3225Metric
T1, T2, T5, T6, T9, T10: IN-12A; IN-12
T3, T4, T7, T8, T11, T12: INS-1

Connections:
+170V: R1.1, R2.1, R3.1, R4.1, R5.1, R6.1, R7.1, R8.1, R9.1, R10.1, R11.1, R12.1; also elsewhere on the board
unnamed: R1.2, T11.1
unnamed: R2.2, T12.1
unnamed: R5.2, T7.1
unnamed: R6.2, T8.1
unnamed: R9.2, T3.1
unnamed: R10.2, T4.1
unnamed: R12.2, T1.1 (hv)
unnamed: R11.2, T2.1 (hv)
unnamed: R8.2, T5.1 (hv)
unnamed: R7.2, T6.1 (hv)
unnamed: R4.2, T9.1 (hv)
unnamed: R3.2, T10.1 (hv)
indicator1: T11.2; also elsewhere on the board
indicator2: T12.2; also elsewhere on the board
indicatorPair1: T3.2, T4.2; also elsewhere on the board
indicatorPair2: T7.2, T8.2; also elsewhere on the board
tube1_filament0: T1.2 (0); also elsewhere on the board
tube1_filament1: T1.11 (1); also elsewhere on the board
tube1_filament2: T1.10 (2); also elsewhere on the board
tube1_filament3: T1.9 (3); also elsewhere on the board
tube1_filament4: T1.8 (4); also elsewhere on the board
tube1_filament5: T1.7 (5); also elsewhere on the board
tube1_filament6: T1.6; also elsewhere on the board
tube1_filament7: T1.5 (7); also elsewhere on the board
tube1_filament8: T1.4 (8); also elsewhere on the board
tube1_filament9: T1.3 (9); also elsewhere on the board
tube2_filament0: T2.2 (0); also elsewhere on the board
tube2_filament1: T2.11 (1); also elsewhere on the board
tube2_filament2: T2.10 (2); also elsewhere on the board
tube2_filament3: T2.9 (3); also elsewhere on the board
tube2_filament4: T2.8 (4); also elsewhere on the board
tube2_filament5: T2.7 (5); also elsewhere on the board
tube2_filament6: T2.6; also elsewhere on the board
tube2_filament7: T2.5 (7); also elsewhere on the board
tube2_filament8: T2.4 (8); also elsewhere on the board
tube2_filament9: T2.3 (9); also elsewhere on the board
tube3_filament0: T5.2 (0); also elsewhere on the board
tube3_filament1: T5.11 (1); also elsewhere on the board
tube3_filament2: T5.10 (2); also elsewhere on the board
tube3_filament3: T5.9 (3); also elsewhere on the board
tube3_filament4: T5.8 (4); also elsewhere on the board
tube3_filament5: T5.7 (5); also elsewhere on the board
tube3_filament6: T5.6; also elsewhere on the board
tube3_filament7: T5.5 (7); also elsewhere on the board
tube3_filament8: T5.4 (8); also elsewhere on the board
tube3_filament9: T5.3 (9); also elsewhere on the board
tube4_filament0: T6.2 (0); also elsewhere on the board
tube4_filament1: T6.11 (1); also elsewhere on the board
tube4_filament2: T6.10 (2); also elsewhere on the board
tube4_filament3: T6.9 (3); also elsewhere on the board
tube4_filament4: T6.8 (4); also elsewhere on the board
tube4_filament5: T6.7 (5); also elsewhere on the board
tube4_filament6: T6.6; also elsewhere on the board
tube4_filament7: T6.5 (7); also elsewhere on the board
tube4_filament8: T6.4 (8); also elsewhere on the board
tube4_filament9: T6.3 (9); also elsewhere on the board
tube5_filament0: T9.2 (0); also elsewhere on the board
tube5_filament1: T9.11 (1); also elsewhere on the board
tube5_filament2: T9.10 (2); also elsewhere on the board
tube5_filament3: T9.9 (3); also elsewhere on the board
tube5_filament4: T9.8 (4); also elsewhere on the board
tube5_filament5: T9.7 (5); also elsewhere on the board
tube5_filament6: T9.6; also elsewhere on the board
tube5_filament7: T9.5 (7); also elsewhere on the board
tube5_filament8: T9.4 (8); also elsewhere on the board
tube5_filament9: T9.3 (9); also elsewhere on the board
tube6_filament0: T10.2 (0); also elsewhere on the board
tube6_filament1: T10.11 (1); also elsewhere on the board
tube6_filament2: T10.10 (2); also elsewhere on the board
tube6_filament3: T10.9 (3); also elsewhere on the board
tube6_filament4: T10.8 (4); also elsewhere on the board
tube6_filament5: T10.7 (5); also elsewhere on the board
tube6_filament6: T10.6; also elsewhere on the board
tube6_filament7: T10.5 (7); also elsewhere on the board
tube6_filament8: T10.4 (8); also elsewhere on the board
tube6_filament9: T10.3 (9); also elsewhere on the board

Notes on the sheet:
minutes
seconds
hours

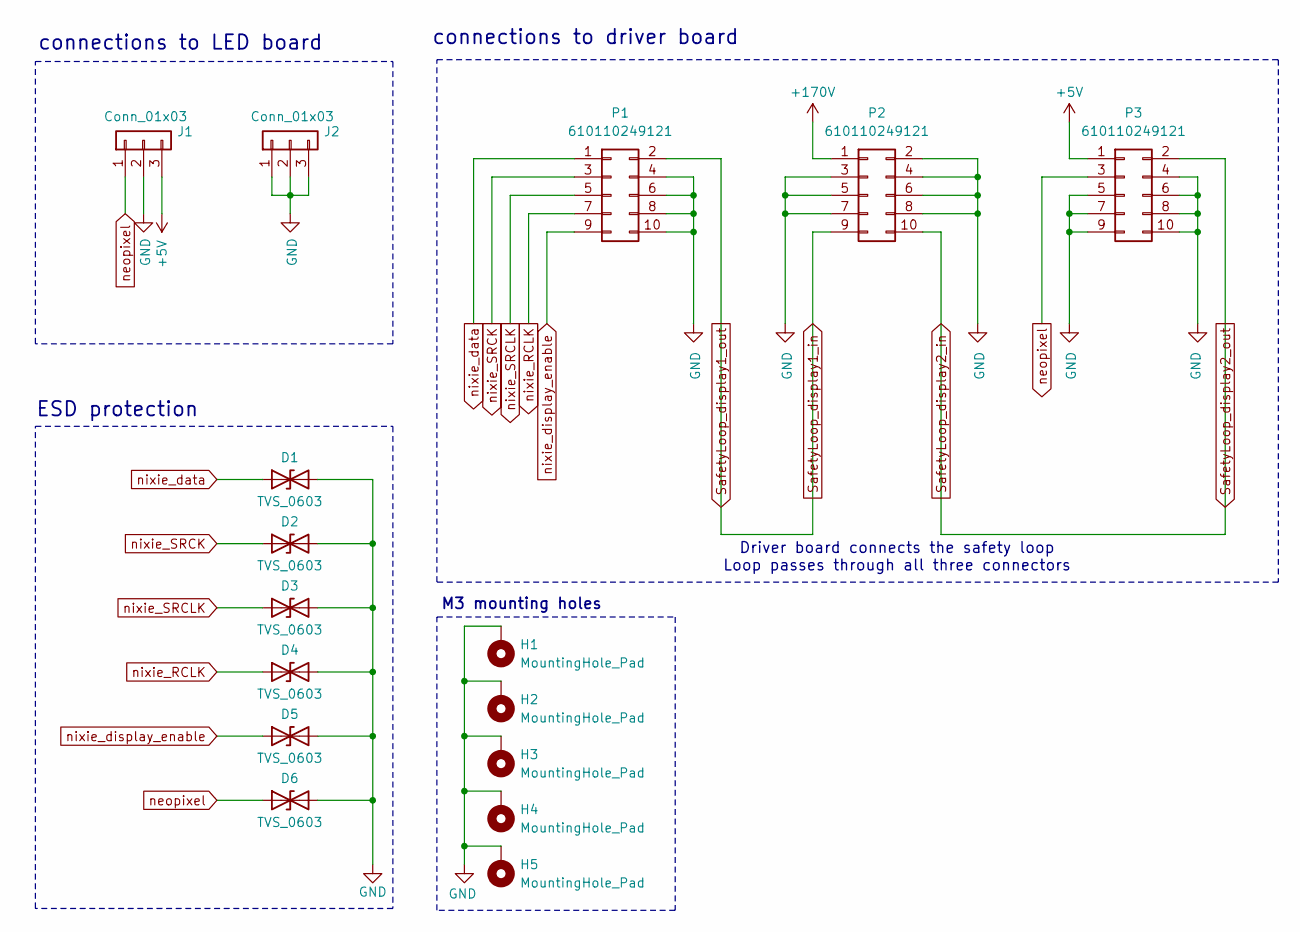
[picture p31: schematic Connectors.kicad_sch]

Parts:
D1, D2, D3, D4, D5, D6: TVS_0603; R_0603_1608Metric
H1, H2, H3, H4, H5: MountingHole_Pad; M3 Standoff Footprint
J1, J2: Conn_01x03; PinSocket_1x03_P2.54mm_Vertical
P1, P2, P3: 610110249121

Connections:
+5V: J1.3, P3.1; also elsewhere on the board
+170V: P2.1; also elsewhere on the board
GND: D1.2 (A2), D2.2 (A2), D3.2 (A2), D4.2 (A2), D5.2 (A2), D6.2 (A2), H1.1, H2.1, H3.1, H4.1, H5.1, J1.2, J2.1, J2.2, J2.3, P1.4, P1.6, P1.8, P1.10, P2.2, P2.3, P2.4, P2.5, P2.6, P2.7, P2.8, P3.4, P3.5, P3.6, P3.7, P3.8, P3.9, P3.10; also elsewhere on the board
SafetyLoop_display1_in: P1.2, P2.9
SafetyLoop_display2_in: P2.10, P3.2
neopixel: D6.1 (A1), J1.1, P3.3
nixie_RCLK: D4.1 (A1), P1.7; also elsewhere on the board
nixie_SRCK: D2.1 (A1), P1.3; also elsewhere on the board
nixie_SRCLK: D3.1 (A1), P1.5; also elsewhere on the board
nixie_data: D1.1 (A1), P1.1; also elsewhere on the board
nixie_display_enable: D5.1 (A1), P1.9; also elsewhere on the board

Notes on the sheet:
Driver board connects the safety loop Loop passes through all three connectors
connections to driver board
connections to LED board
ESD protection
M3 mounting holes

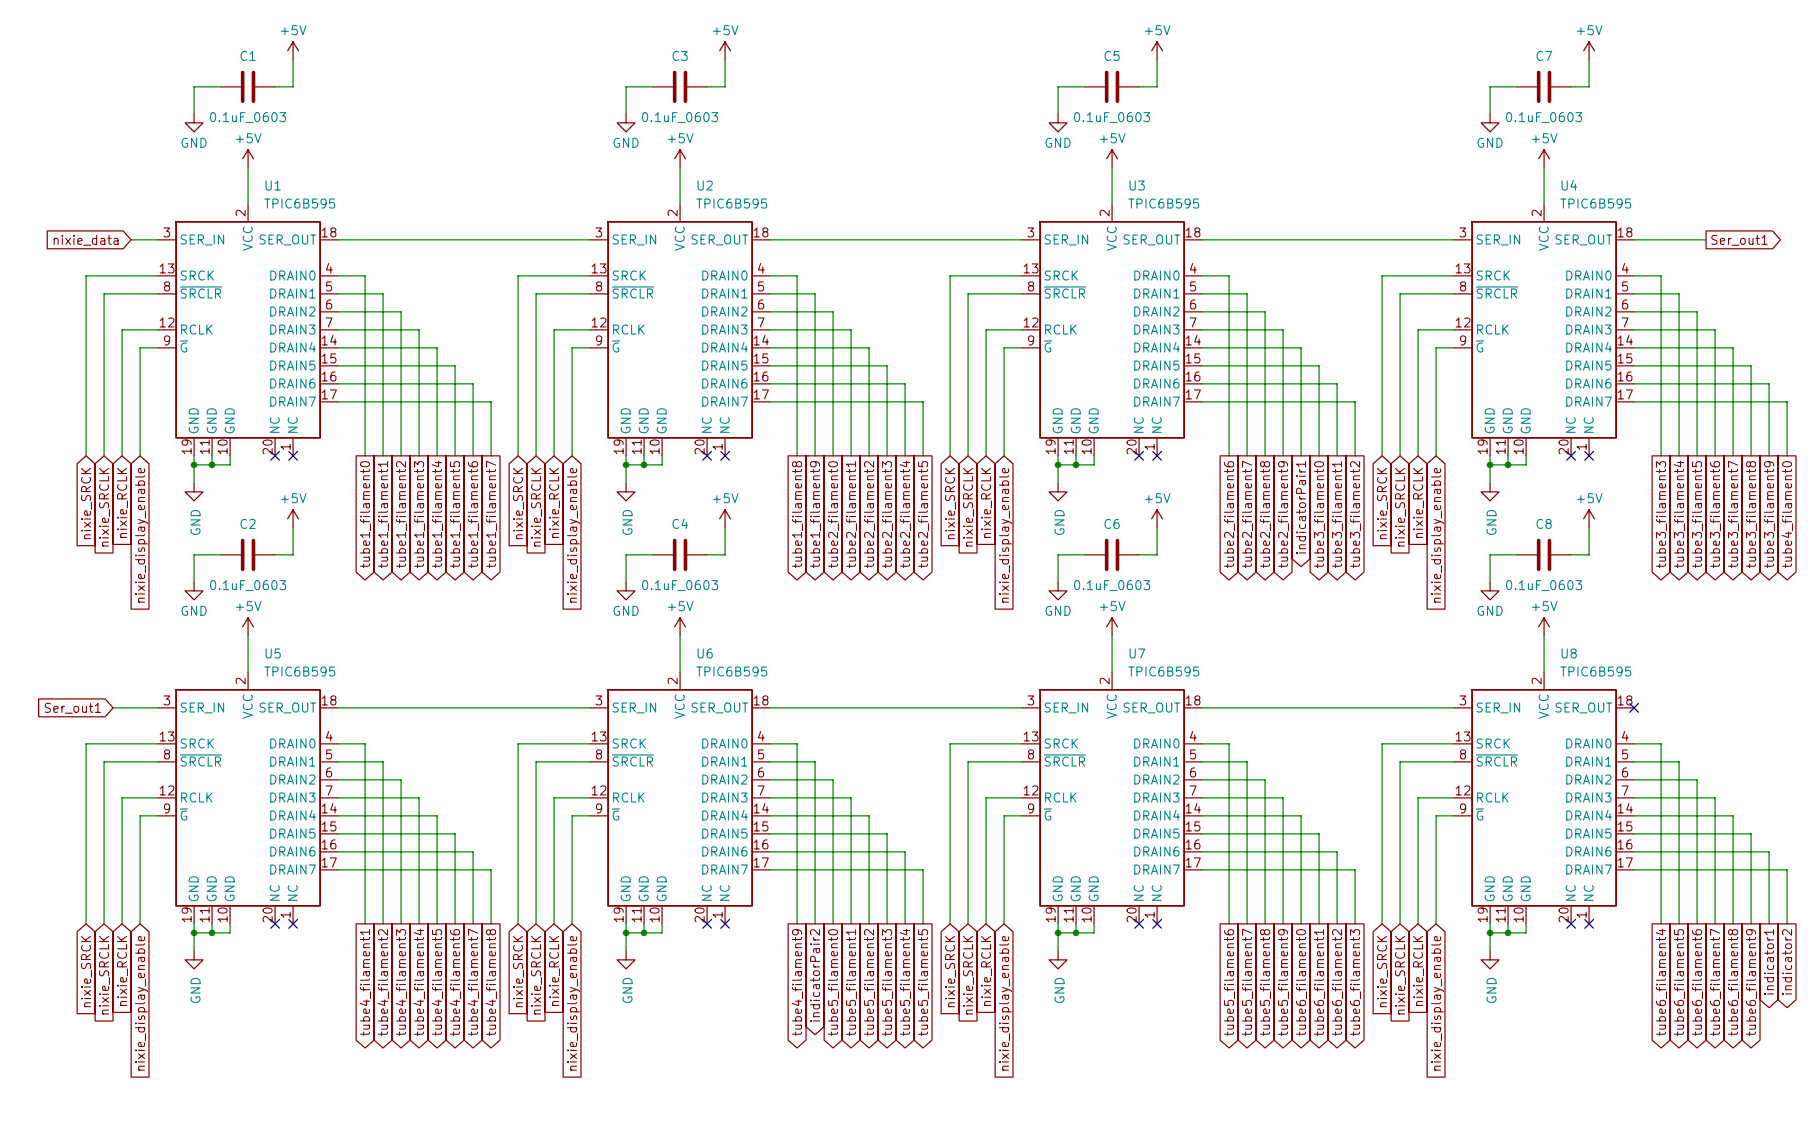
[picture p32: schematic Nixie Control.kicad_sch, Nixie Control - Shift Register]

Parts:
C1, C2, C3, C4, C5, C6, C7, C8: 0.1uF_0603; C_0603_1608Metric
U1, U2, U3, U4, U5, U6, U7, U8: TPIC6B595; TPIC6B595DWR

Connections:
+5V: C1.2, C2.2, C3.2, C4.2, C5.2, C6.2, C7.2, C8.2, U1.2 (VCC), U2.2 (VCC), U3.2 (VCC), U4.2 (VCC), U5.2 (VCC), U6.2 (VCC), U7.2 (VCC), U8.2 (VCC); also elsewhere on the board
GND: C1.1, C2.1, C3.1, C4.1, C5.1, C6.1, C7.1, C8.1, U1.10 (GND), U1.11 (GND), U1.19 (GND), U2.10 (GND), U2.11 (GND), U2.19 (GND), U3.10 (GND), U3.11 (GND), U3.19 (GND), U4.10 (GND), U4.11 (GND), U4.19 (GND), U5.10 (GND), U5.11 (GND), U5.19 (GND), U6.10 (GND), U6.11 (GND), U6.19 (GND), U7.10 (GND), U7.11 (GND), U7.19 (GND), U8.10 (GND), U8.11 (GND), U8.19 (GND); also elsewhere on the board
unnamed: U1.18 (SER_OUT), U2.3 (SER_IN)
unnamed: U2.18 (SER_OUT), U3.3 (SER_IN)
unnamed: U3.18 (SER_OUT), U4.3 (SER_IN)
unnamed: U5.18 (SER_OUT), U6.3 (SER_IN)
unnamed: U6.18 (SER_OUT), U7.3 (SER_IN)
unnamed: U7.18 (SER_OUT), U8.3 (SER_IN)
Ser_out1: U4.18 (SER_OUT), U5.3 (SER_IN)
indicator1: U8.16 (DRAIN6); also elsewhere on the board
indicator2: U8.17 (DRAIN7); also elsewhere on the board
indicatorPair1: U3.14 (DRAIN4); also elsewhere on the board
indicatorPair2: U6.5 (DRAIN1); also elsewhere on the board
nixie_RCLK: U1.12 (RCLK), U2.12 (RCLK), U3.12 (RCLK), U4.12 (RCLK), U5.12 (RCLK), U6.12 (RCLK), U7.12 (RCLK), U8.12 (RCLK); also elsewhere on the board
nixie_SRCK: U1.13 (SRCK), U2.13 (SRCK), U3.13 (SRCK), U4.13 (SRCK), U5.13 (SRCK), U6.13 (SRCK), U7.13 (SRCK), U8.13 (SRCK); also elsewhere on the board
nixie_SRCLK: U1.8 (~SRCLR), U2.8 (~SRCLR), U3.8 (~SRCLR), U4.8 (~SRCLR), U5.8 (~SRCLR), U6.8 (~SRCLR), U7.8 (~SRCLR), U8.8 (~SRCLR); also elsewhere on the board
nixie_data: U1.3 (SER_IN); also elsewhere on the board
nixie_display_enable: U1.9 (~G), U2.9 (~G), U3.9 (~G), U4.9 (~G), U5.9 (~G), U6.9 (~G), U7.9 (~G), U8.9 (~G); also elsewhere on the board
tube1_filament0: U1.4 (DRAIN0); also elsewhere on the board
tube1_filament1: U1.5 (DRAIN1); also elsewhere on the board
tube1_filament2: U1.6 (DRAIN2); also elsewhere on the board
tube1_filament3: U1.7 (DRAIN3); also elsewhere on the board
tube1_filament4: U1.14 (DRAIN4); also elsewhere on the board
tube1_filament5: U1.15 (DRAIN5); also elsewhere on the board
tube1_filament6: U1.16 (DRAIN6); also elsewhere on the board
tube1_filament7: U1.17 (DRAIN7); also elsewhere on the board
tube1_filament8: U2.4 (DRAIN0); also elsewhere on the board
tube1_filament9: U2.5 (DRAIN1); also elsewhere on the board
tube2_filament0: U2.6 (DRAIN2); also elsewhere on the board
tube2_filament1: U2.7 (DRAIN3); also elsewhere on the board
tube2_filament2: U2.14 (DRAIN4); also elsewhere on the board
tube2_filament3: U2.15 (DRAIN5); also elsewhere on the board
tube2_filament4: U2.16 (DRAIN6); also elsewhere on the board
tube2_filament5: U2.17 (DRAIN7); also elsewhere on the board
tube2_filament6: U3.4 (DRAIN0); also elsewhere on the board
tube2_filament7: U3.5 (DRAIN1); also elsewhere on the board
tube2_filament8: U3.6 (DRAIN2); also elsewhere on the board
tube2_filament9: U3.7 (DRAIN3); also elsewhere on the board
tube3_filament0: U3.15 (DRAIN5); also elsewhere on the board
tube3_filament1: U3.16 (DRAIN6); also elsewhere on the board
tube3_filament2: U3.17 (DRAIN7); also elsewhere on the board
tube3_filament3: U4.4 (DRAIN0); also elsewhere on the board
tube3_filament4: U4.5 (DRAIN1); also elsewhere on the board
tube3_filament5: U4.6 (DRAIN2); also elsewhere on the board
tube3_filament6: U4.7 (DRAIN3); also elsewhere on the board
tube3_filament7: U4.14 (DRAIN4); also elsewhere on the board
tube3_filament8: U4.15 (DRAIN5); also elsewhere on the board
tube3_filament9: U4.16 (DRAIN6); also elsewhere on the board
tube4_filament0: U4.17 (DRAIN7); also elsewhere on the board
tube4_filament1: U5.4 (DRAIN0); also elsewhere on the board
tube4_filament2: U5.5 (DRAIN1); also elsewhere on the board
tube4_filament3: U5.6 (DRAIN2); also elsewhere on the board
tube4_filament4: U5.7 (DRAIN3); also elsewhere on the board
tube4_filament5: U5.14 (DRAIN4); also elsewhere on the board
tube4_filament6: U5.15 (DRAIN5); also elsewhere on the board
tube4_filament7: U5.16 (DRAIN6); also elsewhere on the board
tube4_filament8: U5.17 (DRAIN7); also elsewhere on the board
tube4_filament9: U6.4 (DRAIN0); also elsewhere on the board
tube5_filament0: U6.6 (DRAIN2); also elsewhere on the board
tube5_filament1: U6.7 (DRAIN3); also elsewhere on the board
tube5_filament2: U6.14 (DRAIN4); also elsewhere on the board
tube5_filament3: U6.15 (DRAIN5); also elsewhere on the board
tube5_filament4: U6.16 (DRAIN6); also elsewhere on the board
tube5_filament5: U6.17 (DRAIN7); also elsewhere on the board
tube5_filament6: U7.4 (DRAIN0); also elsewhere on the board
tube5_filament7: U7.5 (DRAIN1); also elsewhere on the board
tube5_filament8: U7.6 (DRAIN2); also elsewhere on the board
tube5_filament9: U7.7 (DRAIN3); also elsewhere on the board
tube6_filament0: U7.14 (DRAIN4); also elsewhere on the board
tube6_filament1: U7.15 (DRAIN5); also elsewhere on the board
tube6_filament2: U7.16 (DRAIN6); also elsewhere on the board
tube6_filament3: U7.17 (DRAIN7); also elsewhere on the board
tube6_filament4: U8.4 (DRAIN0); also elsewhere on the board
tube6_filament5: U8.5 (DRAIN1); also elsewhere on the board
tube6_filament6: U8.6 (DRAIN2); also elsewhere on the board
tube6_filament7: U8.7 (DRAIN3); also elsewhere on the board
tube6_filament8: U8.14 (DRAIN4); also elsewhere on the board
tube6_filament9: U8.15 (DRAIN5); also elsewhere on the board
