TickingClocks/64-Bit/Electrical/PCB Projects/64 Bit - Display Board/64 Bit - Display Board.kicad_pcb

## KiCad design Electrical/PCB Projects/64 Bit - Display Board/64 Bit - Display Board.kicad_pcb (continued)

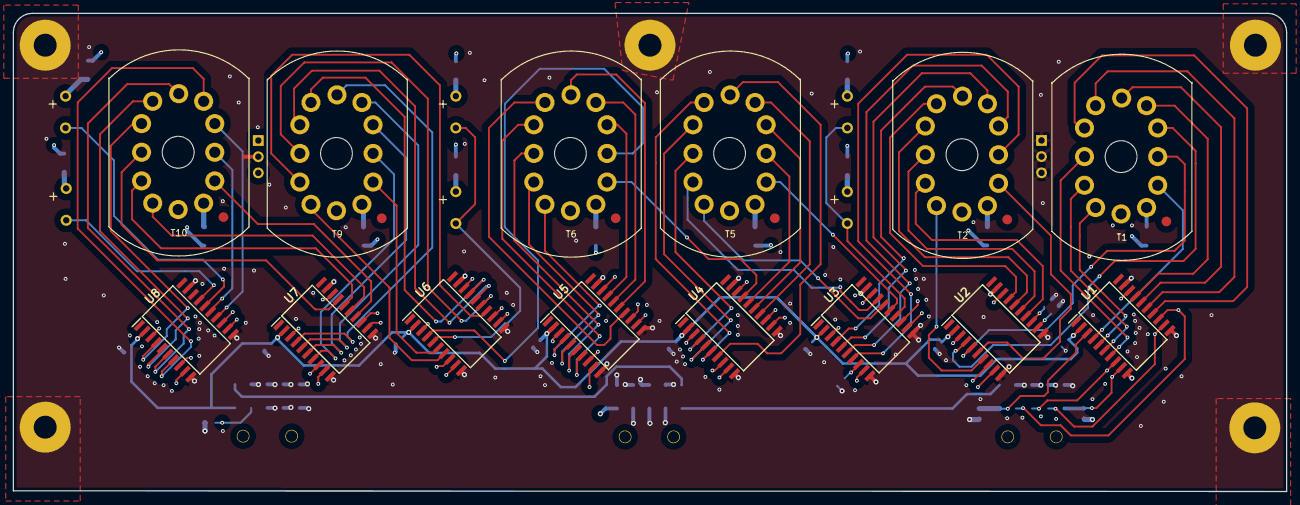
[picture p33: board 64 Bit - Display Board.kicad_pcb from above]

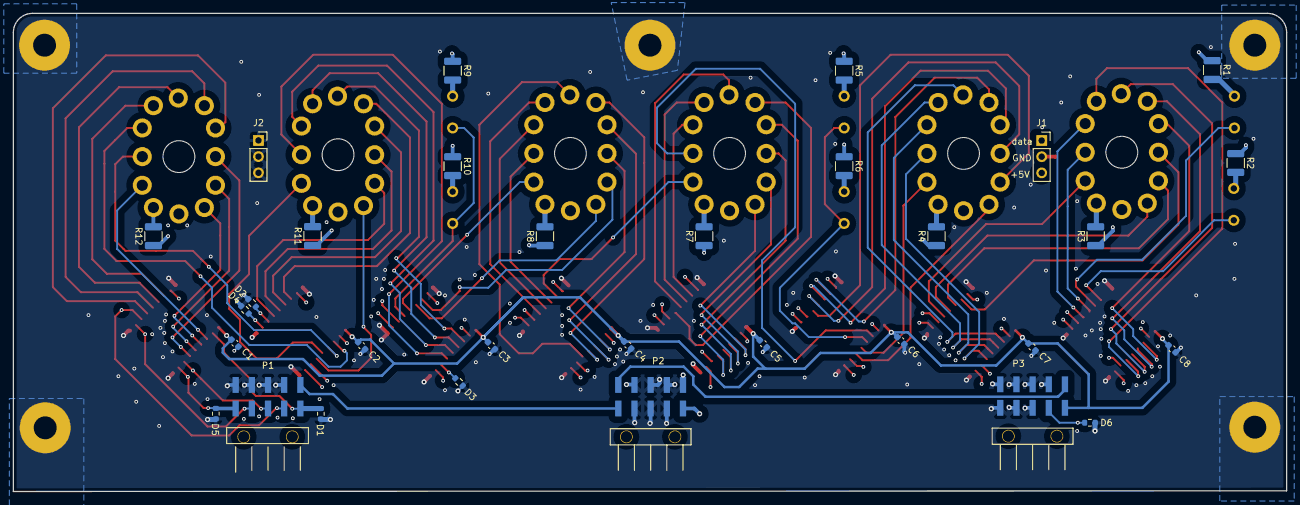
[picture p34: board 64 Bit - Display Board.kicad_pcb from below]

Board: 4 copper layers, 200.0 x 75.1 mm, 56 parts (31 on the bottom side), 94 nets.
