TickingClocks/64-Bit/Firmware/STM32/Projects/64 Bit - GettingStarted/64 Bit - GettingStarted.ioc

Mcu.UserName=STM32F446RETx
PA0-WKUP.Signal=S_TIM2_CH1_ETR
PA1.Signal=S_TIM2_CH2
PA10.GPIO_Label=nixie_SRCLK
PA10.Signal=GPIO_Output
PA11.Signal=USB_OTG_FS_DM
PA12.Signal=USB_OTG_FS_DP
PA13.Signal=SYS_JTMS-SWDIO
PA14.Signal=SYS_JTCK-SWCLK
PA2.GPIO_Label=button_encoder
PA2.Signal=GPIO_Output
PA3.Signal=ADCx_IN3
PA4.Signal=ADCx_IN4
PA5.Signal=SPI1_SCK
PA7.Signal=SPI1_MOSI
PA8.GPIO_Label=nixie_display_enable
PA8.Signal=GPIO_Output
PA9.GPIO_Label=nixie_RCLK
PA9.Signal=GPIO_Output
PB0.GPIO_Label=safetyStatus1
PB0.Signal=GPIO_Input
PB1.GPIO_Label=safetyStatus2
PB1.Signal=GPIO_Input
PB10.Signal=USART3_TX
PB13.GPIO_Label=led1
PB13.Signal=GPIO_Output
PB14.GPIO_Label=led2
PB14.Signal=GPIO_Output
PB15.GPIO_Label=led3
PB15.Signal=GPIO_Output
PB2.GPIO_Label=safetyStatus3
PB2.Signal=GPIO_Input
PB3.GPIO_Label=safetyStatus4
PB3.Signal=GPIO_Input
PB4.GPIO_Label=safetyEnable1
PB4.Signal=GPIO_Output
PB5.GPIO_Label=safetyEnable2
PB5.Signal=GPIO_Output
PB6.GPIO_Label=hvOutputRelay
PB6.Signal=GPIO_Output
PB7.GPIO_Label=IO5
PB7.Signal=GPIO_Output
PB8.Signal=I2C1_SCL
PB9.Signal=I2C1_SDA
PC0.Signal=ADCx_IN10
PC1.GPIO_Label=IO6
PC1.Signal=GPIO_Input
PC10.GPIO_Label=IO1
PC10.Signal=GPIO_Output
PC11.GPIO_Label=IO2
PC11.Signal=GPIO_Output
PC12.GPIO_Label=IO3
PC12.Signal=GPIO_Output
PC13.GPIO_Label=IO4
PC13.Signal=GPIO_Output
PC14-OSC32_IN.Signal=RCC_OSC32_IN
PC15-OSC32_OUT.Signal=RCC_OSC32_OUT
PC2.GPIO_Label=IO7
PC2.Signal=GPIO_Input
PC3.GPIO_Label=IO8
PC3.Signal=GPIO_Input
PC5.Signal=USART3_RX
PC6.GPIO_Label=neopixel
PC6.Signal=S_TIM3_CH1
PH0-OSC_IN.Signal=RCC_OSC_IN
PH1-OSC_OUT.Signal=RCC_OSC_OUT
