TickingClocks/64-Bit/Firmware/STM32/Projects/64 Bit - GettingStarted/Core/Inc/main.h

#define IO4_Pin GPIO_PIN_13
#define IO4_GPIO_Port GPIOC
#define IO6_Pin GPIO_PIN_1
#define IO6_GPIO_Port GPIOC
#define IO7_Pin GPIO_PIN_2
#define IO7_GPIO_Port GPIOC
#define IO8_Pin GPIO_PIN_3
#define IO8_GPIO_Port GPIOC
#define button_encoder_Pin GPIO_PIN_2
#define button_encoder_GPIO_Port GPIOA
#define safetyStatus1_Pin GPIO_PIN_0
#define safetyStatus1_GPIO_Port GPIOB
#define safetyStatus2_Pin GPIO_PIN_1
#define safetyStatus2_GPIO_Port GPIOB
#define safetyStatus3_Pin GPIO_PIN_2
#define safetyStatus3_GPIO_Port GPIOB
#define led1_Pin GPIO_PIN_13
#define led1_GPIO_Port GPIOB
#define led2_Pin GPIO_PIN_14
#define led2_GPIO_Port GPIOB
#define led3_Pin GPIO_PIN_15
#define led3_GPIO_Port GPIOB
#define neopixel_Pin GPIO_PIN_6
#define neopixel_GPIO_Port GPIOC
#define nixie_display_enable_Pin GPIO_PIN_8
#define nixie_display_enable_GPIO_Port GPIOA
#define nixie_RCLK_Pin GPIO_PIN_9
#define nixie_RCLK_GPIO_Port GPIOA
#define nixie_SRCLK_Pin GPIO_PIN_10
#define nixie_SRCLK_GPIO_Port GPIOA
#define IO1_Pin GPIO_PIN_10
#define IO1_GPIO_Port GPIOC
#define IO2_Pin GPIO_PIN_11
#define IO2_GPIO_Port GPIOC
#define IO3_Pin GPIO_PIN_12
#define IO3_GPIO_Port GPIOC
#define safetyStatus4_Pin GPIO_PIN_3
#define safetyStatus4_GPIO_Port GPIOB
#define safetyEnable1_Pin GPIO_PIN_4
#define safetyEnable1_GPIO_Port GPIOB
#define safetyEnable2_Pin GPIO_PIN_5
#define safetyEnable2_GPIO_Port GPIOB
#define hvOutputRelay_Pin GPIO_PIN_6
#define hvOutputRelay_GPIO_Port GPIOB
#define IO5_Pin GPIO_PIN_7
#define IO5_GPIO_Port GPIOB
