TickingClocks/64-Bit/(commit log)

2025-11-21 simple text update in sch proj, git test
    [64 Bit - Main Board.kicad_sch]
2025-11-21 output a new pdf schematic for the mainboard (practicing git)
2025-11-21 fixed folder layout for STM32 projects. Workspace folder should not be in the git directory
    [64 Bit - GettingStarted.ioc, main.h]
2025-11-21 added blinky to stm32 project
2025-11-22 finalized schematic, made ESP32 footprint, started PCB update
    [64 Bit - Main Board.kicad_pcb, Connectors.kicad_sch, STM32 MCU.kicad_sch]
2025-11-22 save for night
    [64 Bit - Main Board.kicad_pcb]
2025-11-22 ran 3D model consolidate plugin
    [64 Bit - Main Board.kicad_pcb]
2025-11-23 small pcb layout work
    [64 Bit - Main Board.kicad_pcb, Connectors.kicad_sch]
2025-11-24 finished routing - added photoresistor to analog pin. Updated STM32Cube setup. Final stages of hardware design
    [64 Bit - Main Board.kicad_pcb, Connectors 2.kicad_sch, Interface.kicad_sch, STM32 MCU.kicad_sch]
2025-11-25 update main description text on front page of schematic
    [64 Bit - Main Board.kicad_sch]
2025-11-28 added I2C ambient light sensor
    [64 Bit - Main Board.kicad_pcb, I2C.kicad_sch]
2025-12-02 near final state. Includes BOM, price, etc
    [64 Bit - Display Board.kicad_pcb, 64 Bit - Display Board.kicad_sch, 64 Bit - LED Board.kicad_pcb, 64 Bit - LED Board.kicad_sch, 64 Bit - Main Board.kicad_pcb, 64 Bit - Main Board.kicad_sch, BOM and Cost.xlsx, Connectors 2.kicad_sch]
2025-12-05 slight change to copper pours.
    [64 Bit - Display Board.kicad_pcb]
2025-12-06 slight changes
    [64 Bit - Display Board.kicad_pcb, 64 Bit - Display Board.kicad_sch, 64 Bit - Main Board.kicad_pcb, Connectors 2.kicad_sch, Connectors.kicad_sch, Level Shifting.kicad_sch, Safety Circuit.kicad_sch]
2025-12-07 final. PCB outputs generated, ordering prototypes
    [64 Bit - Display Board-B_Cu.gbr, 64 Bit - Display Board-B_Mask.gbr, 64 Bit - Display Board-B_Paste.gbr, 64 Bit - Display Board-B_Silkscreen.gbr, 64 Bit - Display Board-Edge_Cuts.gbr, 64 Bit - Display Board-F_Cu.gbr, 64 Bit - Display Board-F_Mask.gbr, 64 Bit - Display Board-F_Paste.gbr]
2025-12-15 added standoffs, updates to 3D exports. starting prototyping/verification 3D printed stand next
    [64 Bit - Display Board.kicad_pcb, 64 Bit - Main Board.kicad_pcb, 64 Bit - main board V1 (basic)_barePCB.step, 64 Bit - main board V1_barePCB.step, 64 Bit Display Board.step, 64 Bit Display Board_BlankPCB.step, 64 Bit LED Board_V1.step, 64Bit - Display Board - Paste and assembly jig_V1.SLDPRT]
2025-12-15 footprints managment
    [64 Bit - Display Board.kicad_pcb, 64 Bit - Main Board.kicad_pcb]
2025-12-22 adding comments after build. Documentation for next revision
    [64 Bit - LED Board.kicad_pcb, 64 Bit LED Board_V1.step, INS-1 standdoff.SLDPRT, INS-1 standdoff_v2.STEP, INS-1 standdoff_v3.STEP, INS-1 standdoff_v4.STEP, Power.kicad_sch, Safety Circuit.kicad_sch]
2025-12-25 mistake found in the safety circuit. The AND gate is mis-designed for mosfets. Two Pchannel mosfets need to be added and the output signal then inverted. These were added via wires to the hardware an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
    [Safety Circuit.kicad_sch]
