TickingClocks/64-Bit/(notices)

Notices in the files:
Firmware/STM32/Projects/64 Bit - GettingStarted/Core/Inc/main.h:
Copyright (c) 2025 STMicroelectronics.
All rights reserved.
This software is licensed under terms that can be found in the LICENSE file
